lkebnl/CE_HLM/layout_all.png

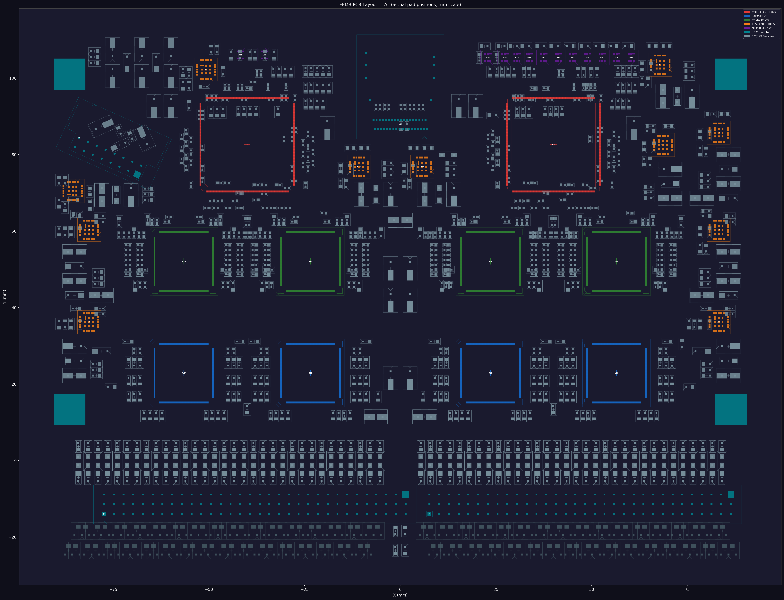
layout_all.png
