lkebnl/CE_HLM/layout_back_All.png

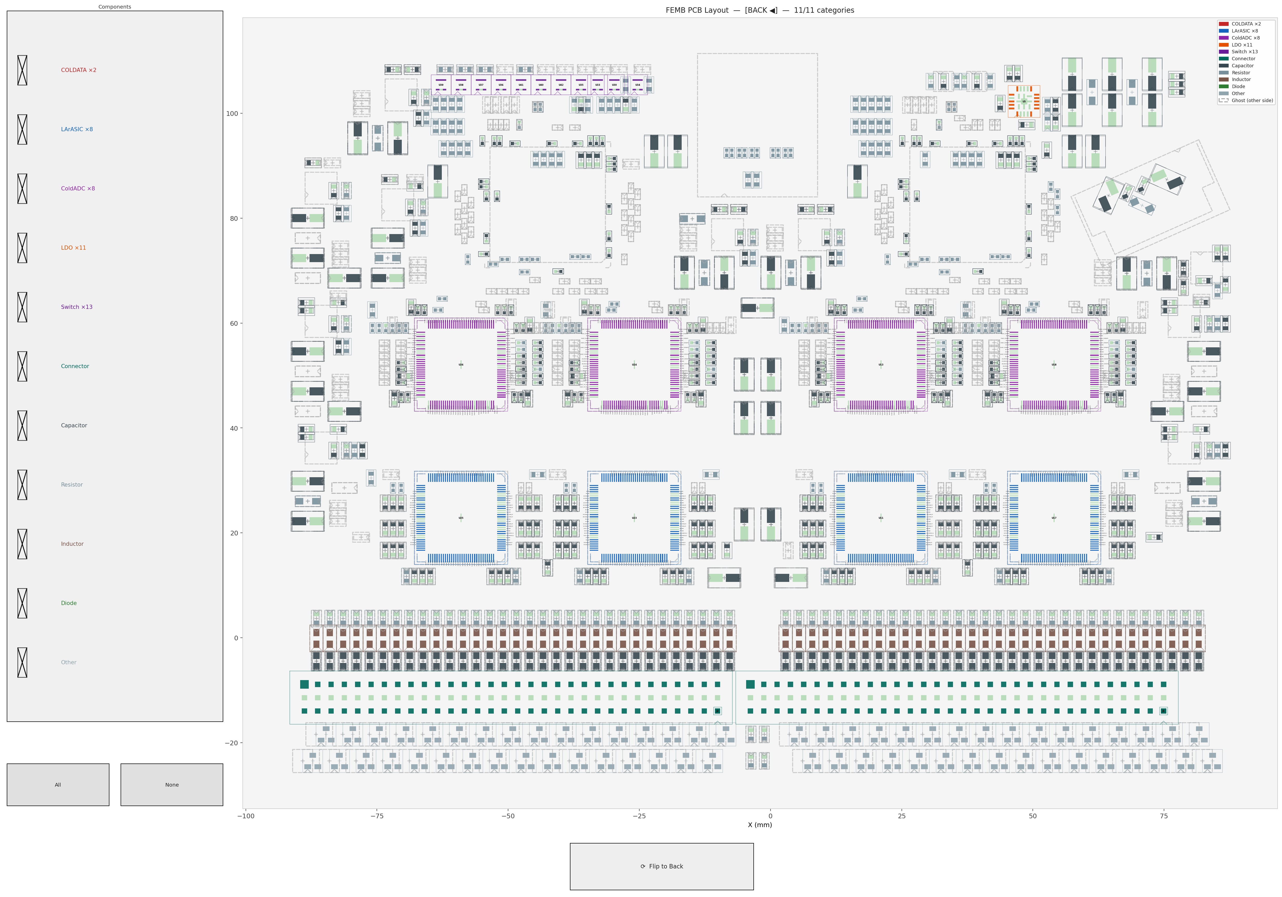
layout_back_All.png
