lkebnl/CE_HLM/layout_back_ICs.png

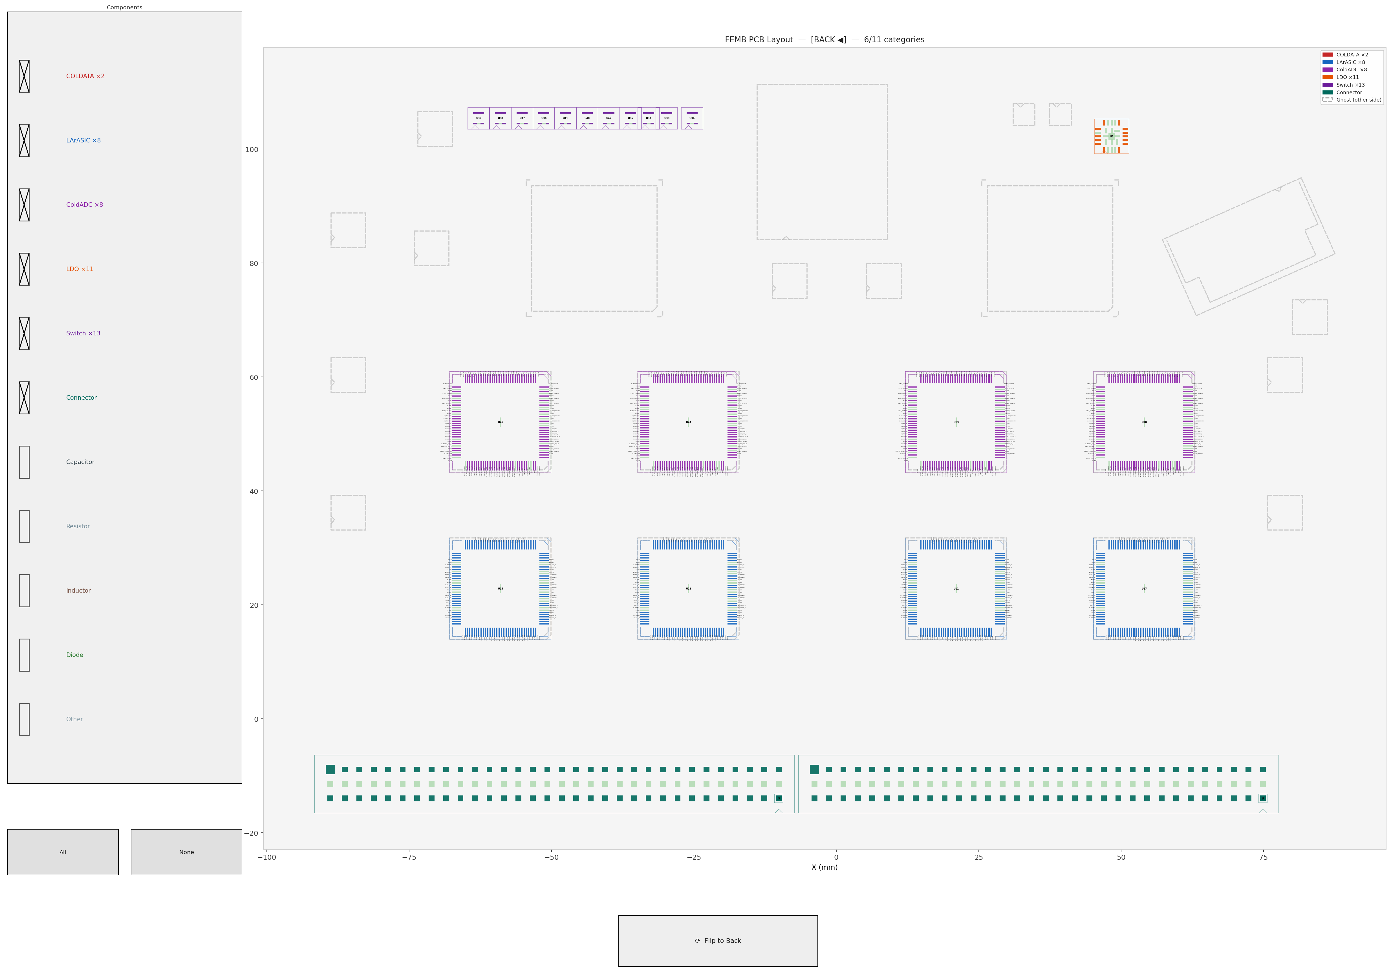
layout_back_ICs.png
