lkebnl/CE_HLM/layout_back_UJP.png

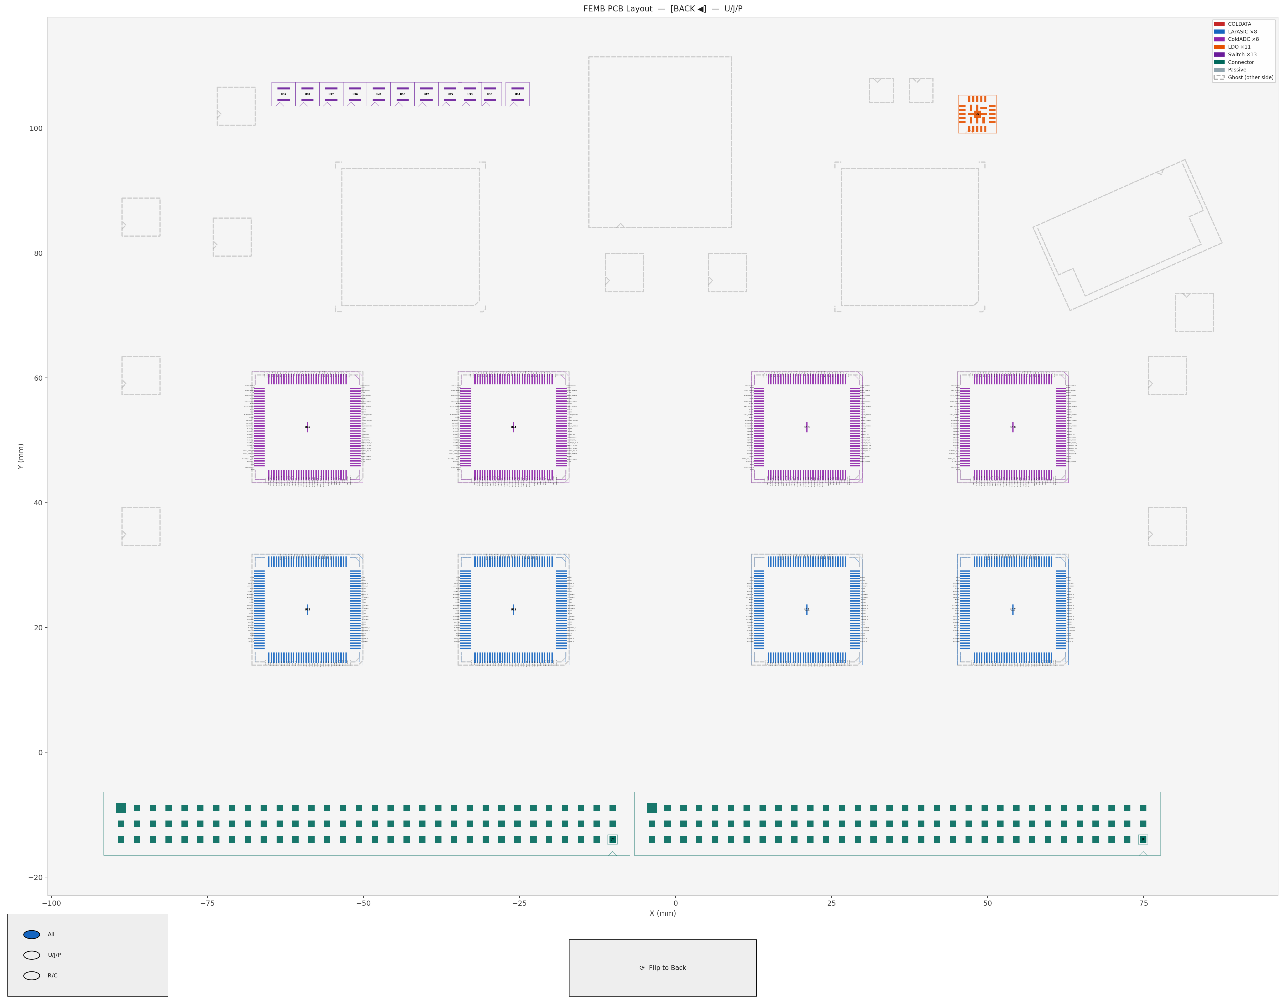
layout_back_UJP.png
