lkebnl/CE_HLM/layout_front_All.png

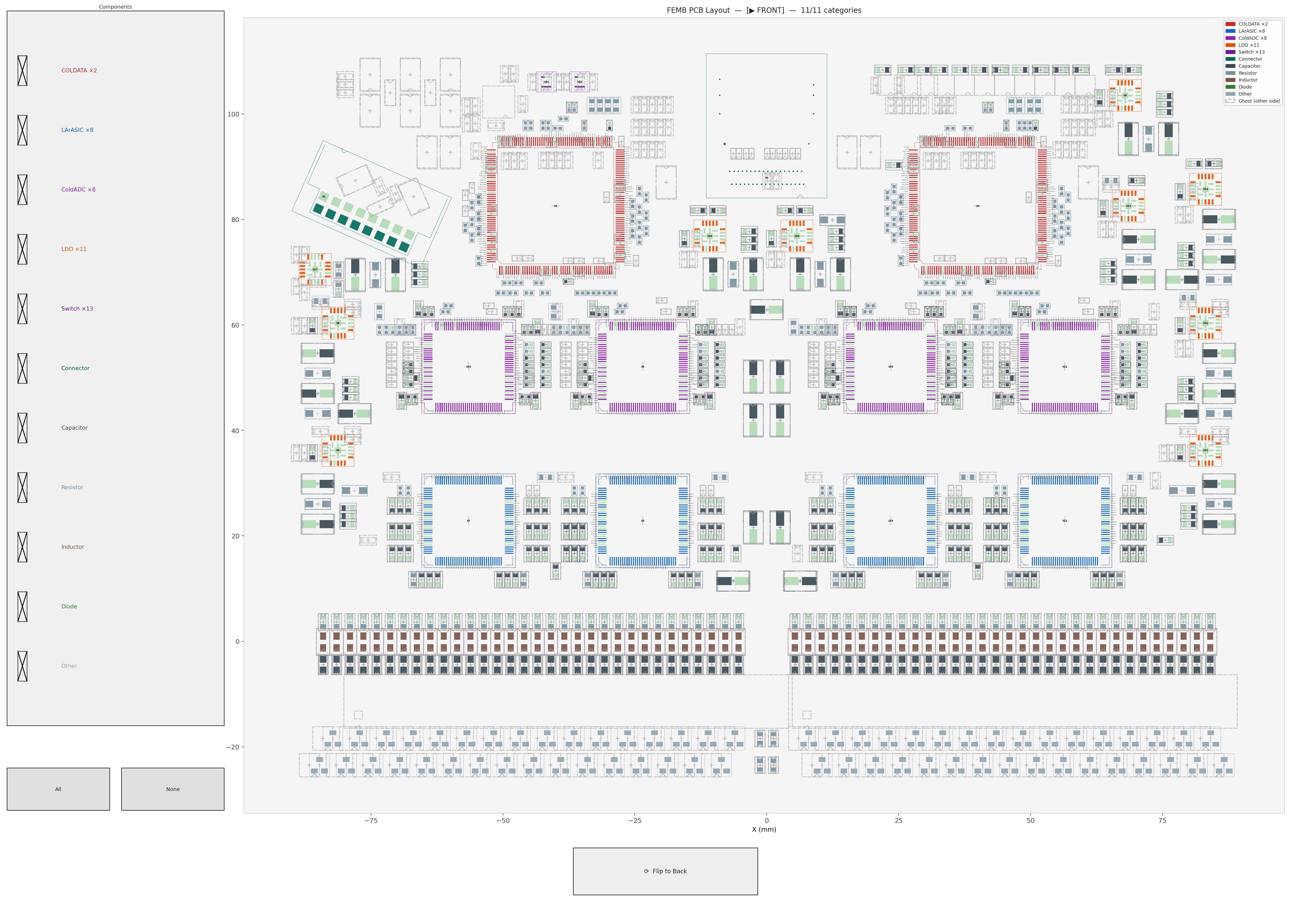
layout_front_All.png
