lkebnl/CE_HLM/layout_front_UJP.png

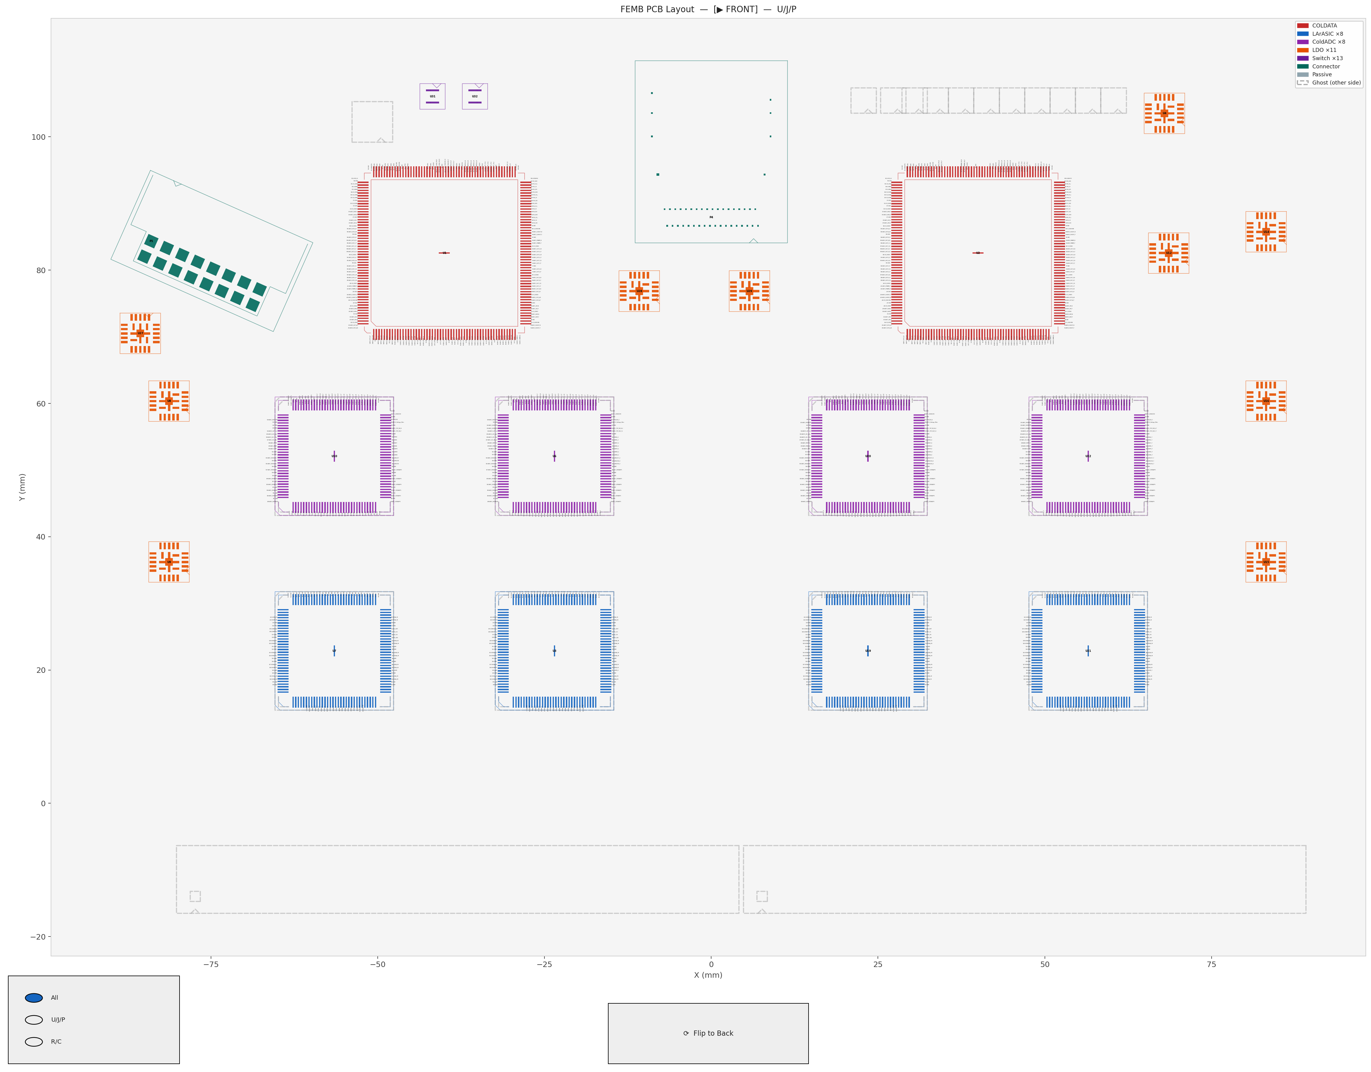
layout_front_UJP.png
