lkebnl/CE_HLM/layout_RC.png

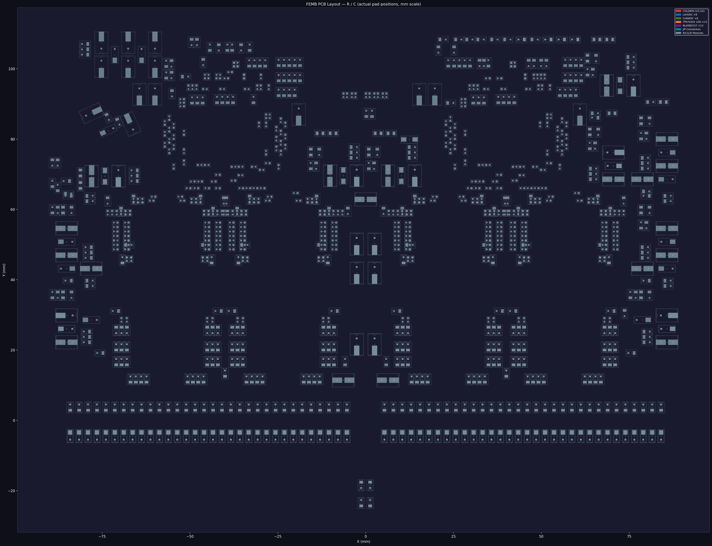
layout_RC.png
