lkebnl/CE_HLM/layout_select_U3.png

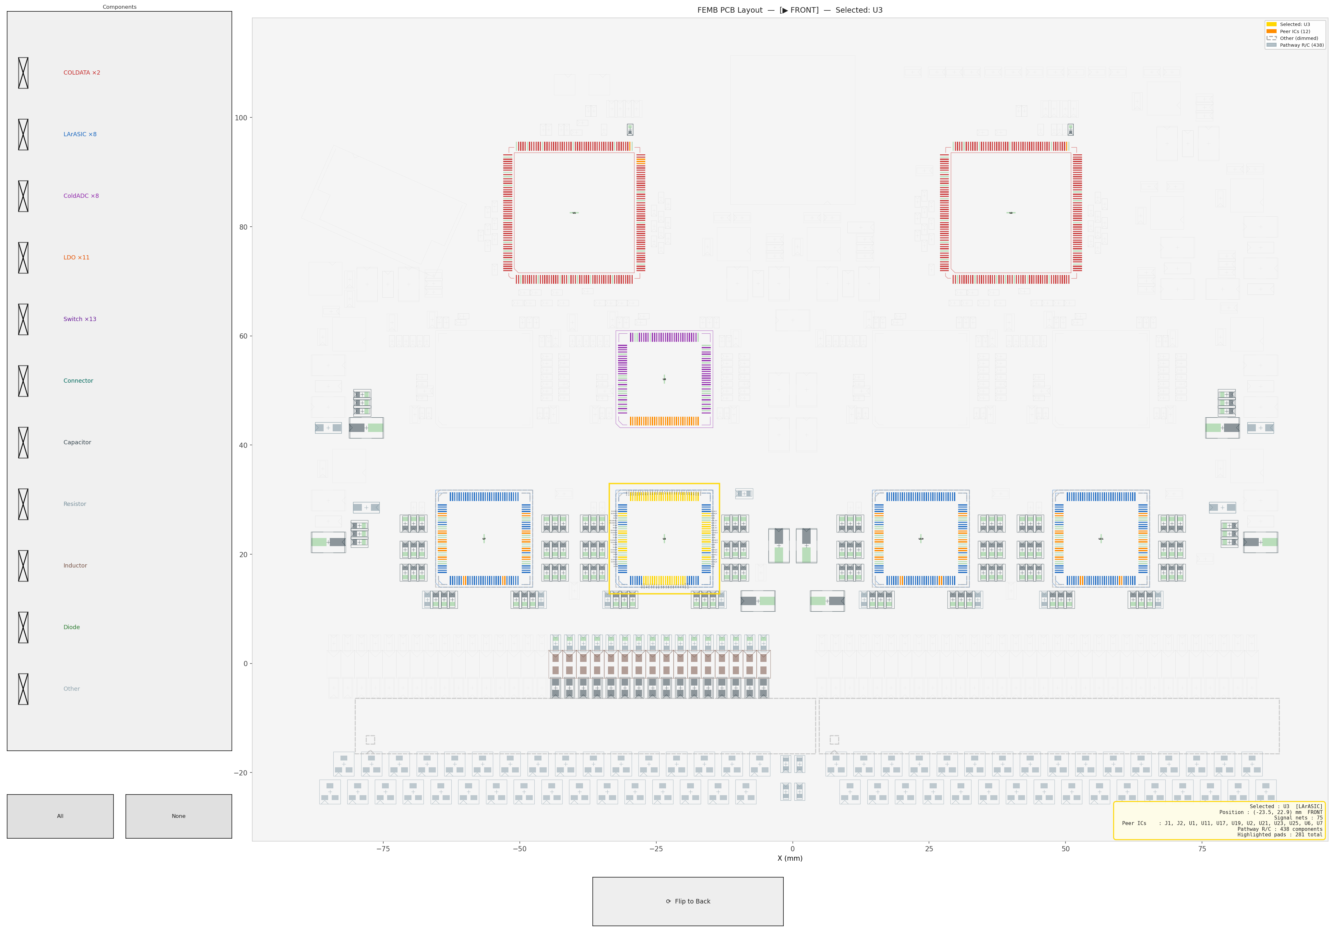
layout_select_U3.png
