lkebnl/CE_HLM/layout_select_U4.png

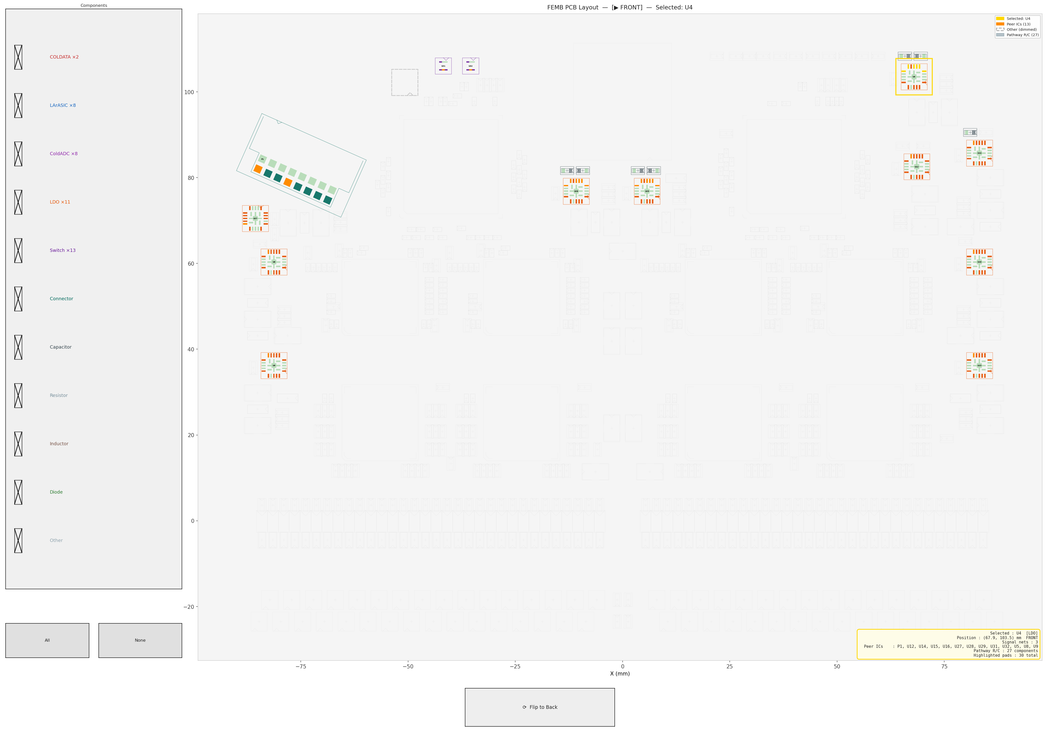
layout_select_U4.png
