lkebnl/CE_HLM/layout_select_U4_ldo.png

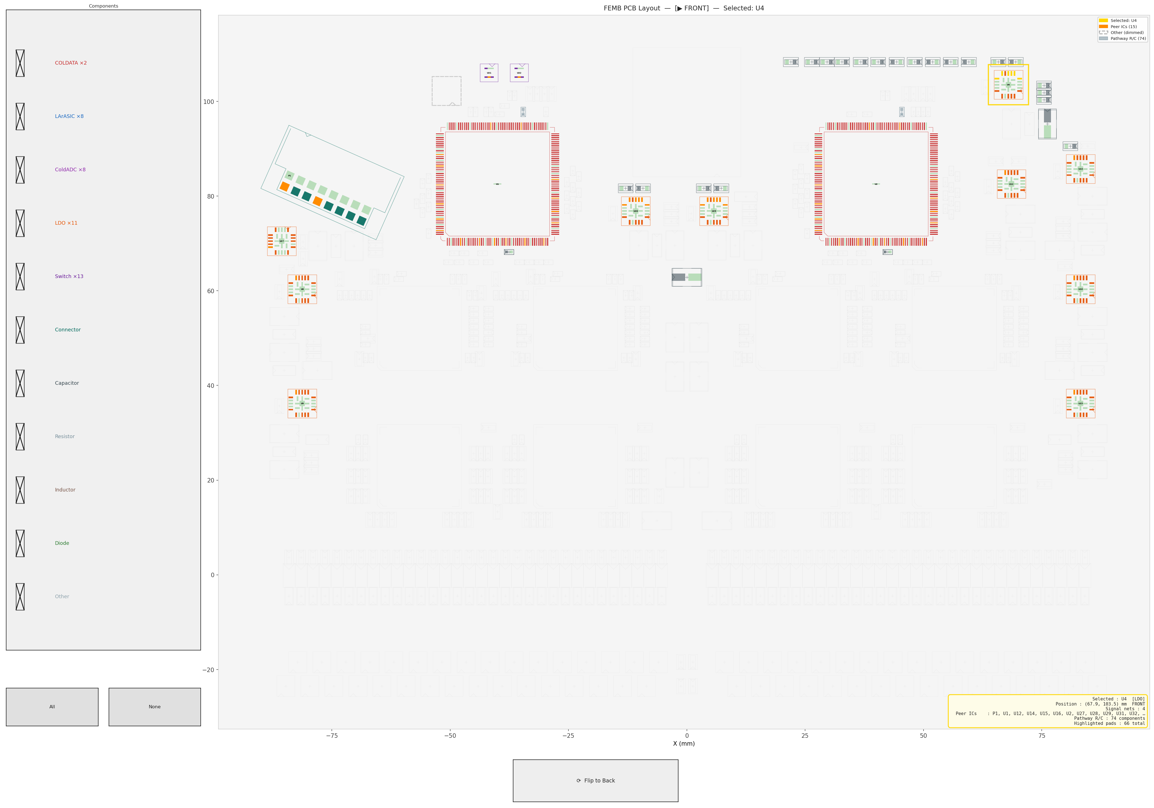
layout_select_U4_ldo.png
