lkebnl/CE_HLM/layout_select_U8_ldo.png

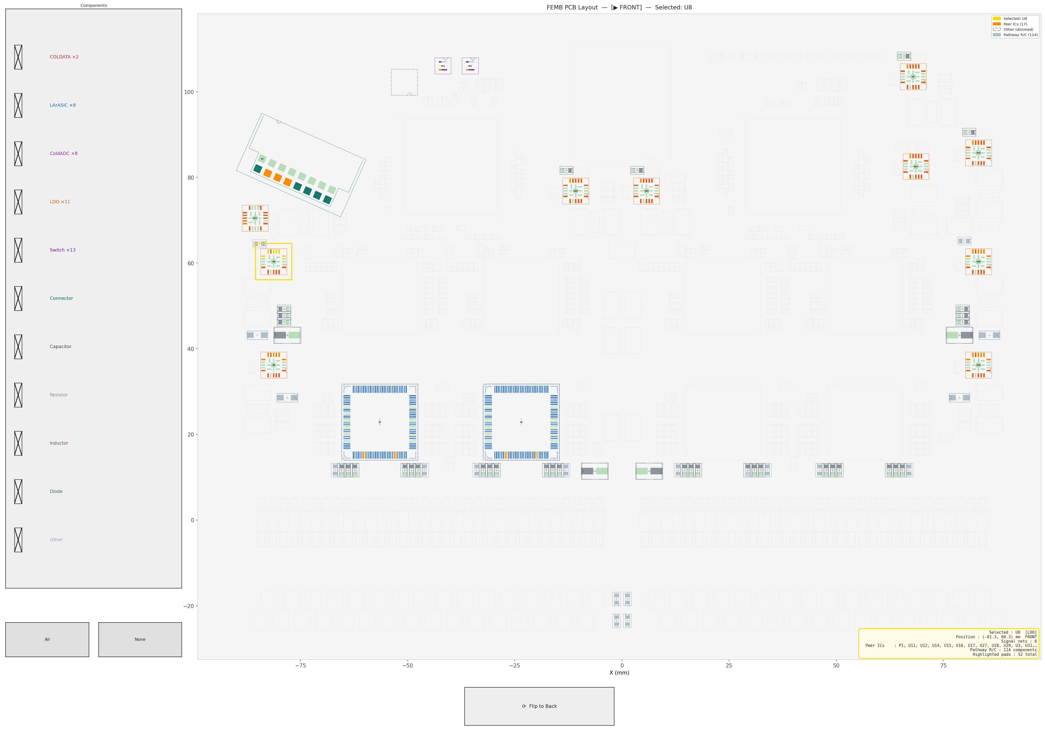
layout_select_U8_ldo.png
