lkebnl/CE_HLM/layout_select_U10.png

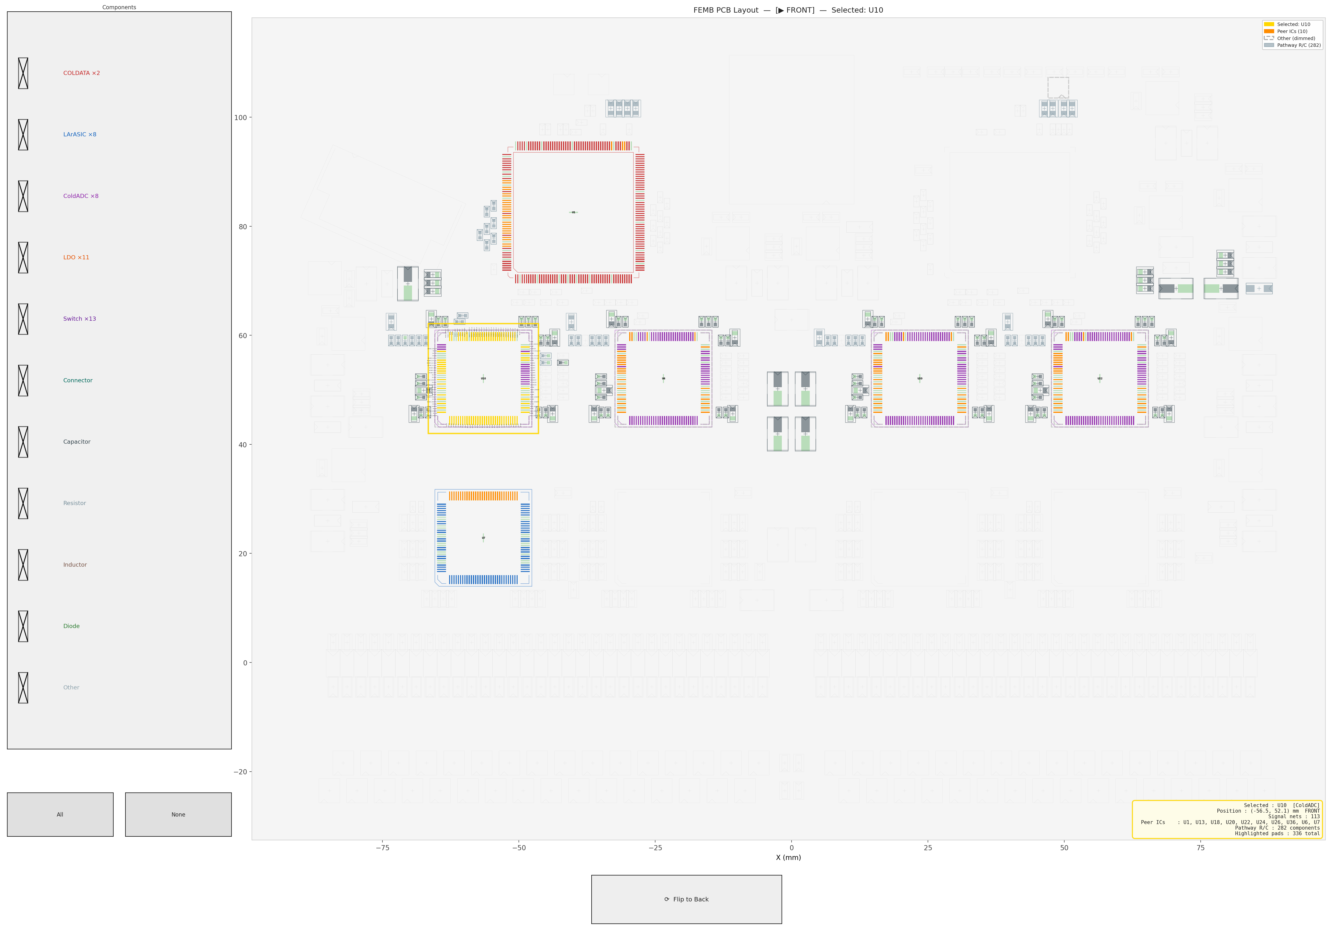
layout_select_U10.png
