lkebnl/CE_HLM/layout_UJP.png

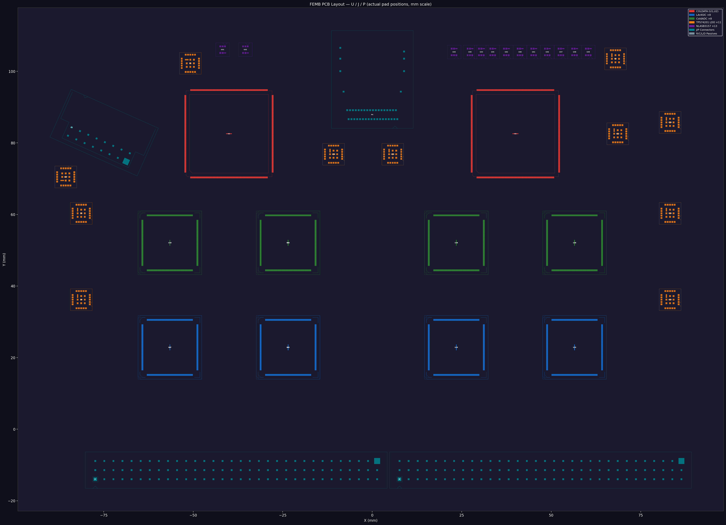
layout_UJP.png
