lkebnl/CE_HLM/zoom_U1.png

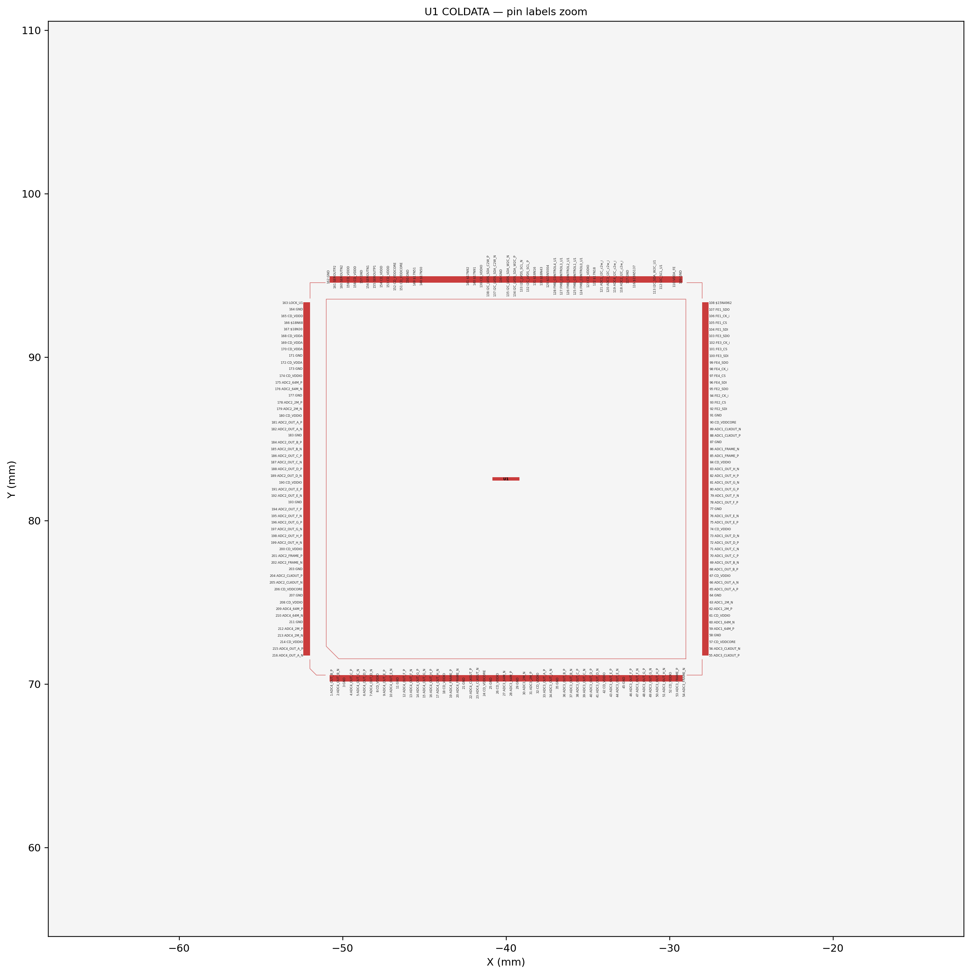
zoom_U1.png
