lkebnl/CE_HLM/zoom_U3.png

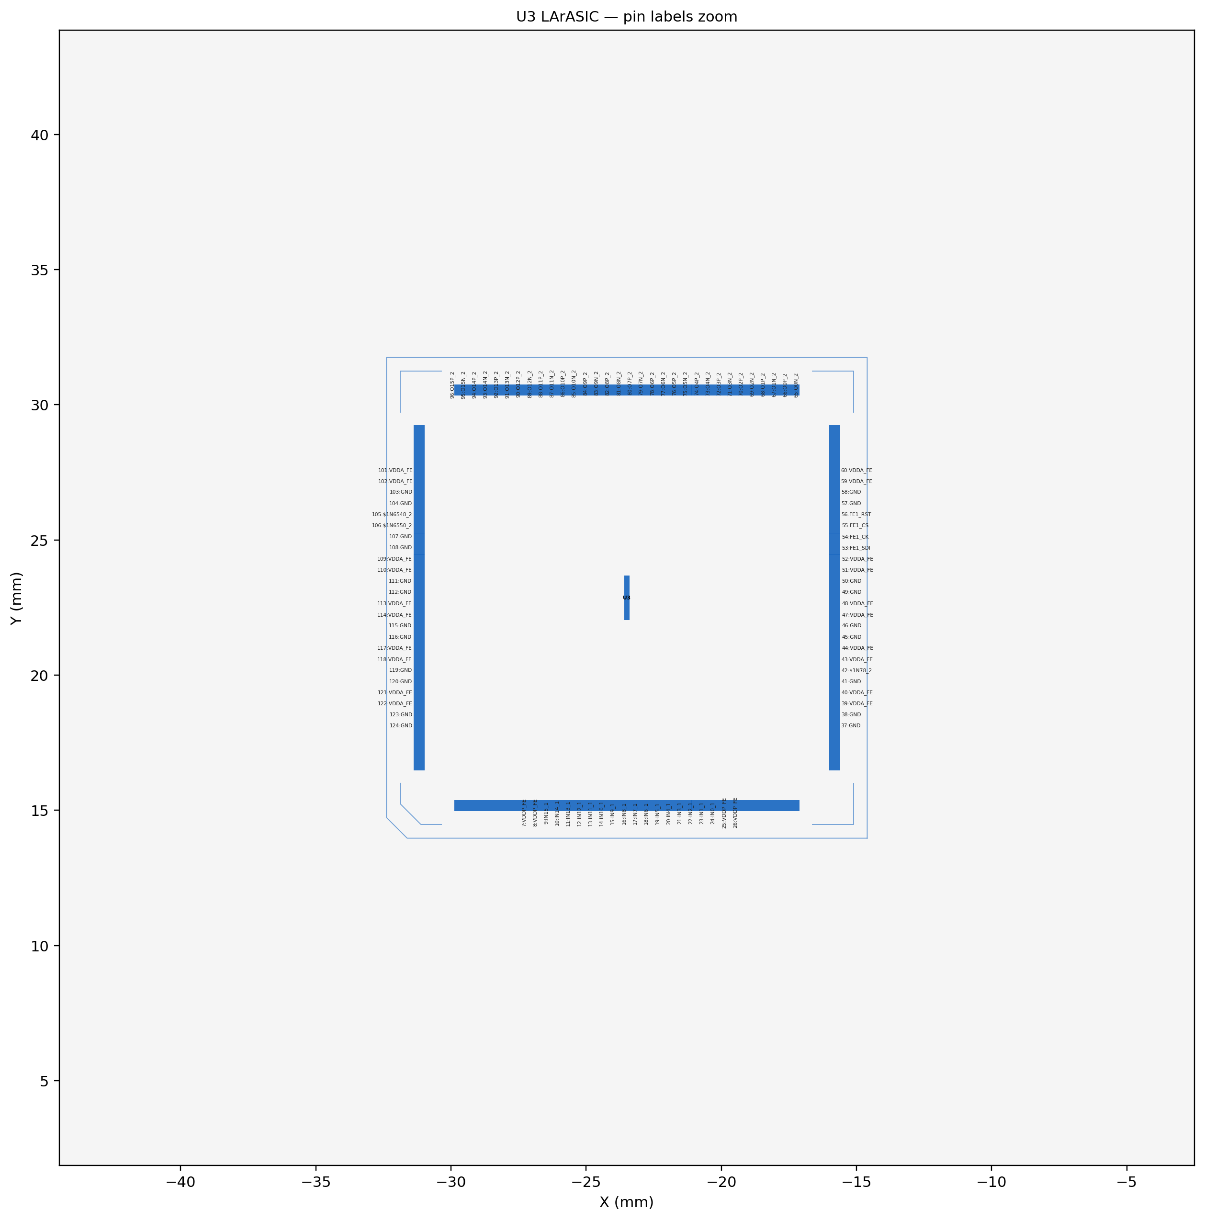
zoom_U3.png
