lkebnl/CE_HLM/FEMB_PADS_EXPORT/01_schematic/schematic_reports/schematic_part_list.xlsx

Part Lister output for DUNE Monolithic FEMB Minisas IO-1865-f
Generated on Saturday, June 06, 2026
# | QTY | DEVICE | DESCRIPTION | VALUE | REFDES | Symbol | Partition
1 | 128 | CC0805 |  | .022uF | C1,C2,C3,C4,C5,C6,C7,C8,C9,C10,C11,C12,C13,C14,C15,C16,C17,C18,C19,C20,C21,C22,C23,C24,C25,C26,C27,C28,C29,C30,C31,C32,C33,C34,C35,C36,C37,C38,C39,C40,C41,C42,C43,C44,C45,C46,C47,C48,C49,C50,C51,C52,C53,C54,C55,C56,C57,C58,C59,C60,C61,C62,C63,C64,C65,C66,C67,C68,C69,C70,C71,C72,C73,C74,C75,C76,C77,C78,C79,C80,C81,C82,C83,C84,C85,C86,C87,C88,C89,C90,C91,C92,C93,C94,C95,C96,C97,C98,C99,C100,C101,C102,C103,C104,C105,C106,C107,C108,C109,C110,C111,C112,C113,C114,C115,C116,C117,C118,C119,C120,C121,C122,C123,C124,C125,C126,C127,C128 | cc0805.2 | DUNE
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
19 | 3 | FIDUCIAL |  |  | FID1,FID2,FID3 | FIDUCIAL.1 | DUNE
20 | 2 | SSW-132-21-G-T |  |  | J1,J2 | SSW_132_02.1 | DUNE
21 | 128 | 55081803400 |  | 10NH | L1,L2,L3,L4,L5,L6,L7,L8,L9,L10,L11,L12,L13,L14,L15,L16,L17,L18,L19,L20,L21,L22,L23,L24,L25,L26,L27,L28,L29,L30,L31,L32,L33,L34,L35,L36,L37,L38,L39,L40,L41,L42,L43,L44,L45,L46,L47,L48,L49,L50,L51,L52,L53,L54,L55,L56,L57,L58,L59,L60,L61,L62,L63,L64,L65,L66,L67,L68,L69,L70,L71,L72,L73,L74,L75,L76,L77,L78,L79,L80,L81,L82,L83,L84,L85,L86,L87,L88,L89,L90,L91,L92,L93,L94,L95,L96,L97,L98,L99,L100,L101,L102,L103,L104,L105,L106,L107,L108,L109,L110,L111,L112,L113,L114,L115,L116,L117,L118,L119,L120,L121,L122,L123,L124,L125,L126,L127,L128 | ind.1 | DUNE
22 | 1 | MTG125/250 |  |  | MT2 | MTG135-250.1 | DUNE
23 | 4 | MTBLOCK |  |  | MT3,MT4,MT5,MT6 | MTG135-250.1 | DUNE
24 | 1 | IPL1-108-01-L-D-RE1-K |  |  | P1 | IPL1-108-01-L-D-RA-K.1 | DUNE
25 | 1 | 0757830132 |  |  | P4 | mini_sas.1 | DUNE
26 | 128 | CR0603 |  | 1G | R1,R2,R3,R4,R5,R6,R7,R8,R9,R10,R11,R12,R13,R14,R15,R16,R17,R18,R19,R20,R21,R22,R23,R24,R25,R26,R27,R28,R29,R30,R31,R32,R33,R34,R35,R36,R37,R38,R39,R40,R41,R42,R43,R44,R45,R46,R47,R48,R49,R50,R51,R52,R53,R54,R55,R56,R57,R58,R59,R60,R61,R62,R63,R64,R65,R66,R67,R68,R69,R70,R71,R72,R73,R74,R75,R76,R77,R78,R79,R80,R81,R82,R83,R84,R85,R86,R87,R88,R89,R90,R91,R92,R93,R94,R95,R96,R97,R98,R99,R100,R101,R102,R103,R104,R105,R106,R107,R108,R109,R110,R111,R112,R113,R114,R115,R116,R117,R118,R119,R120,R121,R122,R123,R124,R125,R126,R127,R128 | res0603.1 | DUNE
27 | 48 | CR0603 |  | 0 | R129,R130,R133,R134,R139,R140,R145,R146,R147,R148,R1065,R1066,R1067,R1068,R1070,R1071,R1072,R1073,R1074,R1075,R1076,R1077,R1078,R1079,R1080,R1081,R1082,R1083,R1087,R1088,R1089,R1090,R1099,R1100,R1101,R1102,R1109,R1112,R1116,R1117,R1118,R1119,R1124,R1125,R1216,R1217,R1256,R1257 | res0603.1,res0603.2 | DUNE
28 | 21 | CR0603 |  | DNI | R131,R132,R135,R136,R137,R138,R155,R164,R165,R166,R176,R177,R181,R1084,R1085,R1086,R1110,R1111,R1113,R1114,R1115 | res0603.1,res0603.2 | DUNE
29 | 14 | CR0603 |  | 2K | R141,R142,R158,R161,R171,R193,R205,R217,R229,R241,R253,R265,R277,R1121 | res0603.1,res0603.2 | DUNE
30 | 3 | CR0603 |  | 2.2K | R143,R144,R578 | res0603.1,res0603.2 | DUNE
31 | 17 | CR0603 |  | 100 | R149,R150,R151,R154,R192,R280,R281,R1064,R1069,R1091,R1092,R1093,R1094,R1095,R1096,R1097,R1098 | res0603.1 | DUNE
32 | 3 | CR0603 |  | 3.57K | R152,R167,R1103 | res0603.2 | DUNE
33 | 5 | CR0603 |  | 1.87K | R153,R156,R168,R169,R1107 | res0603.2 | DUNE
34 | 4 | CR0603 |  | 4.99K | R157,R170,R1106,R1108 | res0603.2 | DUNE
35 | 4 | CR0603 |  | 2.5K | R159,R162,R172,R174 | res0603.2 | DUNE
36 | 4 | CR0603 |  | 1.43K | R160,R163,R173,R175 | res0603.2 | DUNE
37 | 10 | CR1206 |  | 0.1 | R178,R182,R544,R548,R550,R556,R1218,R1242,R1244,R1246 | res1206.1 | DUNE
38 | 15 | CR1206 |  | 0 | R179,R543,R545,R547,R549,R551,R554,R555,R557,R1233,R1243,R1245,R1247,R1248,R1249 | res1206.1 | DUNE
39 | 100 | CR0402 |  | 100 | R180,R255,R256,R366,R367,R473,R474,R594,R595,R701,R702,R808,R809,R915,R916,R1022,R1023,R1126,R1127,R1128,R1129,R1130,R1131,R1132,R1133,R1134,R1135,R1136,R1137,R1138,R1139,R1140,R1141,R1142,R1143,R1144,R1145,R1146,R1147,R1148,R1149,R1150,R1151,R1152,R1153,R1154,R1155,R1156,R1157,R1158,R1159,R1160,R1161,R1162,R1163,R1164,R1165,R1166,R1167,R1168,R1169,R1170,R1171,R1172,R1173,R1174,R1175,R1176,R1177,R1178,R1179,R1180,R1181,R1182,R1183,R1184,R1185,R1186,R1187,R1188,R1189,R1190,R1191,R1192,R1193,R1194,R1195,R1196,R1197,R1198,R1199,R1200,R1201,R1202,R1203,R1204,R1205,R1210,R1211,R1212 | res0402.1 | DUNE
40 | 24 | CR0402 |  | 50 | R254,R257,R258,R365,R368,R369,R472,R475,R476,R593,R596,R597,R700,R703,R704,R807,R810,R811,R914,R917,R918,R1021,R1024,R1025 | res0402.1 | DUNE
41 | 24 | CR0402 |  | 2.2K | R259,R260,R261,R370,R371,R372,R477,R478,R479,R598,R599,R600,R705,R706,R707,R812,R813,R814,R919,R920,R921,R1026,R1027,R1028 | res0402.1 | DUNE
42 | 30 | CR0402 |  | DNI | R262,R263,R264,R373,R374,R375,R480,R481,R482,R601,R602,R603,R708,R709,R710,R815,R816,R817,R922,R923,R924,R1029,R1030,R1031,R1220,R1222,R1236,R1237,R1239,R1241 | res0402.1 | DUNE
43 | 2 | CR1206 |  | DNI | R546,R1250 | res1206.1 | DUNE
44 | 1 | CR0603 |  | 1.96K | R1104 | res0603.2 | DUNE
45 | 1 | CR0603 |  | 2.49K | R1105 | res0603.2 | DUNE
46 | 2 | CR0603 |  | 1K | R1120,R1123 | res0603.1 | DUNE
47 | 1 | CR0603 |  | 4K | R1122 | res0603.1 | DUNE
48 | 35 | CR0402 |  | 0 | R1206,R1207,R1208,R1209,R1213,R1214,R1215,R1223,R1224,R1225,R1226,R1227,R1228,R1229,R1230,R1231,R1232,R1234,R1240,R1265,R1266,R1267,R1268,R1269,R1270,R1271,R1272,R1273,R1274,R1275,R1276,R1277,R1278,R1279,R1280 | res0402.1 | DUNE
49 | 4 | CR0402 |  | 10K | R1219,R1221,R1235,R1238 | res0402.1 | DUNE
50 | 6 | TESTPAD |  |  | TP1,TP2,TP4,TP5,TP6,TP7 | testpoint_pad.1 | LBNE
51 | 12 | IC_COLDDATA_P3 |  |  | U1,U1,U1,U1,U1,U1,U2,U2,U2,U2,U2,U2 | Coldata_P3_ADC.1,Coldata_P3_ASIC.1,Coldata_P3_I2C.1,Coldata_P3_LarASIC.1,Coldata_P3_PWR.1,Coldata_P3_WIB.1 | DUNE
52 | 8 | LAr_ASIC_P4 |  |  | U3,U7,U11,U17,U19,U21,U23,U25 | LAr_ASIC_P4.1 | DUNE
53 | 11 | TPS74201 |  |  | U4,U5,U8,U9,U12,U14,U15,U16,U27,U28,U29 | TPS74218.2 | DUNE
54 | 32 | COLD_ADC_P2 |  |  | U6,U6,U6,U6,U10,U10,U10,U10,U13,U13,U13,U13,U18,U18,U18,U18,U20,U20,U20,U20,U22,U22,U22,U22,U24,U24,U24,U24,U26,U26,U26,U26 | coldadc_p2_config.1,coldadc_p2_gnd.1,coldadc_p2_inout.1,coldadc_p2_power.1 | LBNE
55 | 13 | NLASB3157 |  |  | U30,U31,U32,U33,U34,U35,U36,U37,U38,U39,U40,U41,U42 | NLASB3157.3 | DUNE
