lkebnl/CE_HLM/FEMB_PADS_EXPORT/01_schematic/schematic_pdf/schematic_full.pdf

B | C | D | E | F

1

2

3

4

1

A | B | C | D | E | F

A

SIZE
DRAWN : | DATE :

TITLE

B

## BROOKHAVEN NATIONAL LABORATORY

Jack Fried

BOARD :

## INSTRUMENTATION DIVISION

DUNE_AM V2
17/03/2023:15:04

# DUNE Monolithic Minisas FEMB ver F

# SHEET 1: SHEET 2: Power IN & AC Coupling Reulator SHEET 3: SHEET 4: SHEET 5: SHEET 6:

# SHEET 8: SHEET 9: SHEET 10: SHEET 11: SHEET 12: SHEET 13: SHEET 14: SHEET 15: SHEET 16:

# SHEET 30:

# FE ASIC 1

# Power Left ADC Regulator Power Left FE ASIC Regulator Power Right ADC

# Signal Inputs Input Protection Diodes 1

# Input Caps and Inductors FE-ADC ASICs 1 and 2

# ADC ASIC 1

# FE-ADC ASICs 3 and 4

# TABLE OF CONTENTS

# SHEET 7:

# Input Protection Diodes 2

# SHEET 31:

# Power Right FE ASIC

# FE ASIC 2 ADC ASIC 2

# FE ASIC 3

# ADC ASIC 3 FE ASIC 4 ADC ASIC 4

# Title

# FE ASIC 5

# FE-ADC ASICs 5 and 6

# ADC ASIC 5

# FE-ADC ASICs 7 and 8

# FE ASIC 6 ADC ASIC 6

# FE ASIC 7 ADC ASIC 7 FE ASIC 8 ADC ASIC 8

# SHEET 17:

# SHEET 18: SHEET 19: SHEET 20: SHEET 21: SHEET 22: SHEET 23: SHEET 24: SHEET 25: SHEET 26: SHEET 27: SHEET 28: SHEET 29:

# SHEET 32:

# SHEET 34: SHEET 35: SHEET 36: SHEET 37: SHEET 38:

# SHEET 33:

# CDM TERM L and ASIC IO

# CDM WIB interface

# CDM TERM R and ASIC IO

# CDM Left msic io CDM Right msic io CDM ASIC power IO CDM PWR 1_2V and 1_1V CDM EXT DAC or REG CONTROL SHEET 39: ColdADC Voltage Monitor Select

4

# Board Power (voltage measured at FEMB)

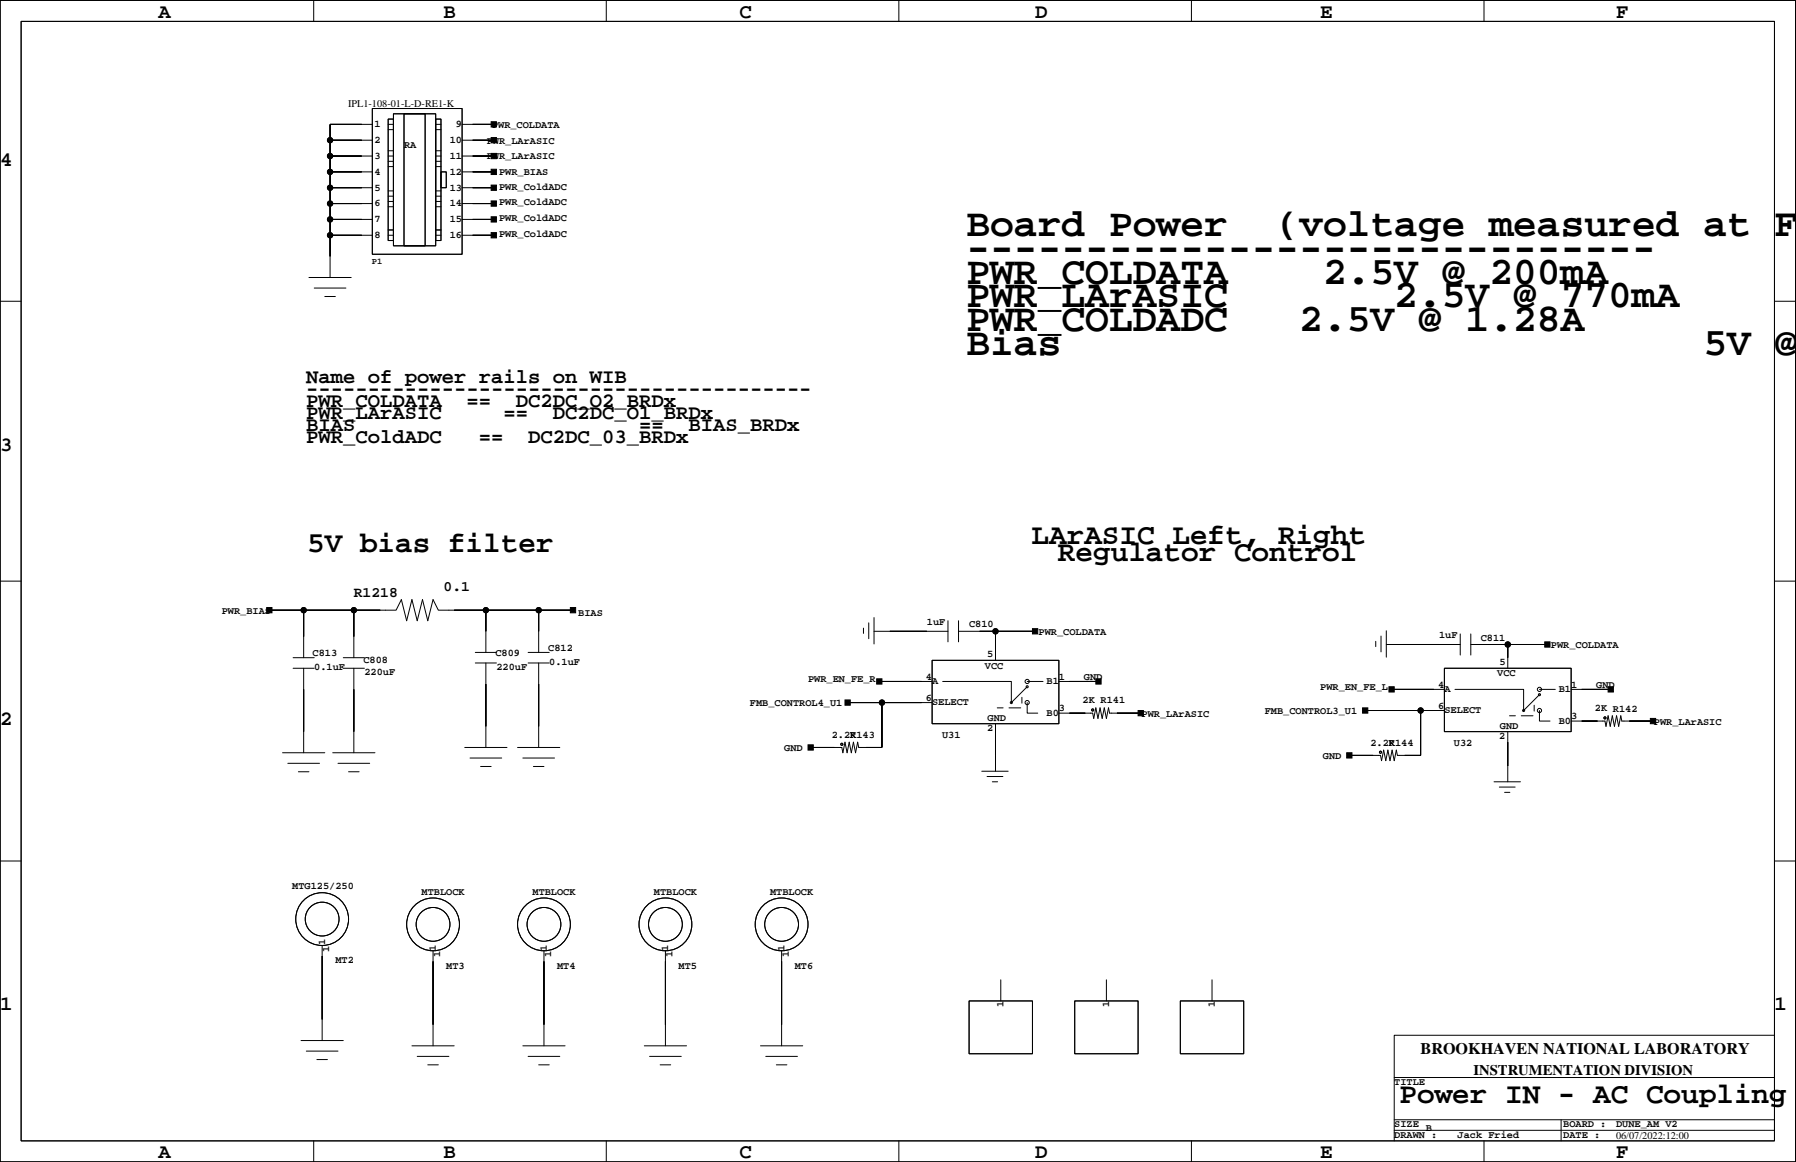
[picture p16: page 2]

Name of power rails on WIB

LArASIC Left, Right Regulator Control

BROOKHAVEN NATIONAL LABORATORY
Power IN - AC Coupling Reulator

4

R1780.1 | R179 0

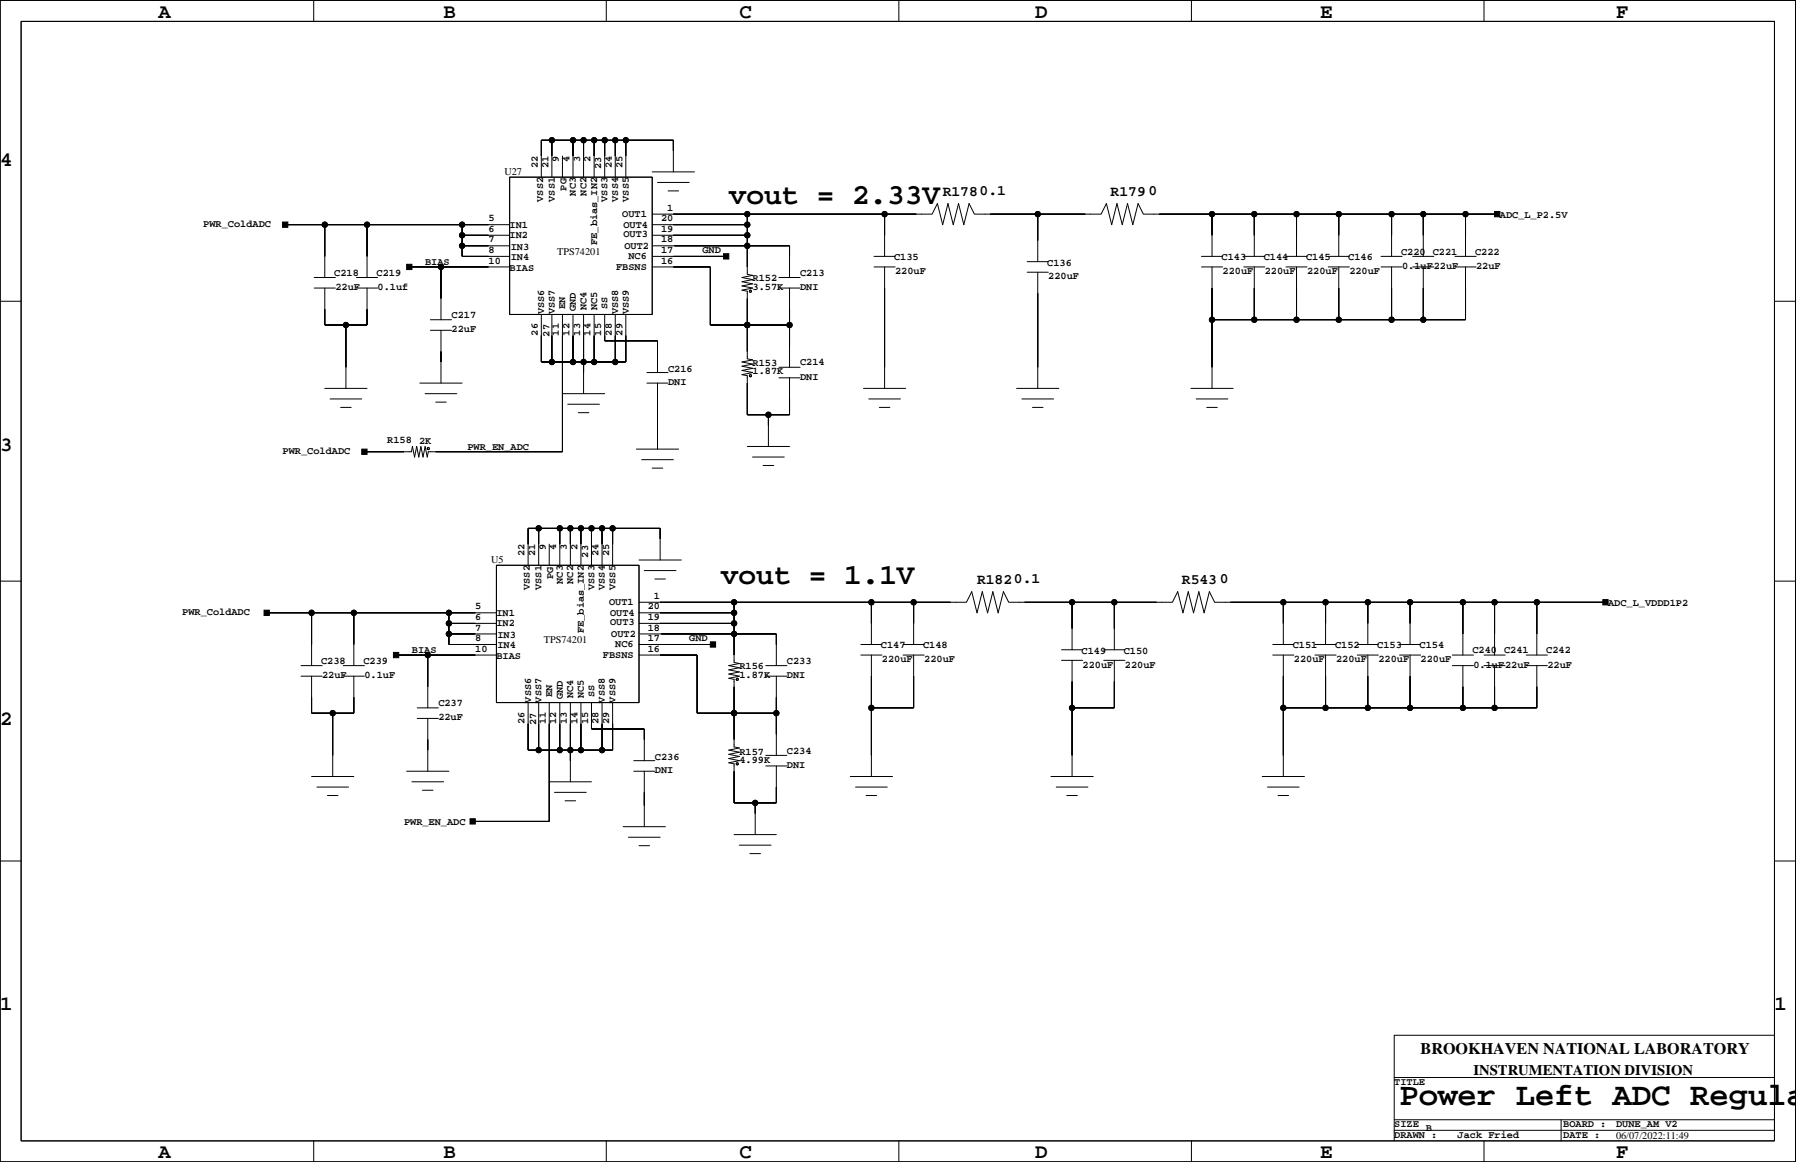
[picture p17: page 3]

BROOKHAVEN NATIONAL LABORATORY
Power Left ADC Regulator

4
R546DNI | R547 0

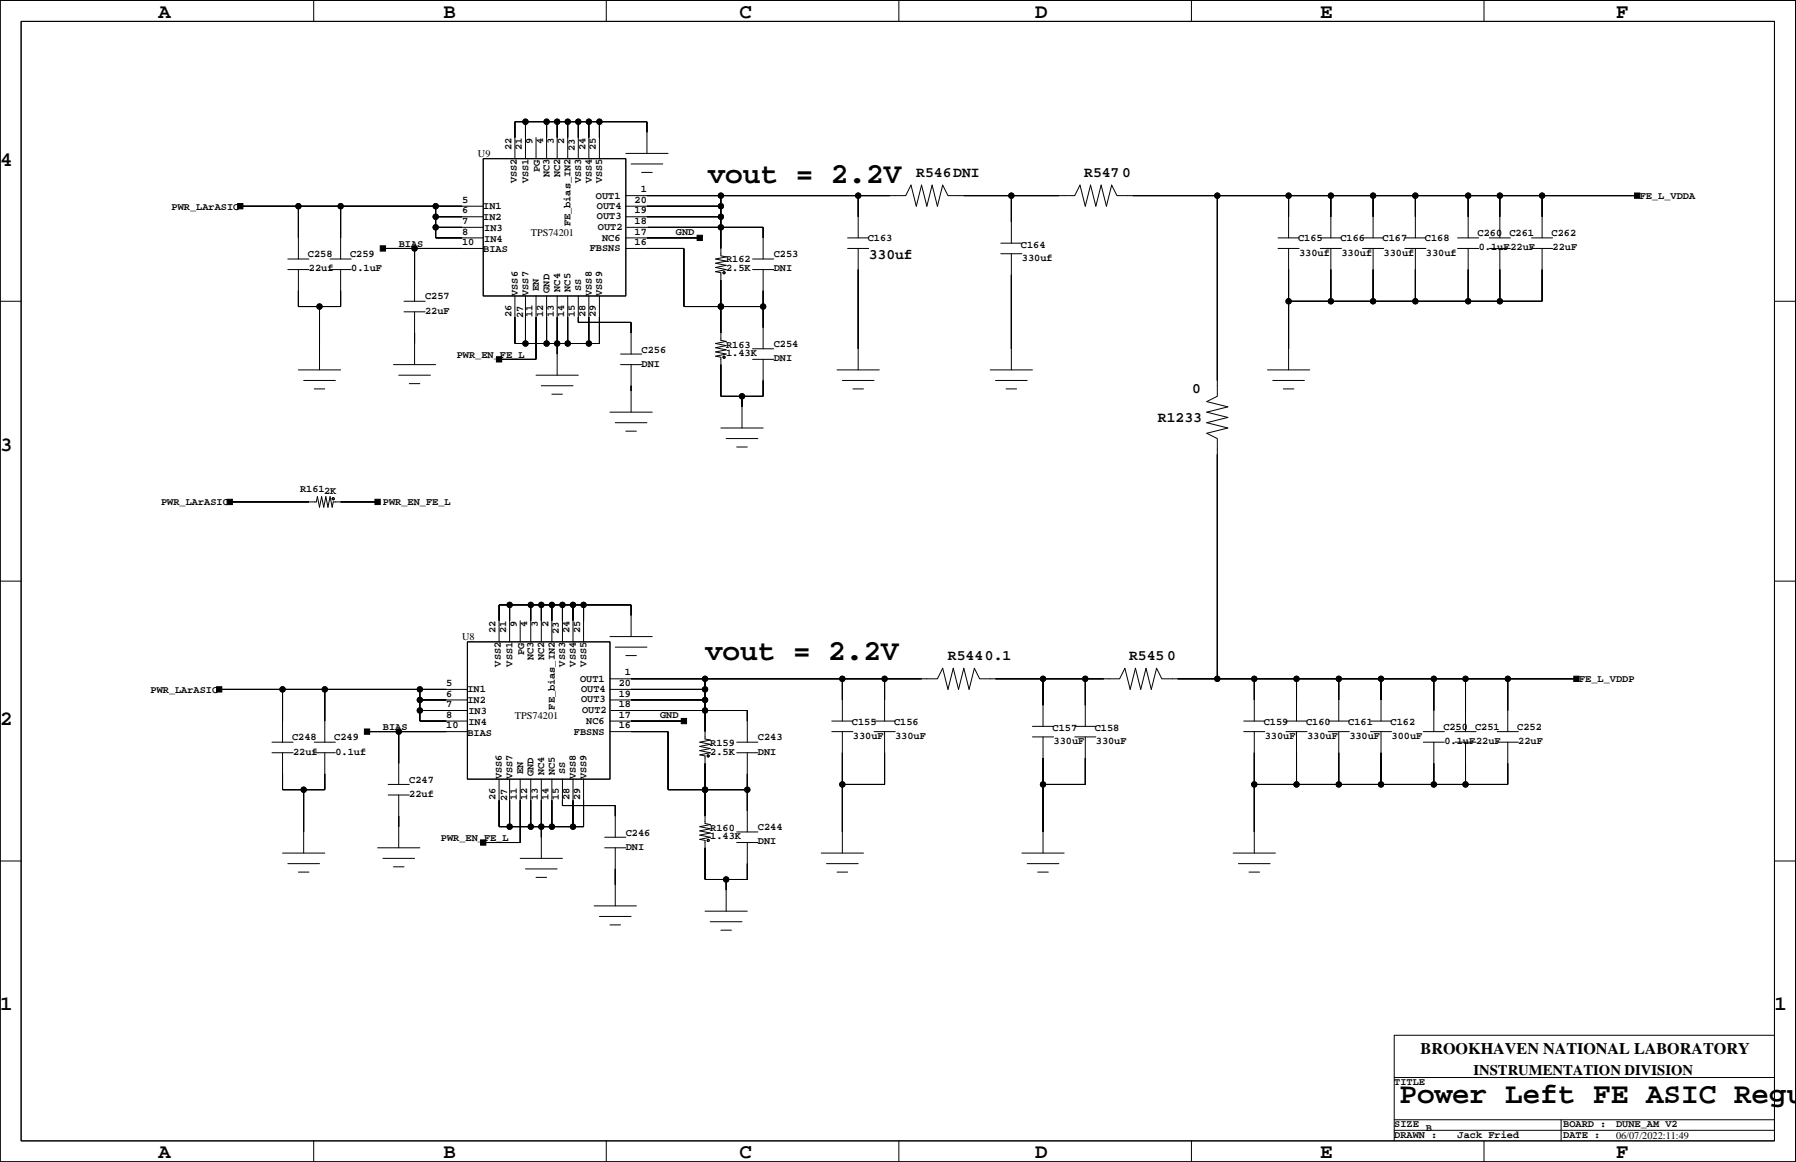
[picture p18: page 4]

BROOKHAVEN NATIONAL LABORATORY
Power Left FE ASIC Regulator

4
R5500.1 | R551 0

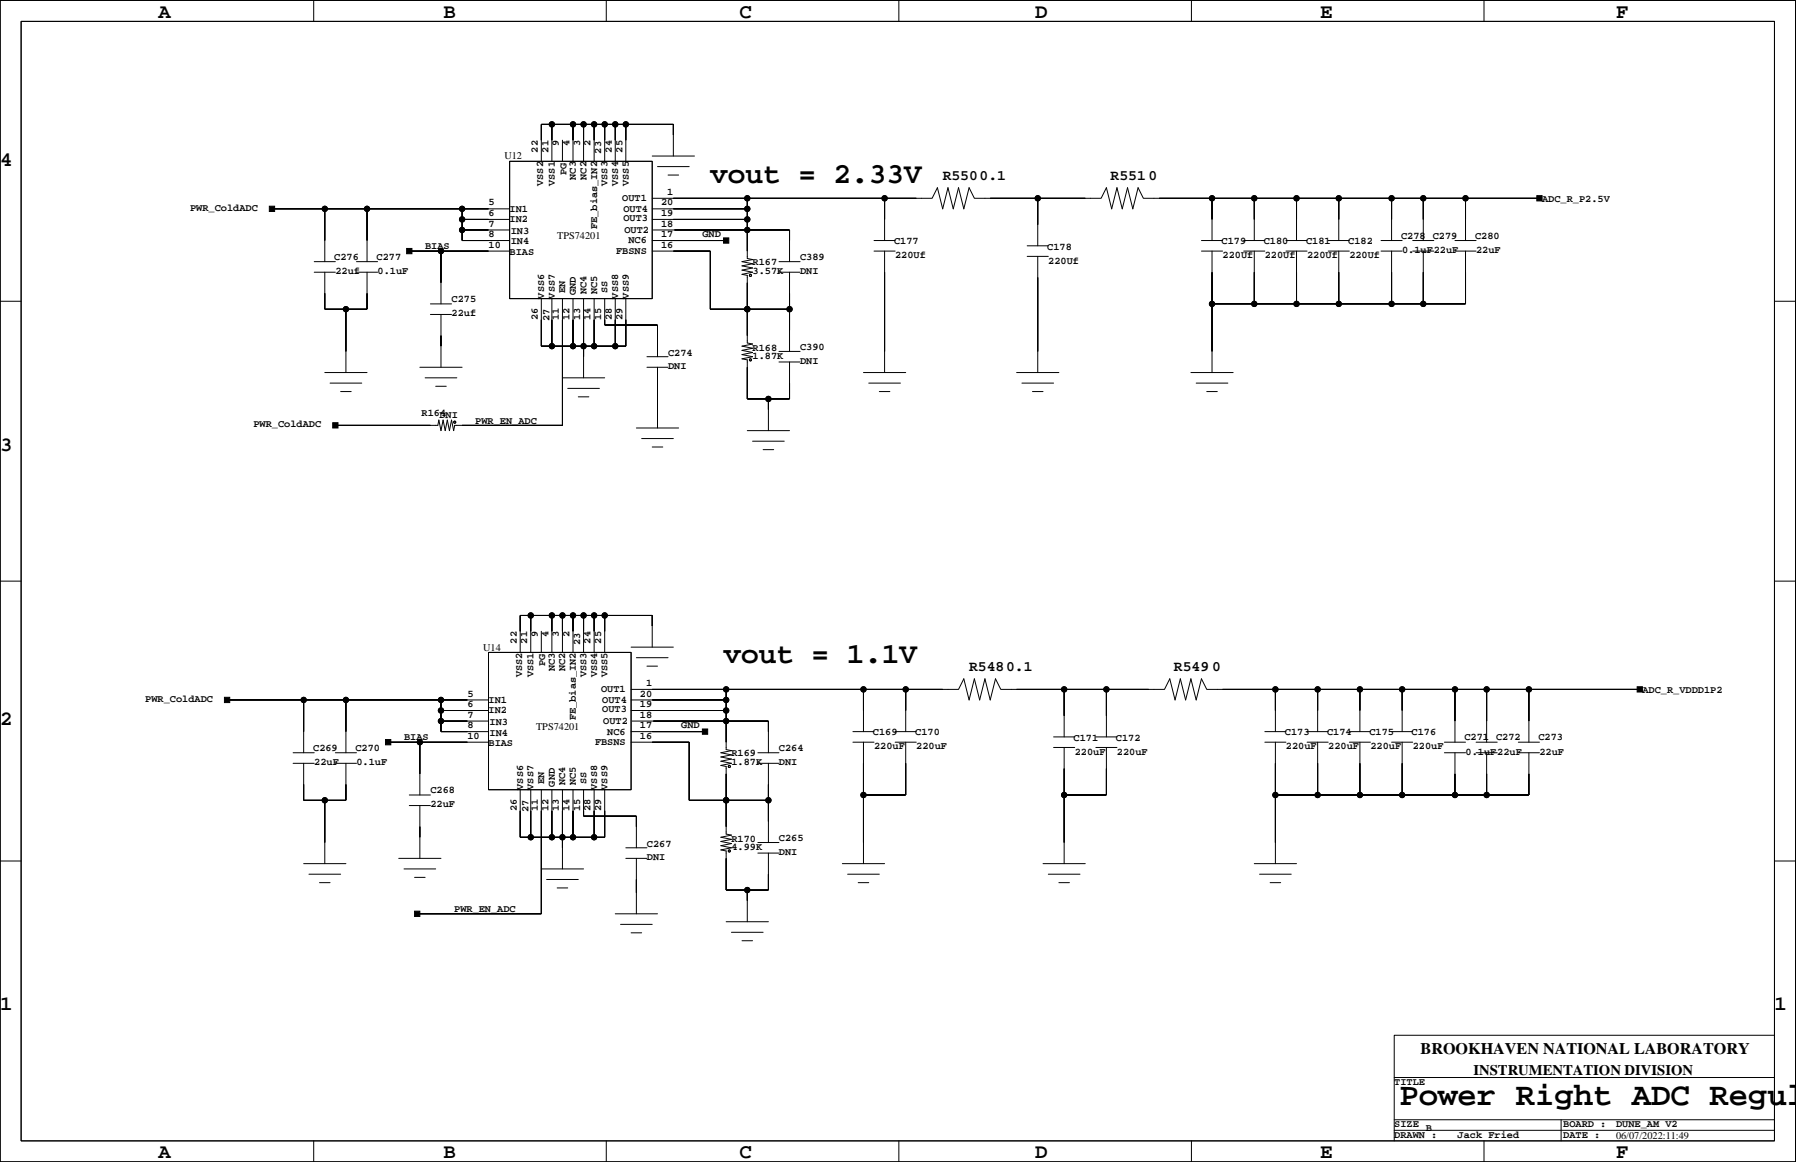
[picture p19: page 5]

BROOKHAVEN NATIONAL LABORATORY
Power Right ADC Regulator

4
R5540 | R555 0

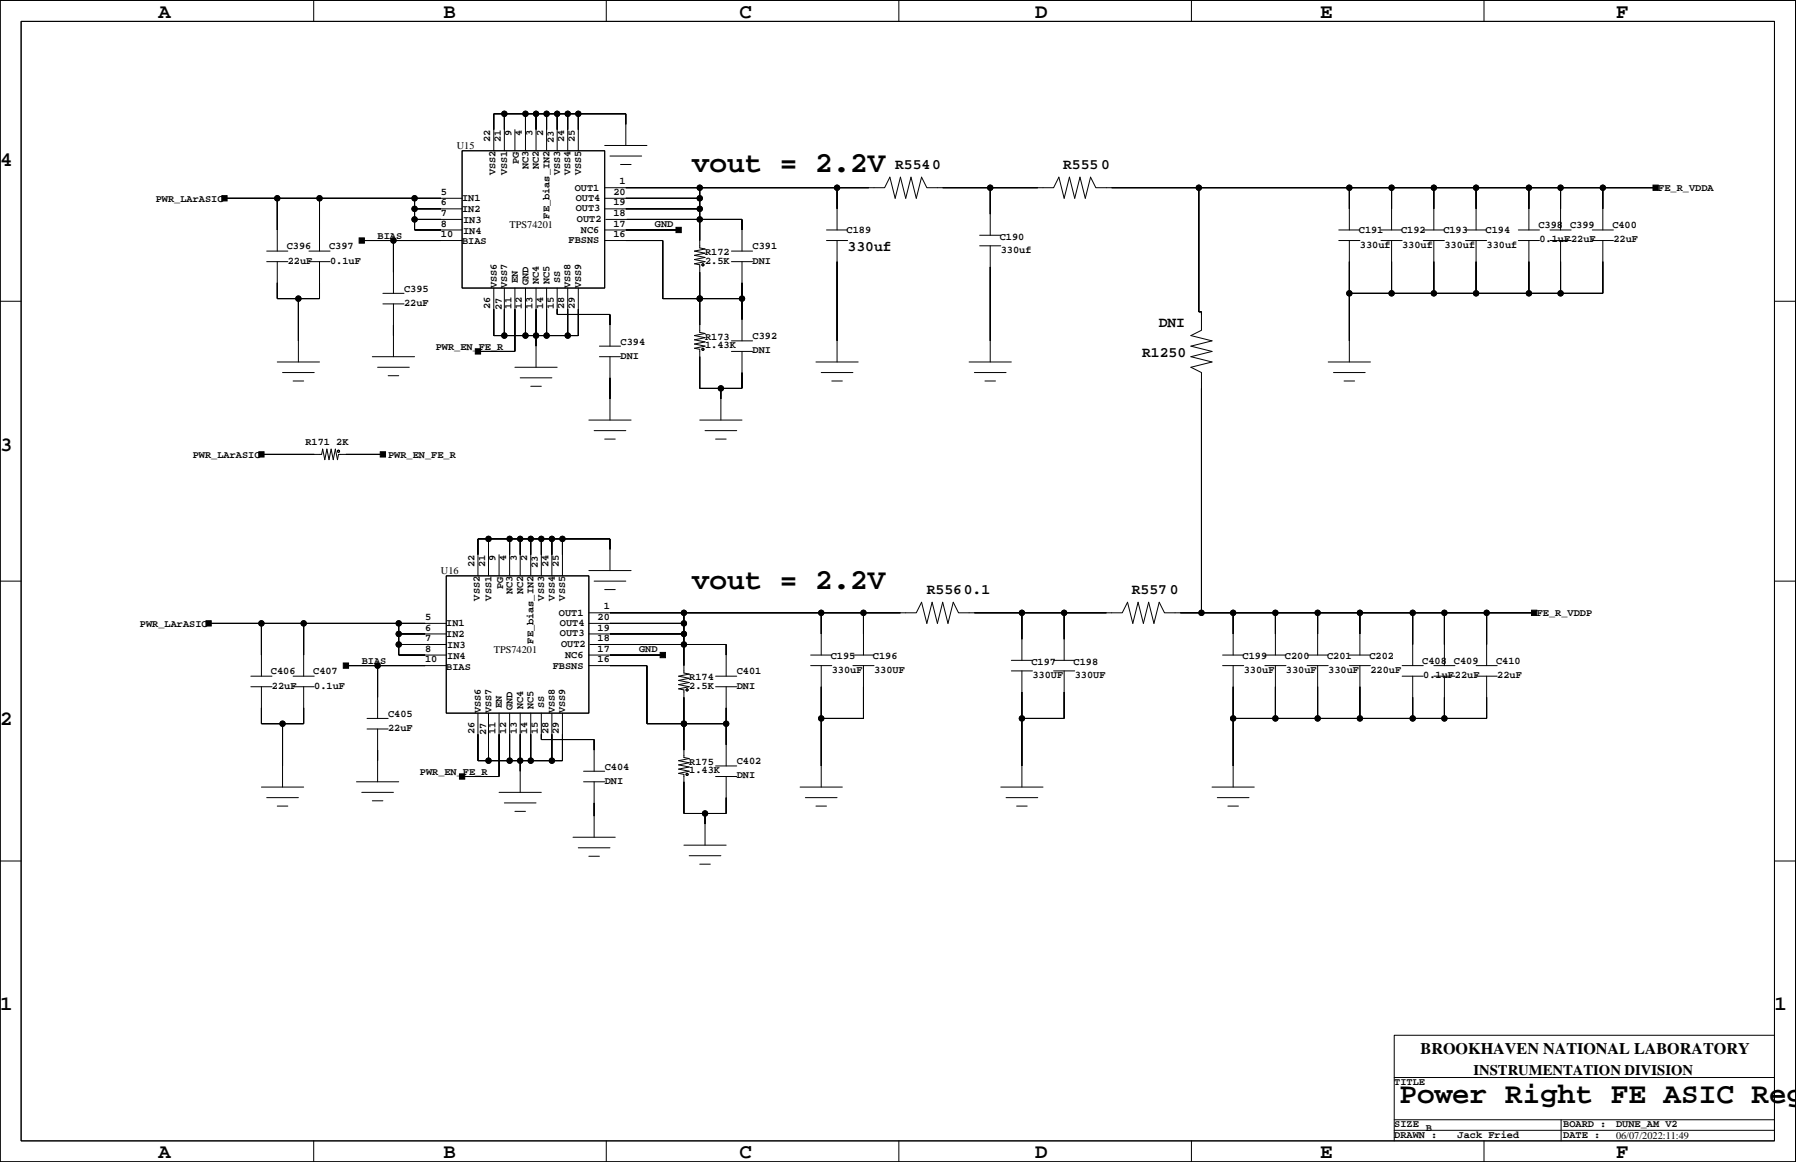
[picture p20: page 6]

BROOKHAVEN NATIONAL LABORATORY
Power Right FE ASIC Regulator

C

D

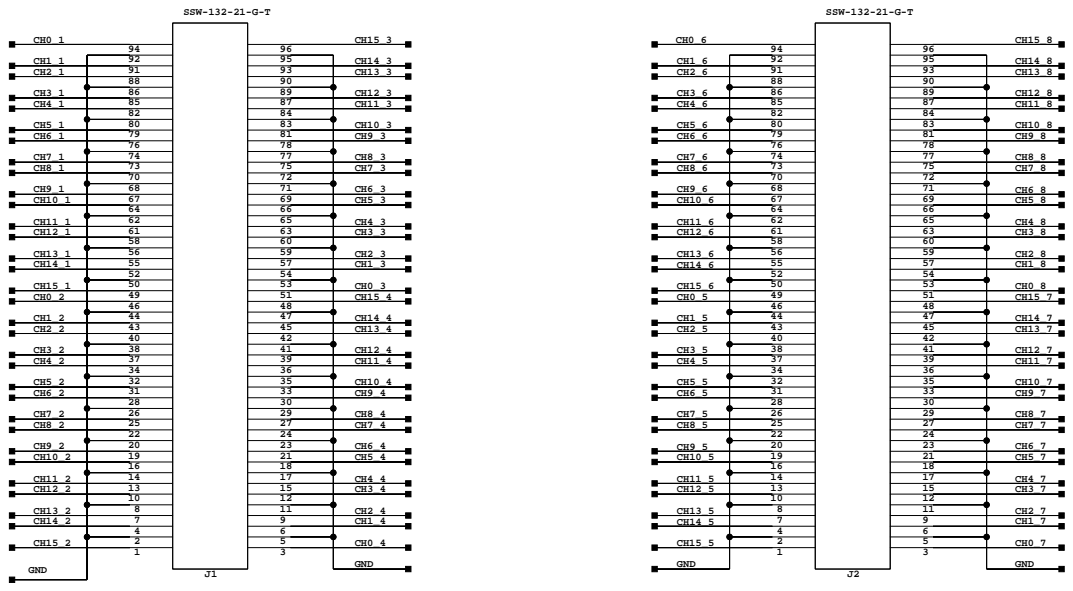
[picture p21: page 7]
DUNE_AM V2; GND; GND GND; SSW-132-21-G-T; SSW-132-21-G-T 12478

BROOKHAVEN NATIONAL LABORATORY
Signal Inputs

C

D

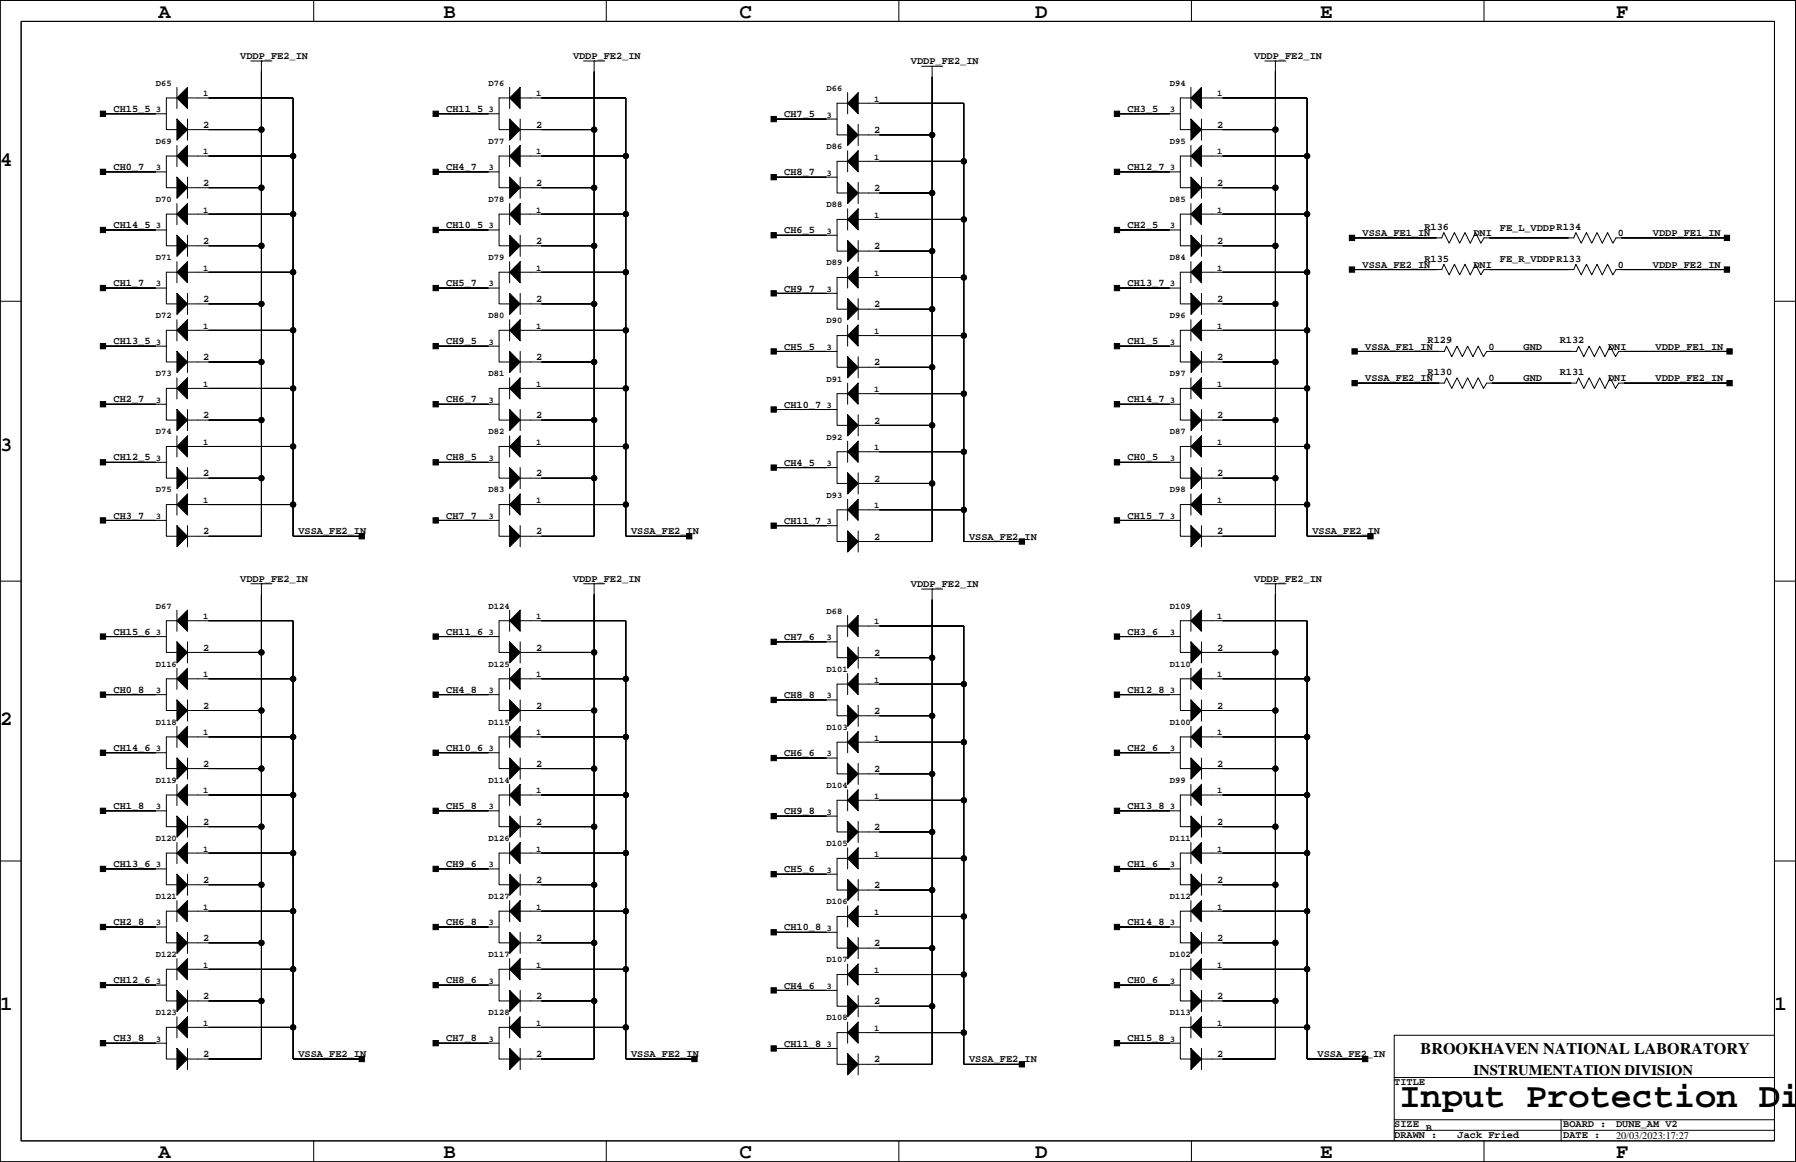
[picture p22: page 8]

C

D

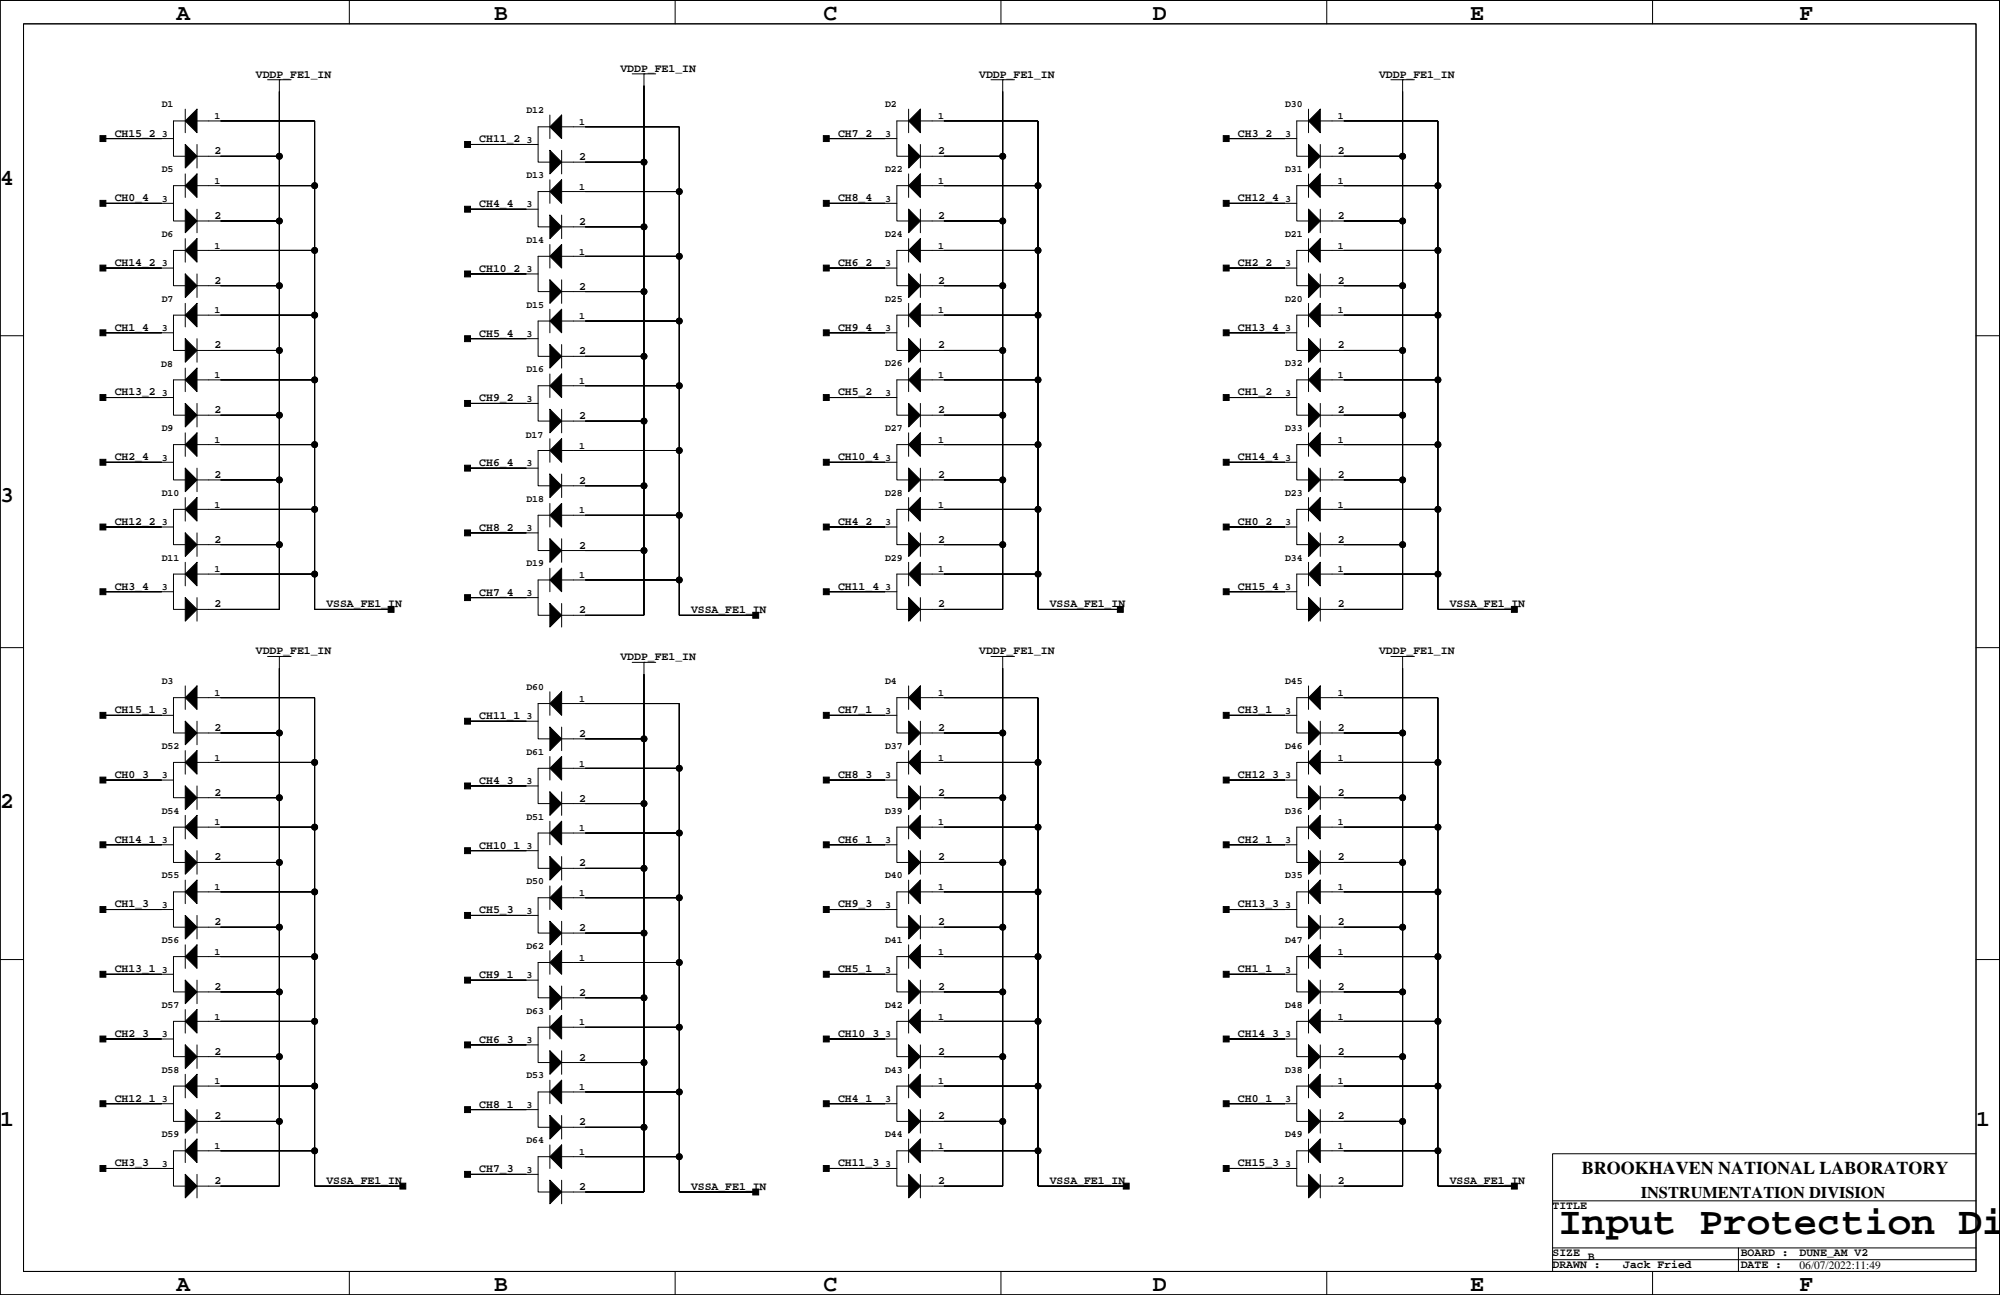
[picture p23: page 9]

4

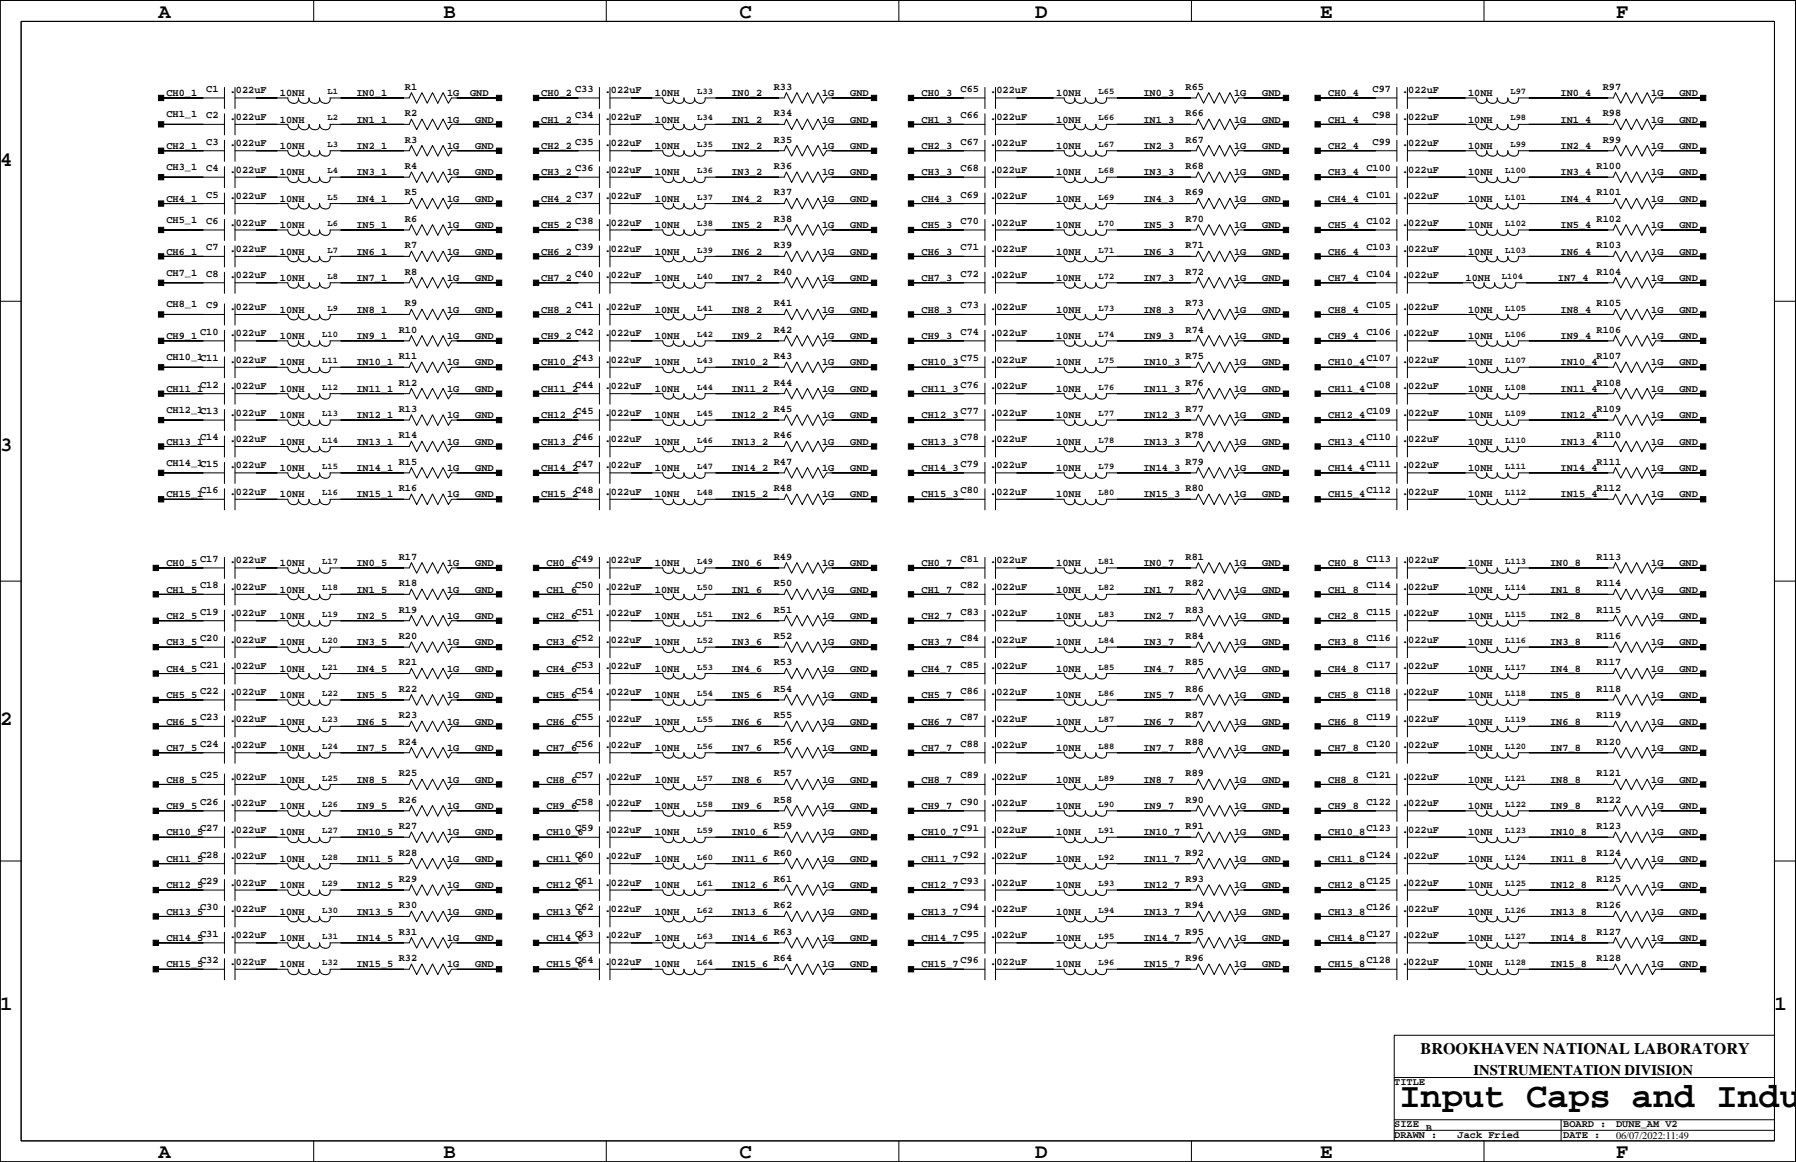
[picture p24: page 10]

BROOKHAVEN NATIONAL LABORATORY
Input Caps and Inductors

4

# ASIC CHAIN 1

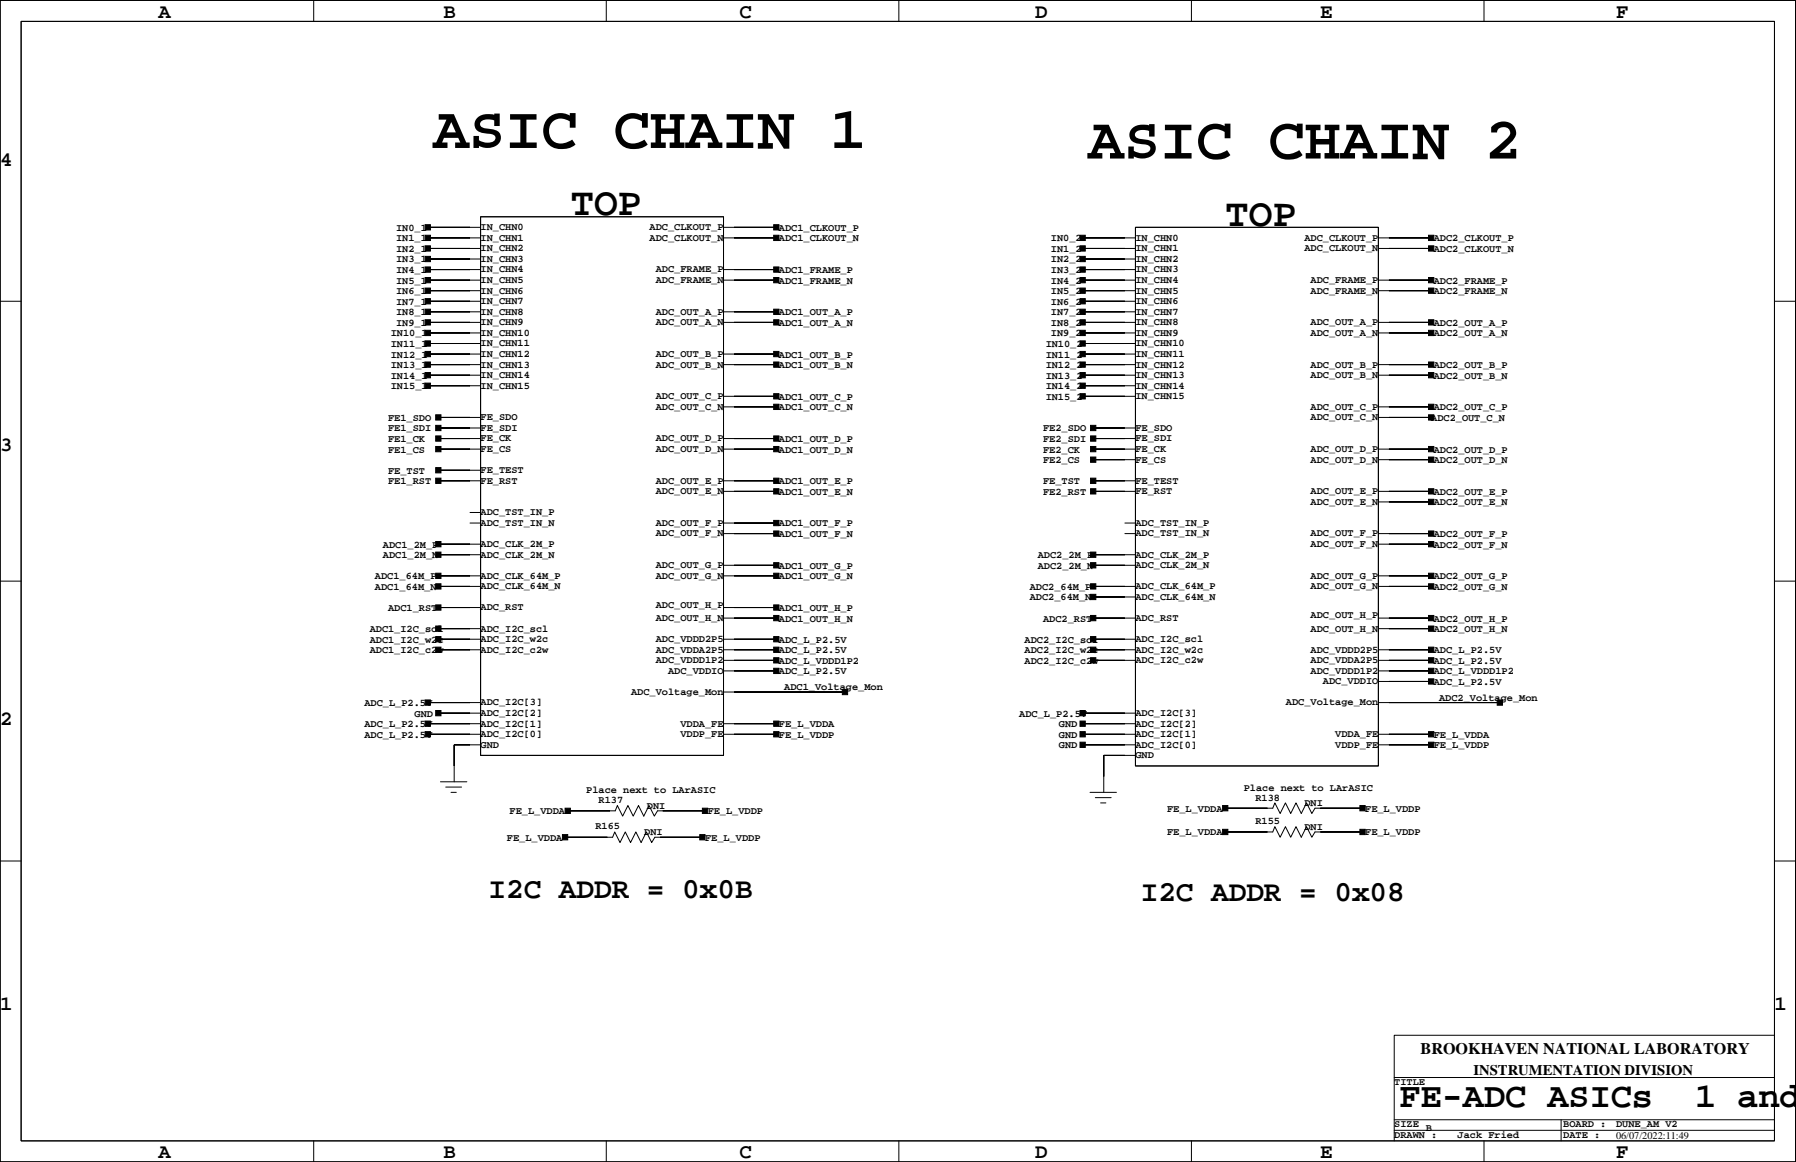
[picture p25: page 11]
DUNE_AM V2; FE1_SDO FE1_SDI FE1_CK FE1_CS; FE1_RST; FE_TST; ADC1_RST; ADC1_I2C_scl ADC1_I2C_w2c ADC1_I2C_c2w; ADC1_2M_P ADC1_2M_N; ADC1_64M_P ADC1_64M_N; ADC1_CLKOUT_P ADC1_CLKOUT_N; ADC1_FRAME_P ADC1_FRAME_N; ADC1_OUT_A_P ADC1_OUT_A_N; ADC1_OUT_B_P ADC1_OUT_B_N; ADC1_OUT_C_P ADC1_OUT_C_N; ADC1_OUT_D_P ADC1_OUT_D_N; ADC1_OUT_E_P ADC1_OUT_E_N; ADC1_OUT_F_P ADC1_OUT_F_N; ADC1_OUT_G_P ADC1_OUT_G_N; ADC1_OUT_H_P ADC1_OUT_H_N; ADC_L_VDDD1P2; FE_L_VDDA FE_L_VDDP; ADC2_CLKOUT_P ADC2_CLKOUT_N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

Place next to LArASIC

DNI R138

BROOKHAVEN NATIONAL LABORATORY
FE-ADC ASICs 1 and 2

4

# ASIC CHAIN 3

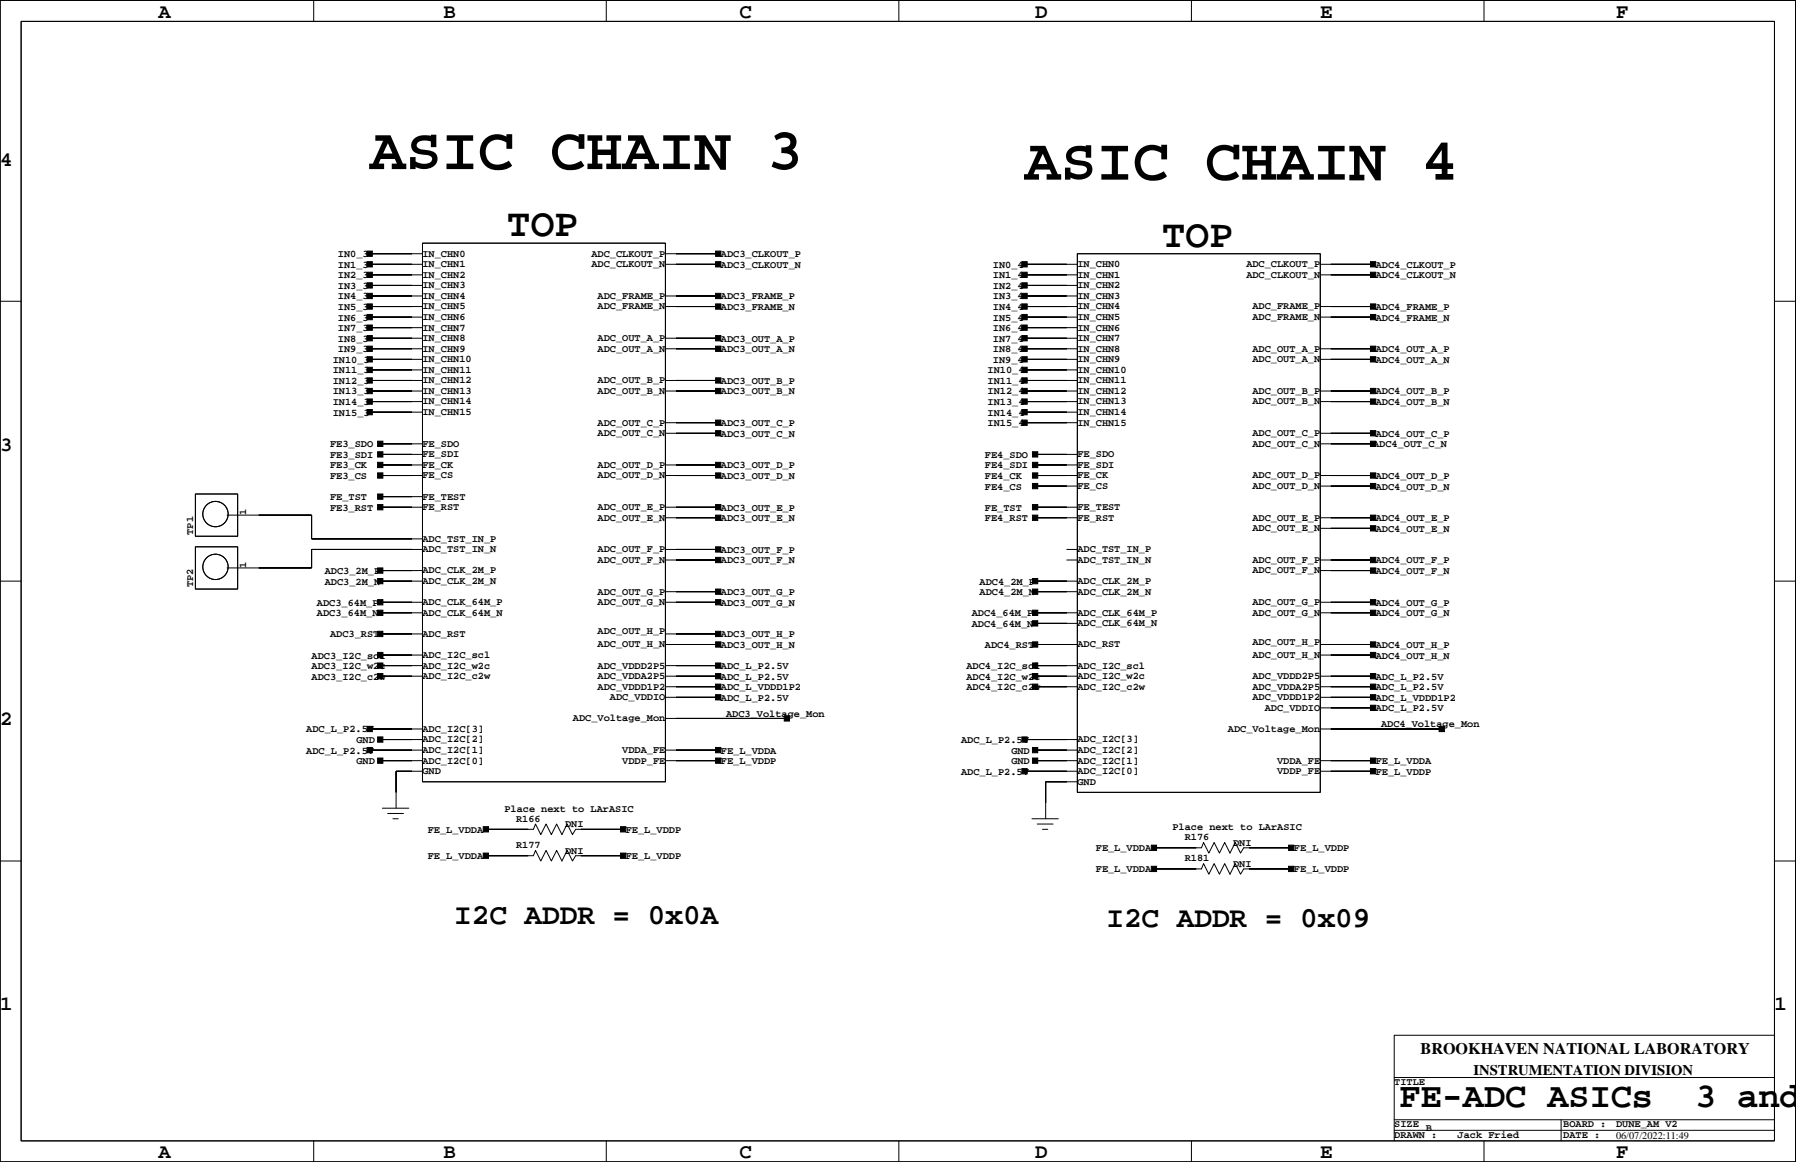
[picture p26: page 12]
DUNE_AM V2; FE3_SDO FE3_SDI FE3_CK FE3_CS; FE3_RST; FE_TST; ADC3_RST; ADC3_I2C_scl ADC3_I2C_w2c ADC3_I2C_c2w; ADC3_2M_P ADC3_2M_N; ADC3_64M_P ADC3_64M_N; ADC3_CLKOUT_P ADC3_CLKOUT_N; ADC3_FRAME_P ADC3_FRAME_N; ADC3_OUT_A_P ADC3_OUT_A_N; ADC3_OUT_B_P ADC3_OUT_B_N; ADC3_OUT_C_P ADC3_OUT_C_N; ADC3_OUT_D_P ADC3_OUT_D_N; ADC3_OUT_E_P ADC3_OUT_E_N; ADC3_OUT_F_P ADC3_OUT_F_N; ADC3_OUT_G_P ADC3_OUT_G_N; ADC3_OUT_H_P ADC3_OUT_H_N; FE_L_VDDA FE_L_VDDP; ADC4_CLKOUT_P ADC4_CLKOUT_N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

Place next to LArASIC
DNI R166

BROOKHAVEN NATIONAL LABORATORY
FE-ADC ASICs 3 and 4

4

# ASIC CHAIN 5

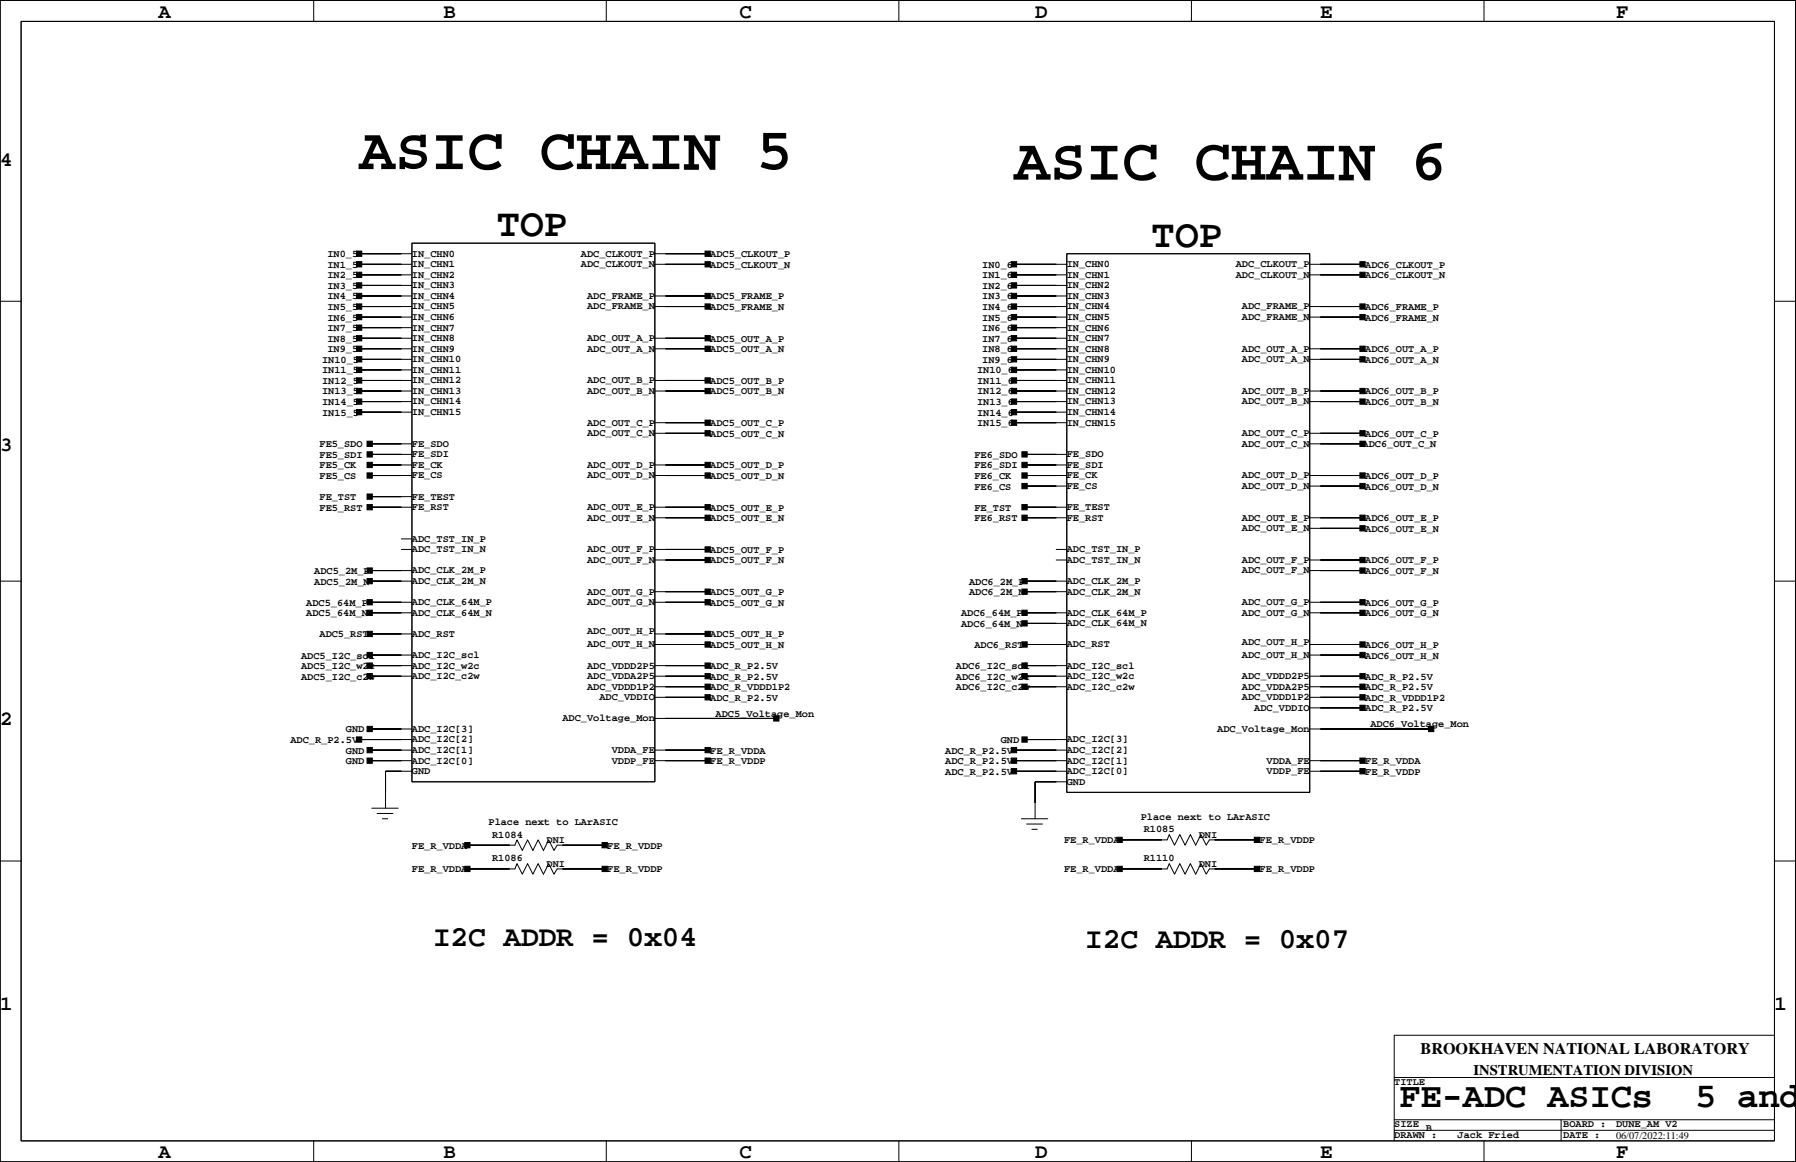
[picture p27: page 13]
DUNE_AM V2; FE5_SDO FE5_SDI FE5_CK FE5_CS; FE5_RST; FE_TST; ADC5_RST; ADC5_I2C_scl ADC5_I2C_w2c ADC5_I2C_c2w; ADC5_2M_P ADC5_2M_N; ADC5_64M_P ADC5_64M_N; ADC5_CLKOUT_P ADC5_CLKOUT_N; ADC5_FRAME_P ADC5_FRAME_N; ADC5_OUT_A_P ADC5_OUT_A_N; ADC5_OUT_B_P ADC5_OUT_B_N; ADC5_OUT_C_P ADC5_OUT_C_N; ADC5_OUT_D_P ADC5_OUT_D_N; ADC5_OUT_E_P ADC5_OUT_E_N; ADC5_OUT_F_P ADC5_OUT_F_N; ADC5_OUT_G_P ADC5_OUT_G_N; ADC5_OUT_H_P ADC5_OUT_H_N; ADC_R_VDDD1P2; FE_R_VDDA FE_R_VDDP; ADC6_CLKOUT_P ADC6_CLKOUT_N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

Place next to LArASIC

DNI R1084

BROOKHAVEN NATIONAL LABORATORY
FE-ADC ASICs 5 and 6

4

# ASIC CHAIN 7

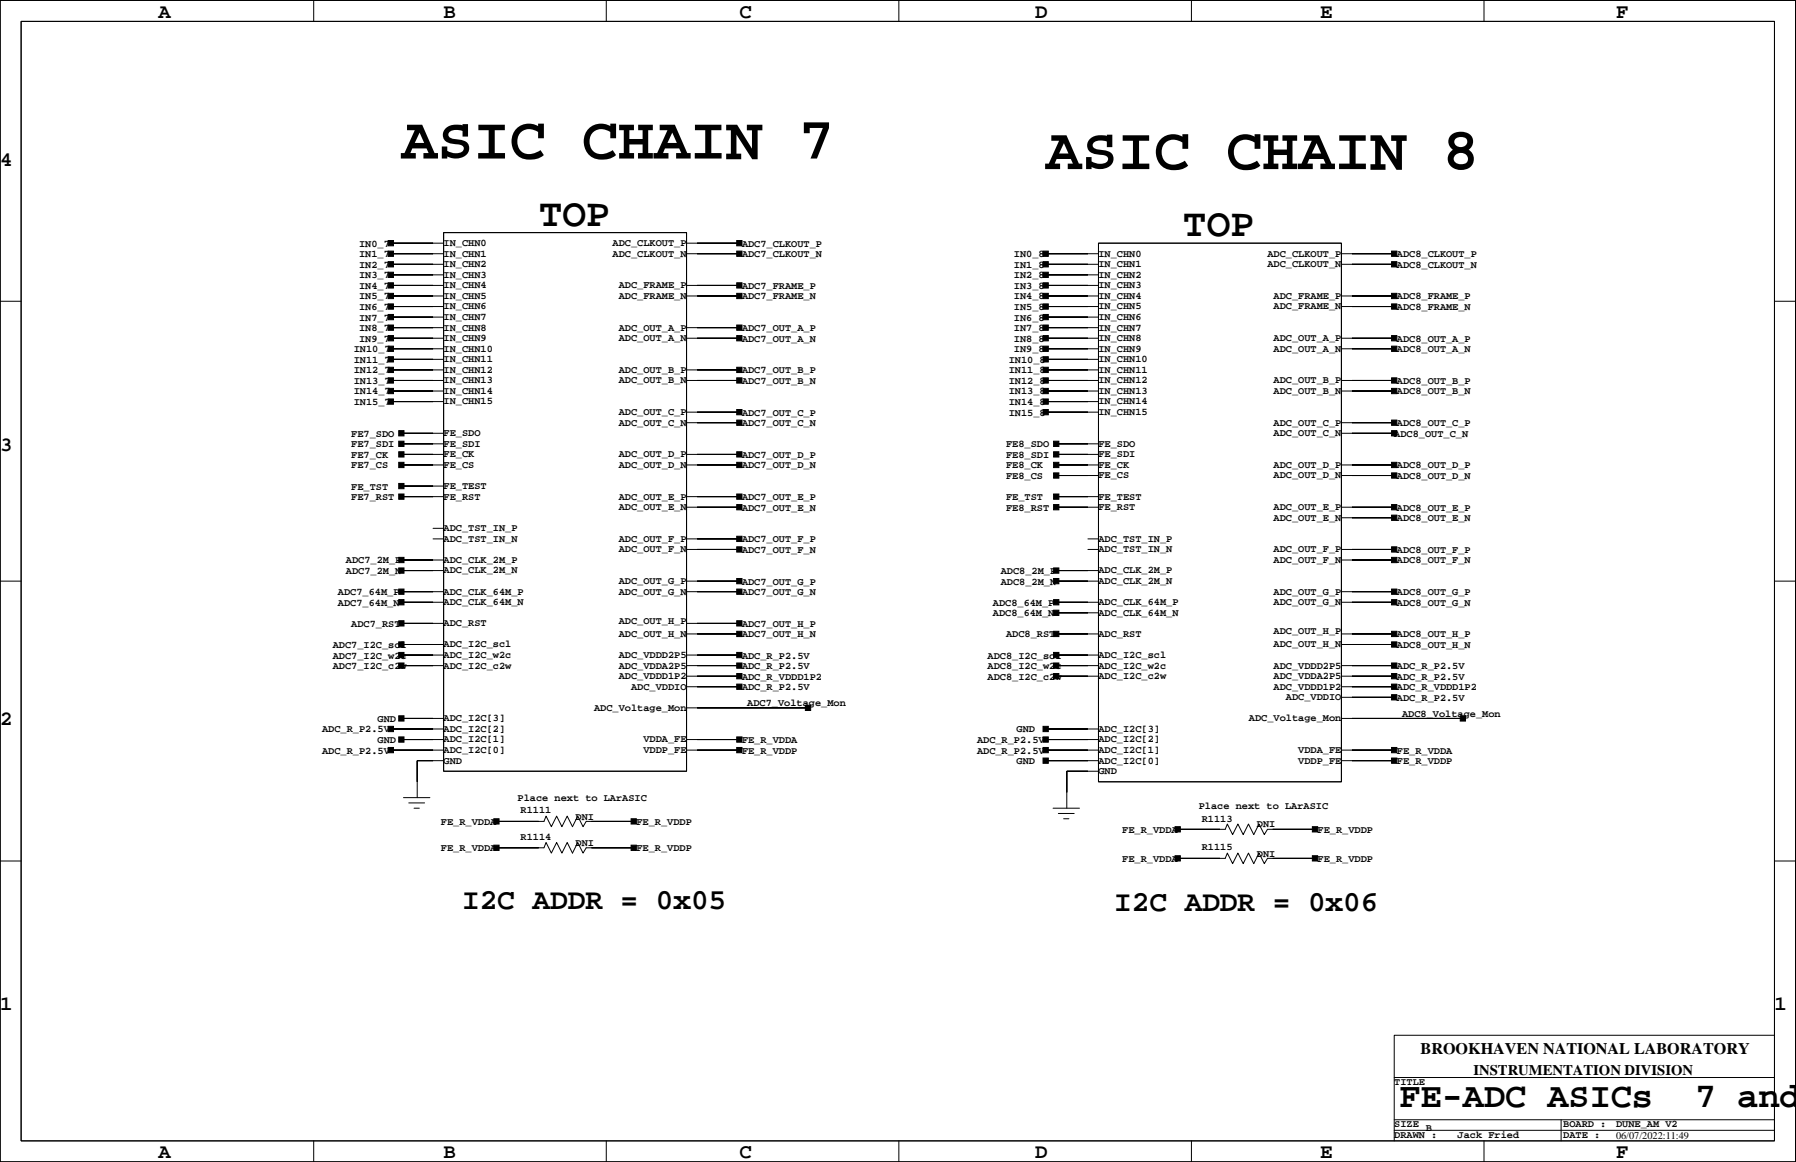
[picture p28: page 14]
DUNE_AM V2; FE7_SDO FE7_SDI FE7_CK FE7_CS; FE7_RST; FE_TST; ADC7_RST; ADC7_I2C_scl ADC7_I2C_w2c ADC7_I2C_c2w; ADC7_2M_P ADC7_2M_N; ADC7_64M_P ADC7_64M_N; ADC7_CLKOUT_P ADC7_CLKOUT_N; ADC7_FRAME_P ADC7_FRAME_N; ADC7_OUT_A_P ADC7_OUT_A_N; ADC7_OUT_B_P ADC7_OUT_B_N; ADC7_OUT_C_P ADC7_OUT_C_N; ADC7_OUT_D_P ADC7_OUT_D_N; ADC7_OUT_E_P ADC7_OUT_E_N; ADC7_OUT_F_P ADC7_OUT_F_N; ADC7_OUT_G_P ADC7_OUT_G_N; ADC7_OUT_H_P ADC7_OUT_H_N; FE_R_VDDA FE_R_VDDP; ADC8_CLKOUT_P ADC8_CLKOUT_N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

Place next to LArASIC

BROOKHAVEN NATIONAL LABORATORY
FE-ADC ASICs 7 and 8

C

D

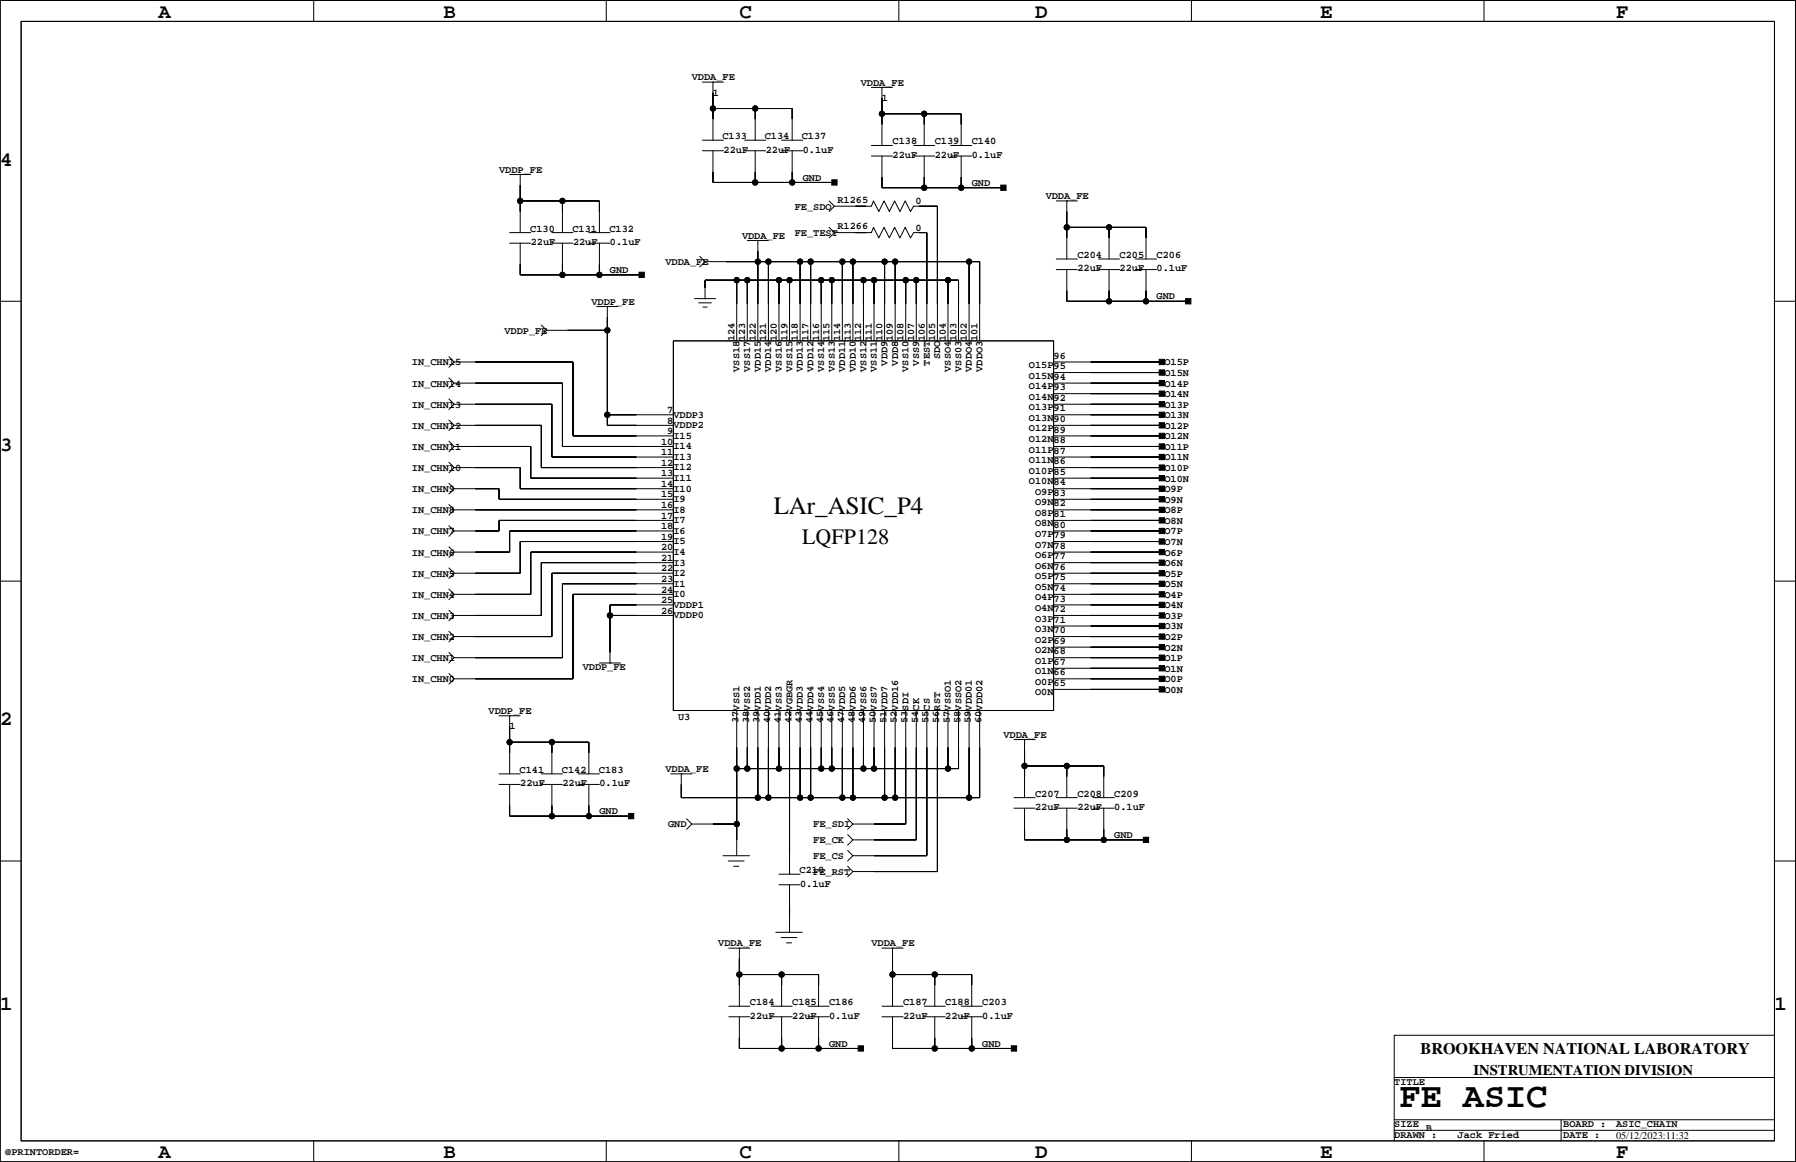
[picture p29: page 15]

4

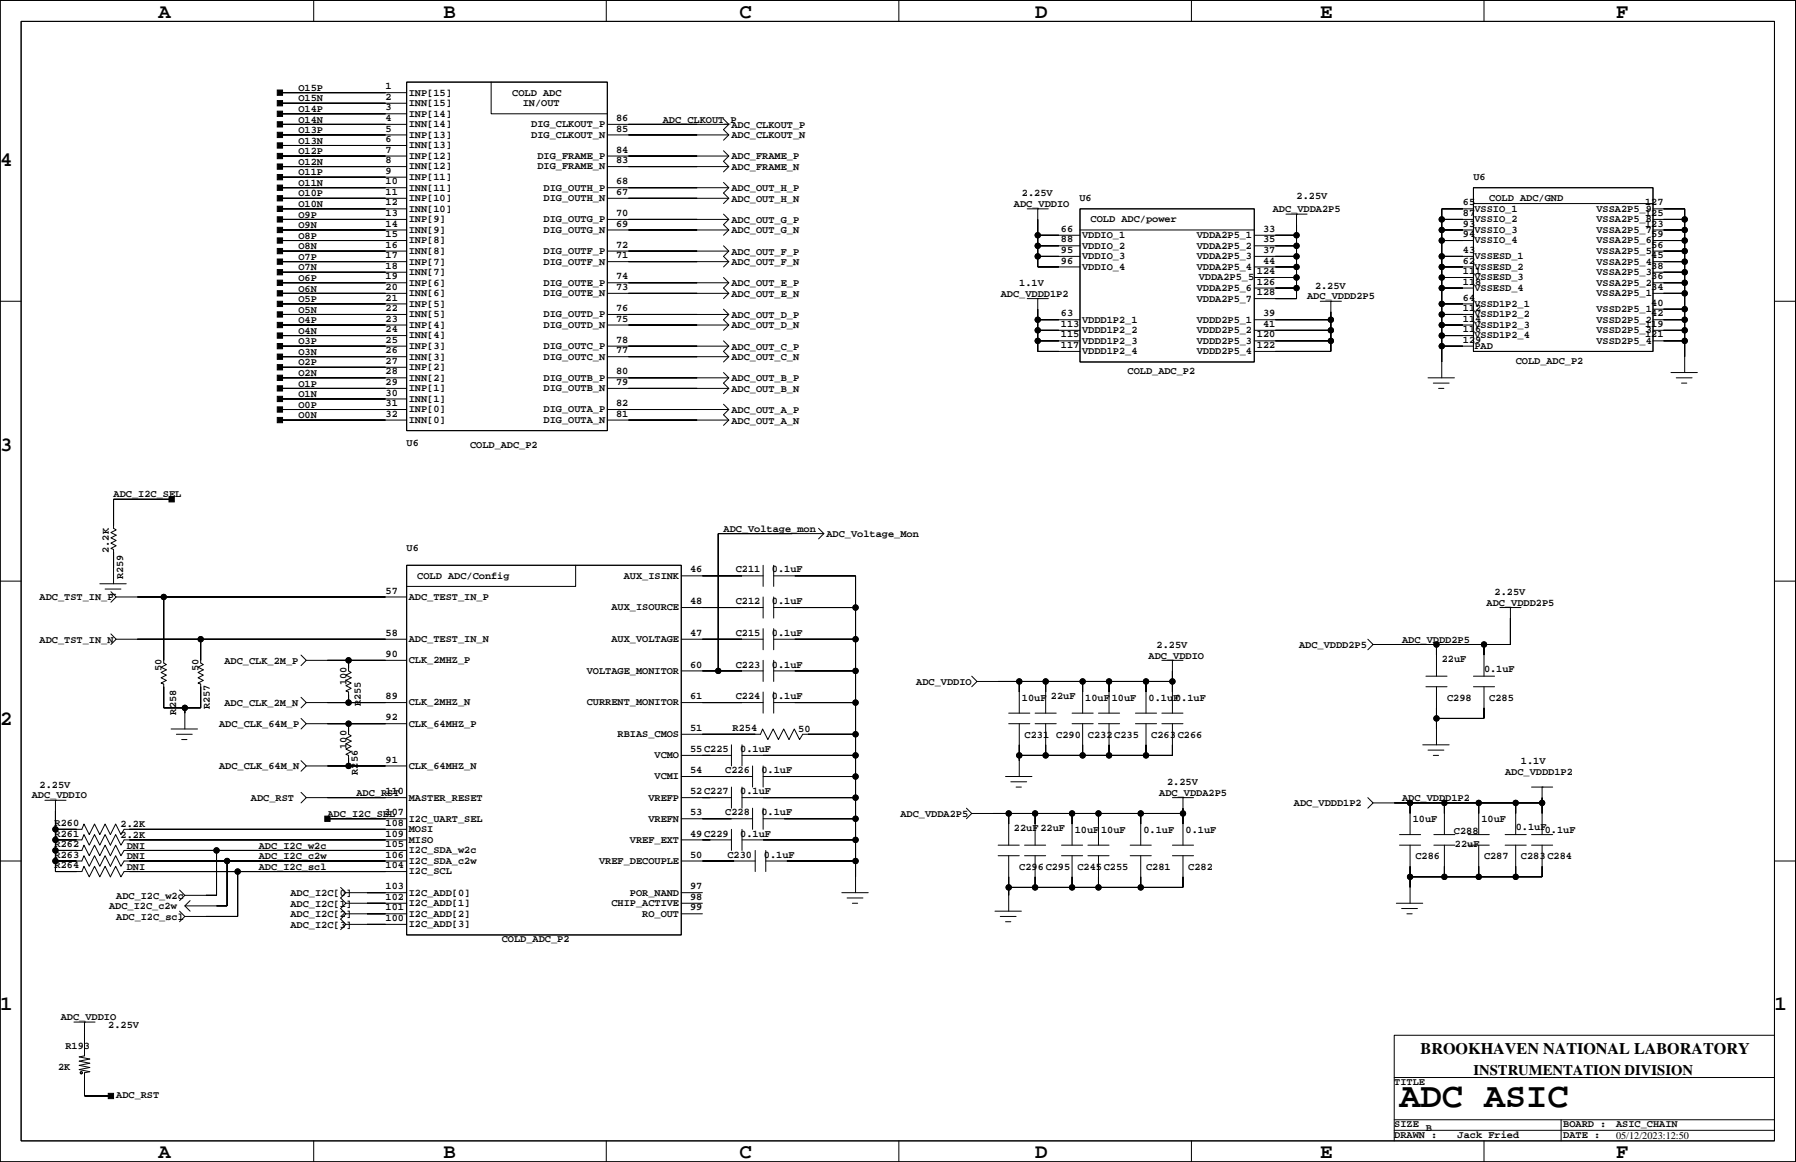
[picture p30: page 16]

C

D

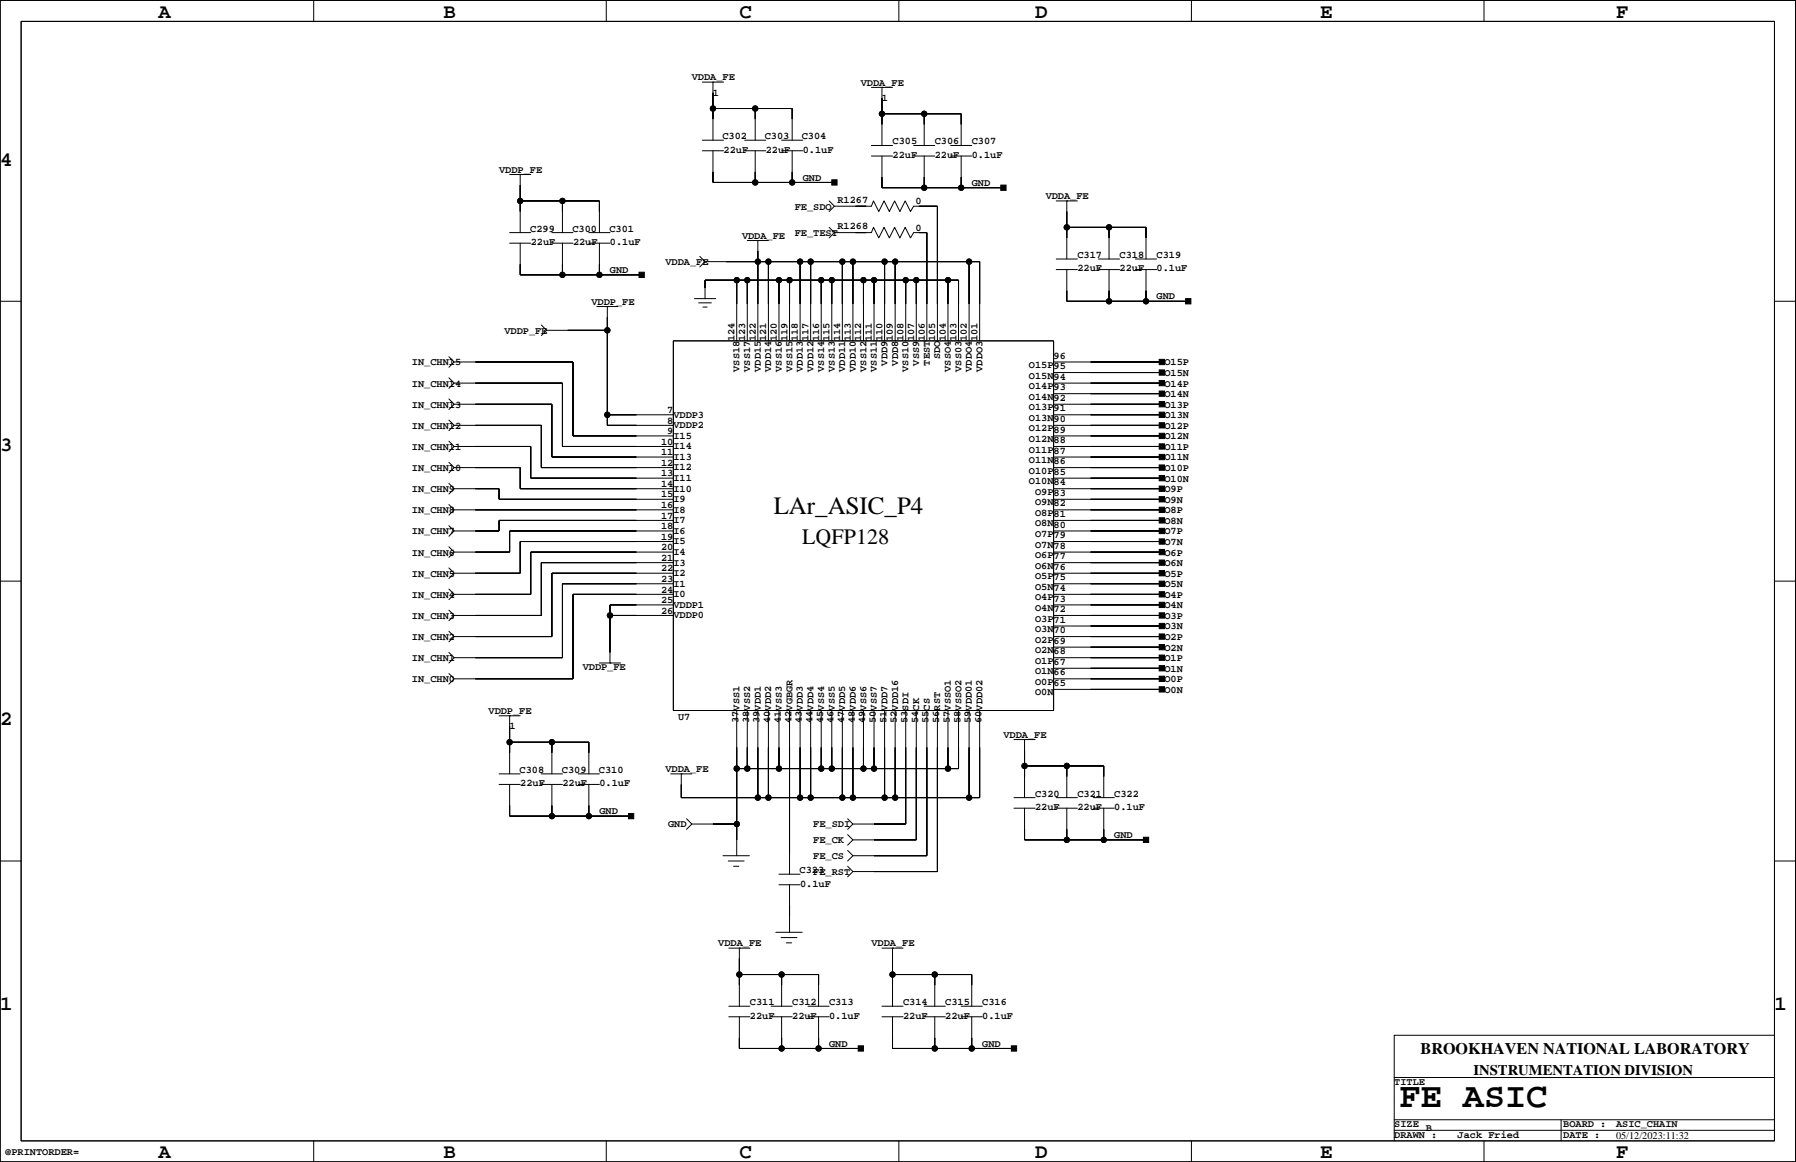
[picture p31: page 17]

4

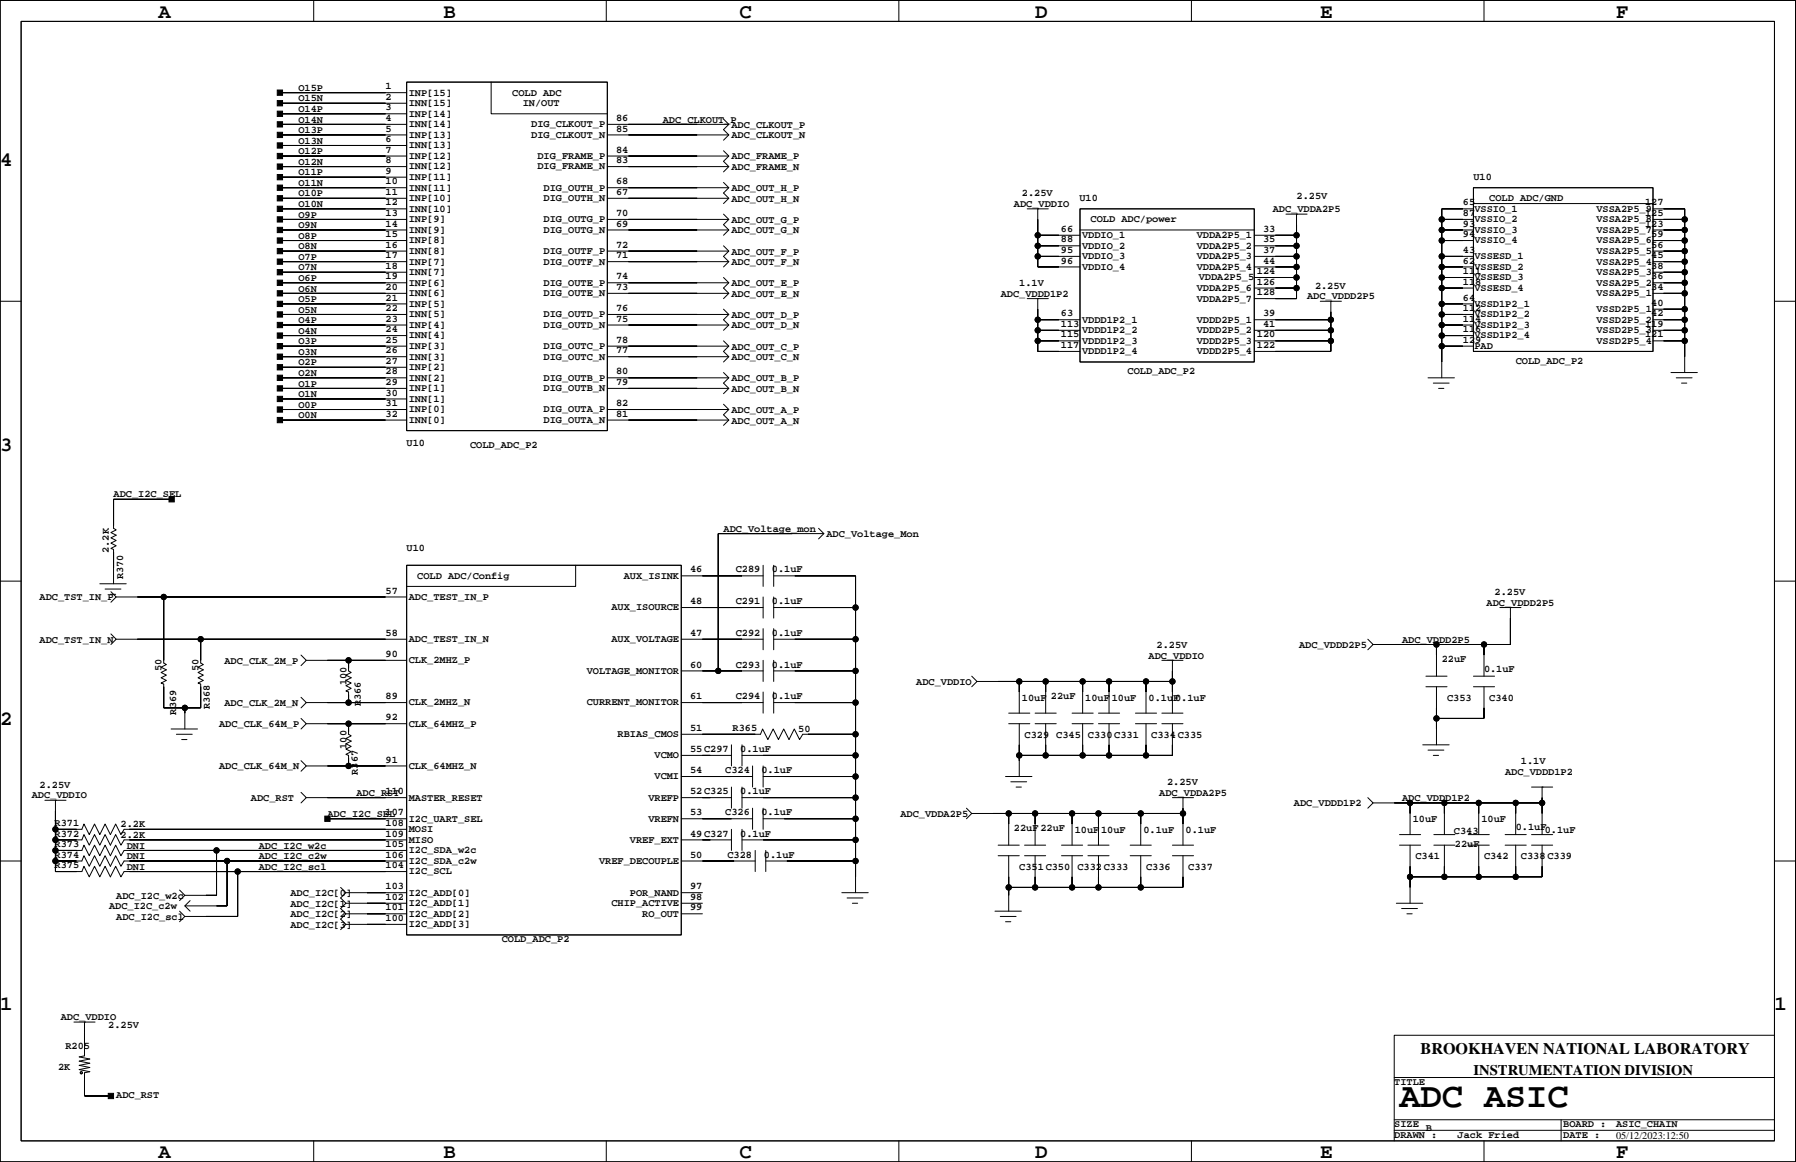
[picture p32: page 18]

C

D

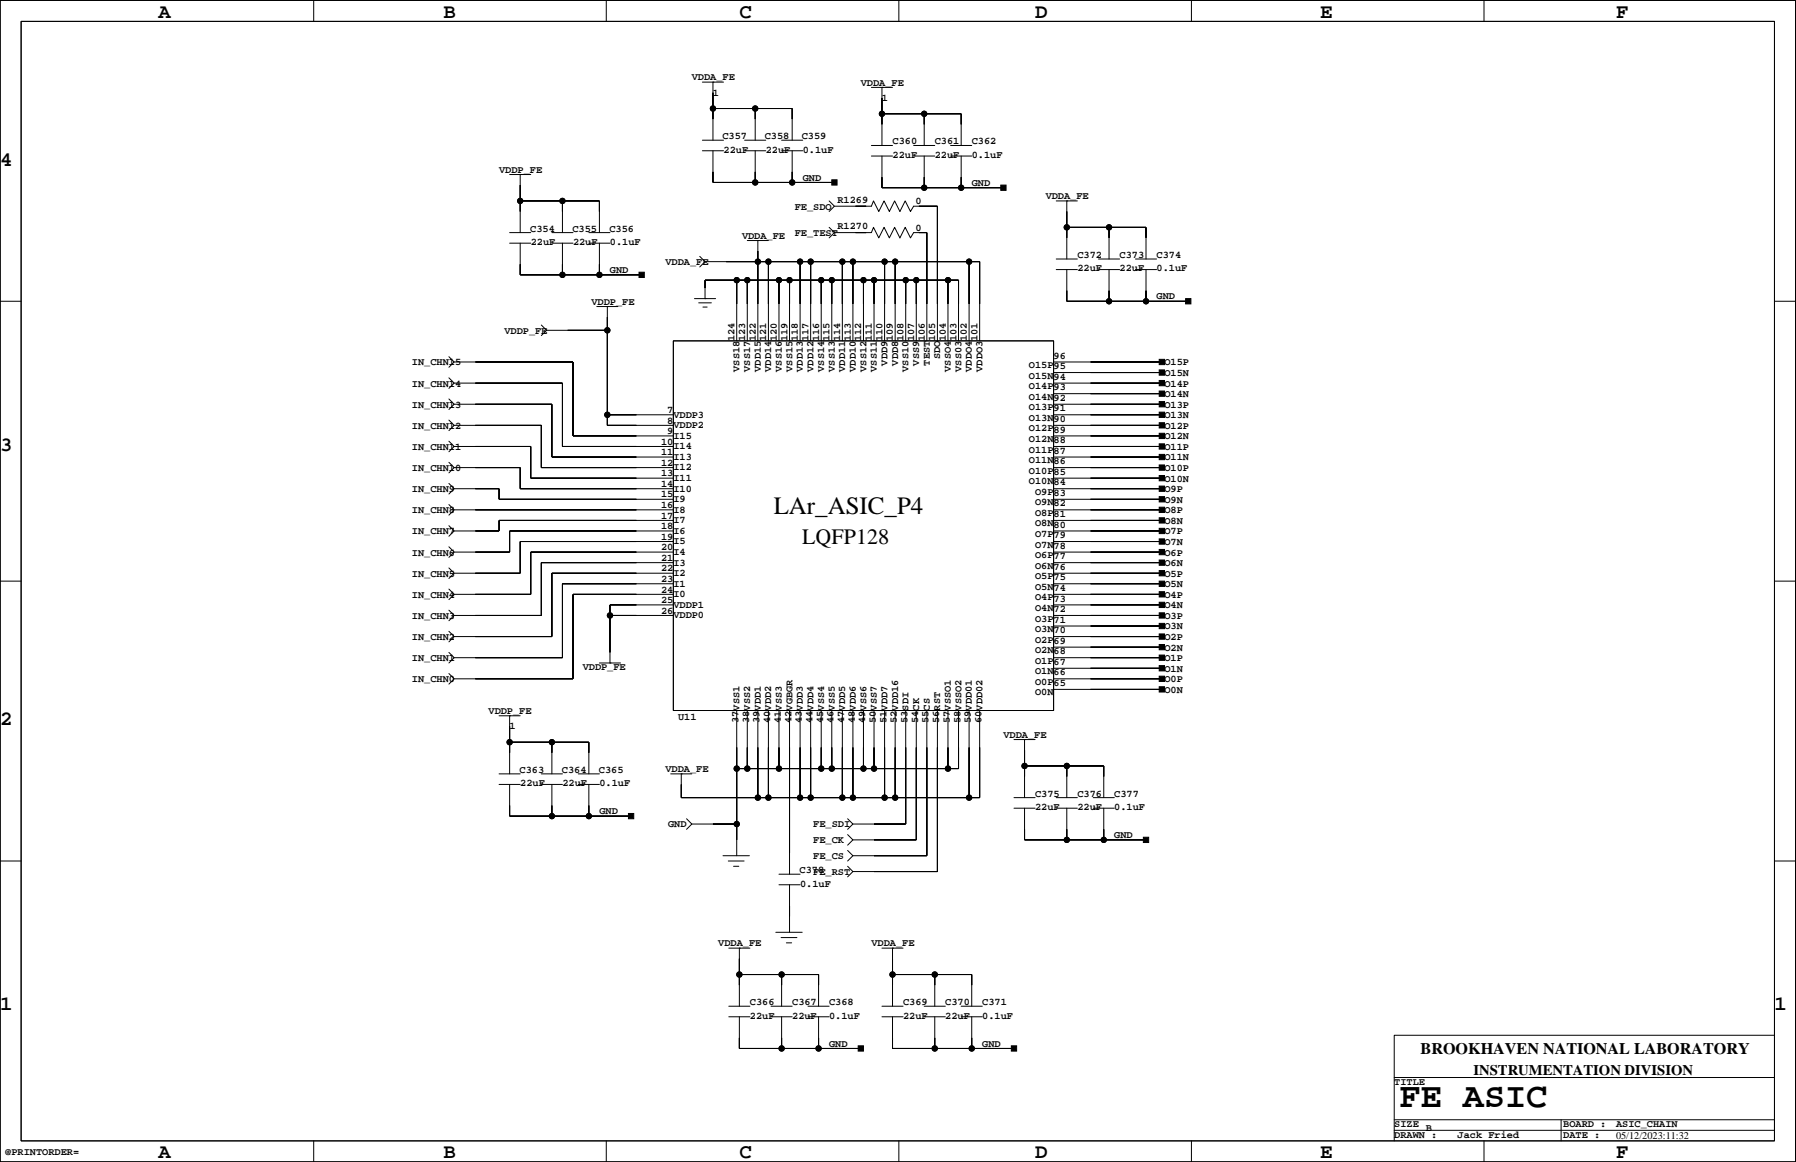
[picture p33: page 19]

4

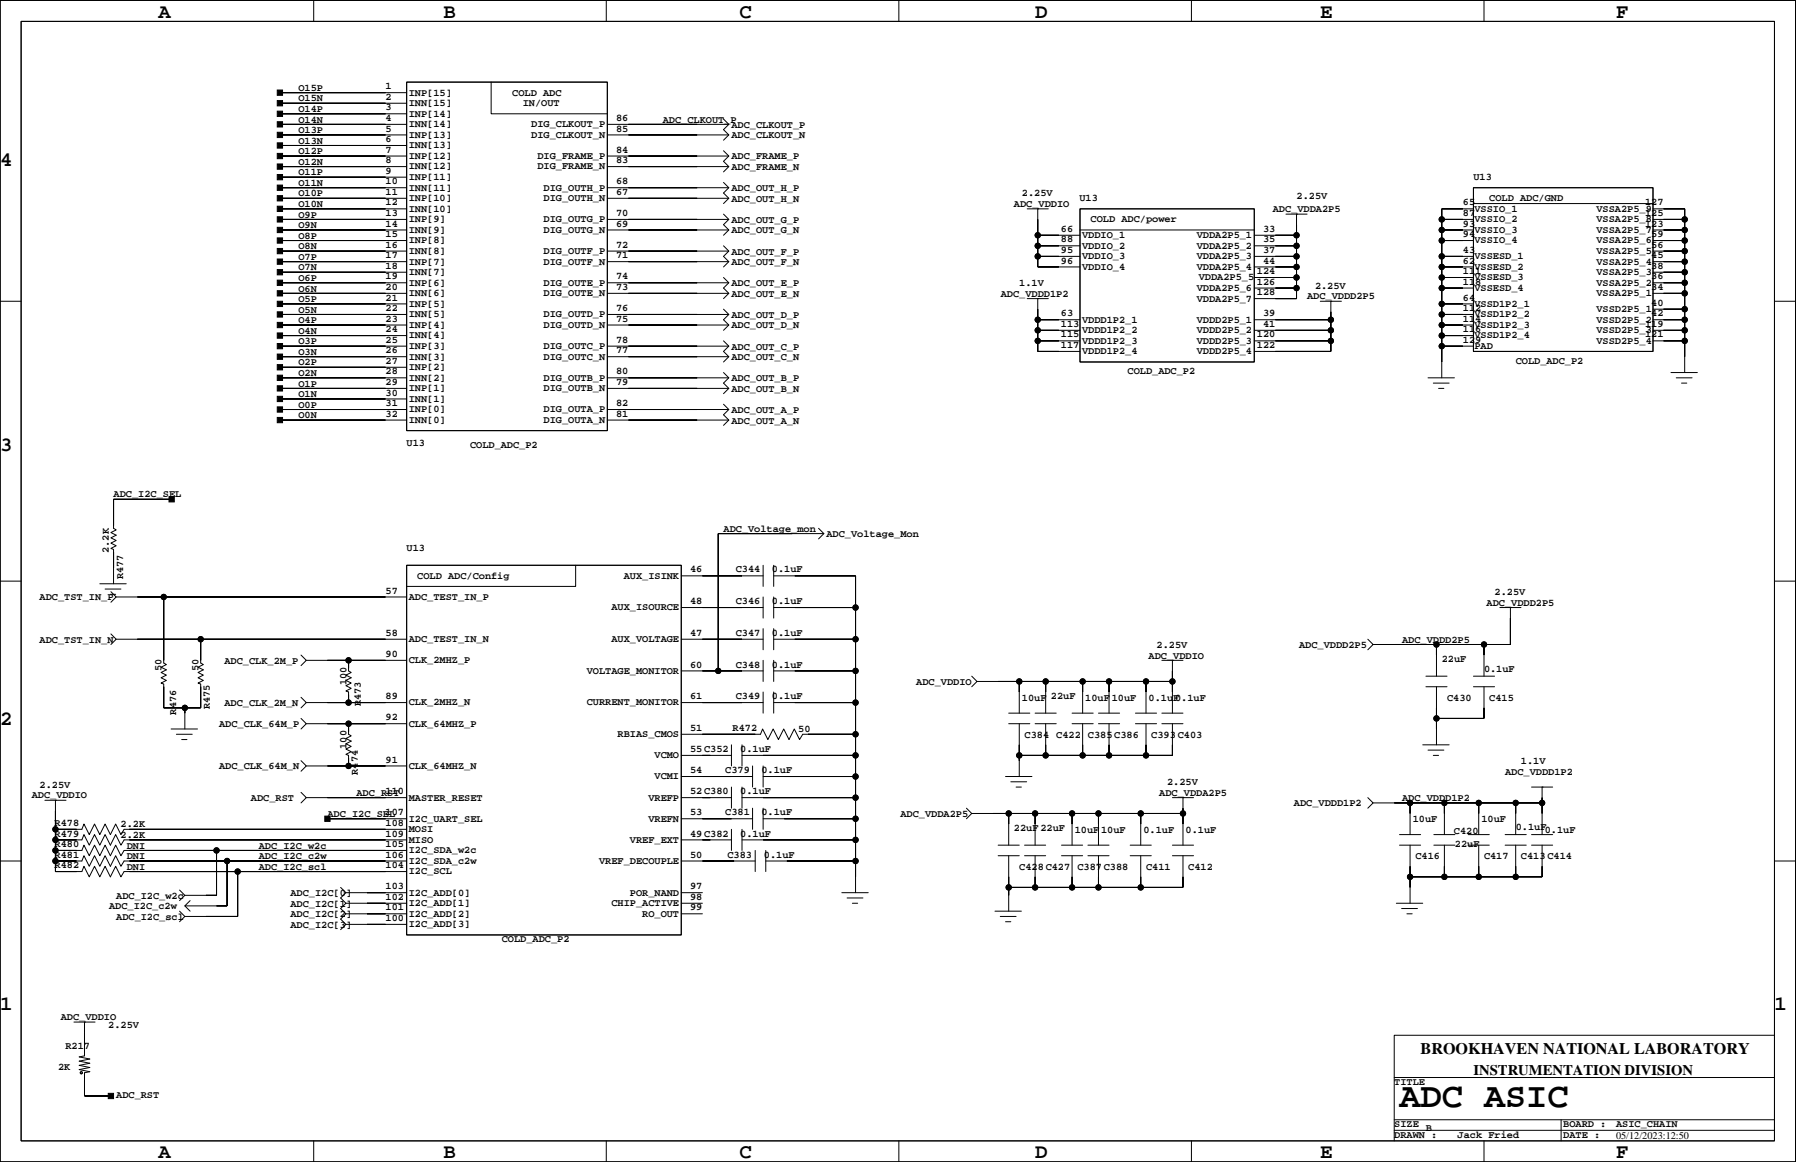
[picture p34: page 20]

C

D

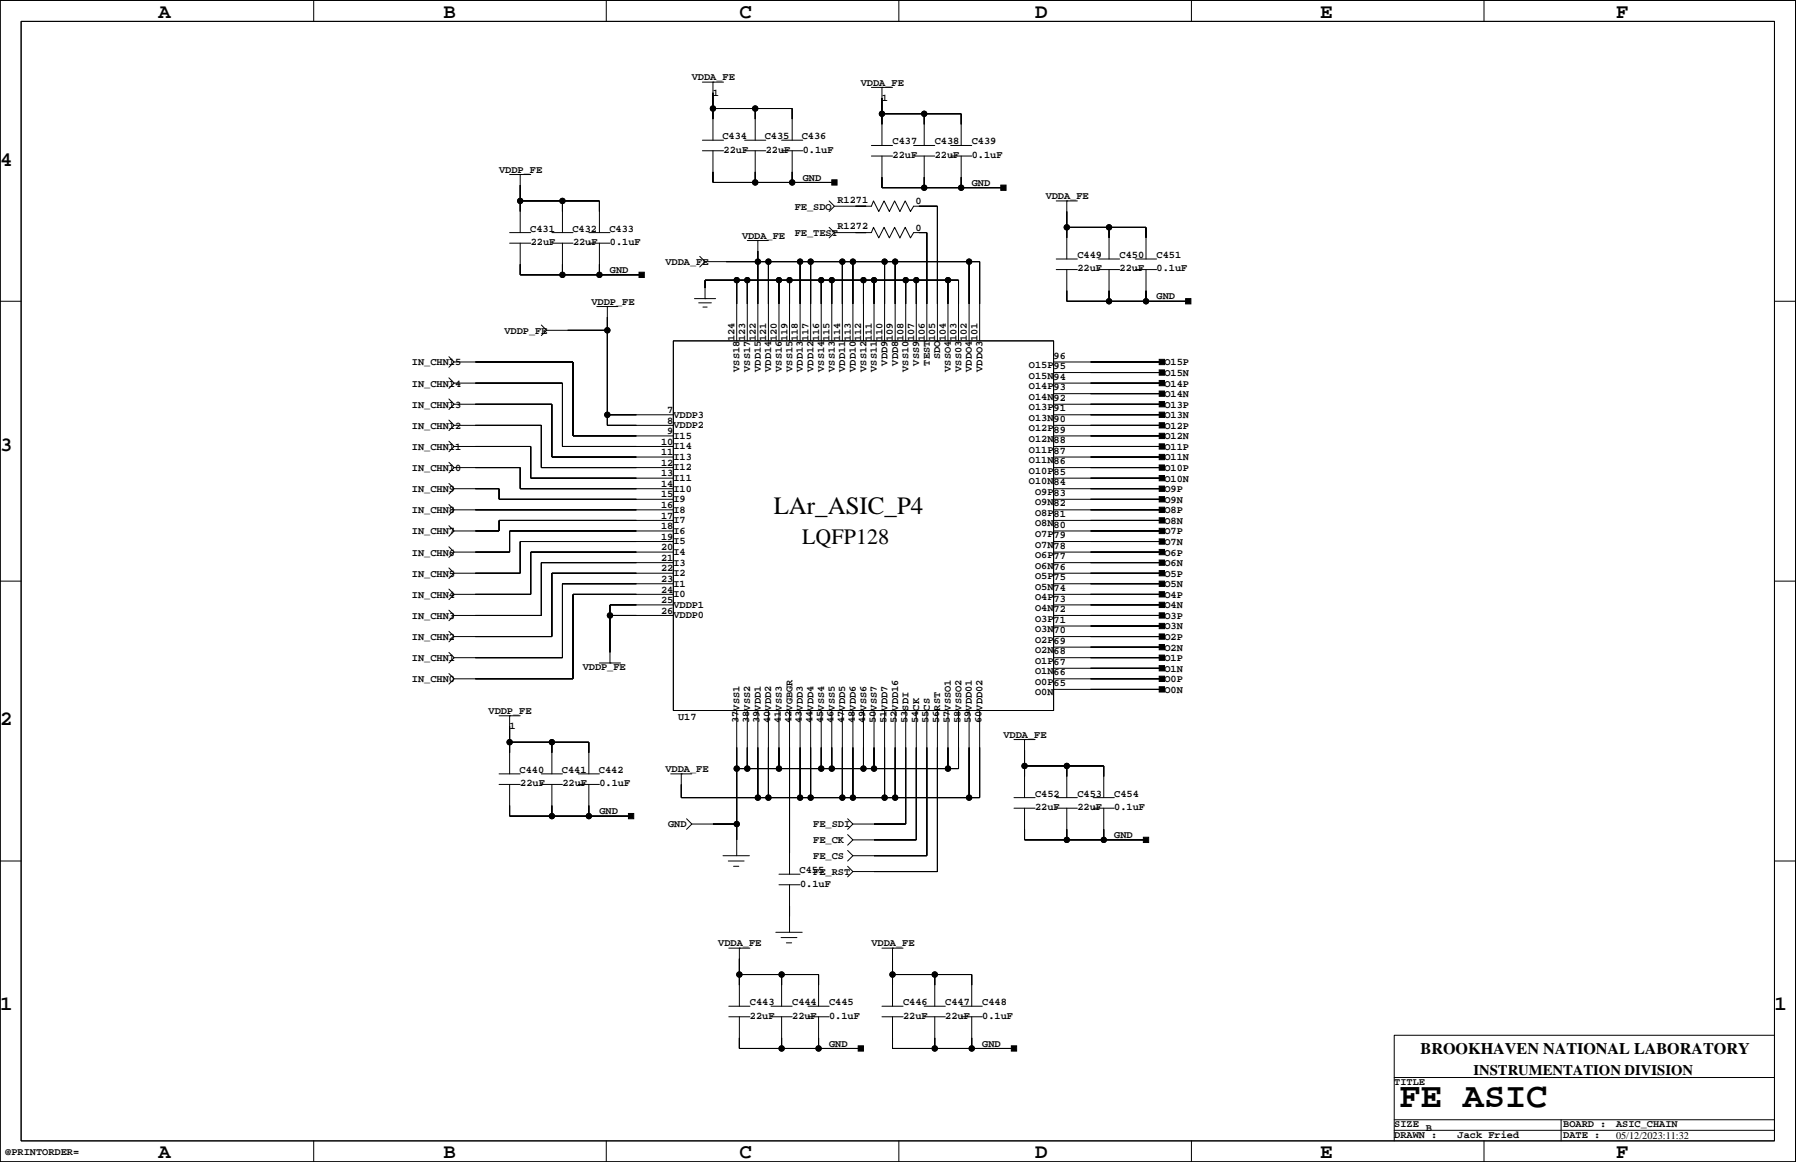
[picture p35: page 21]

4

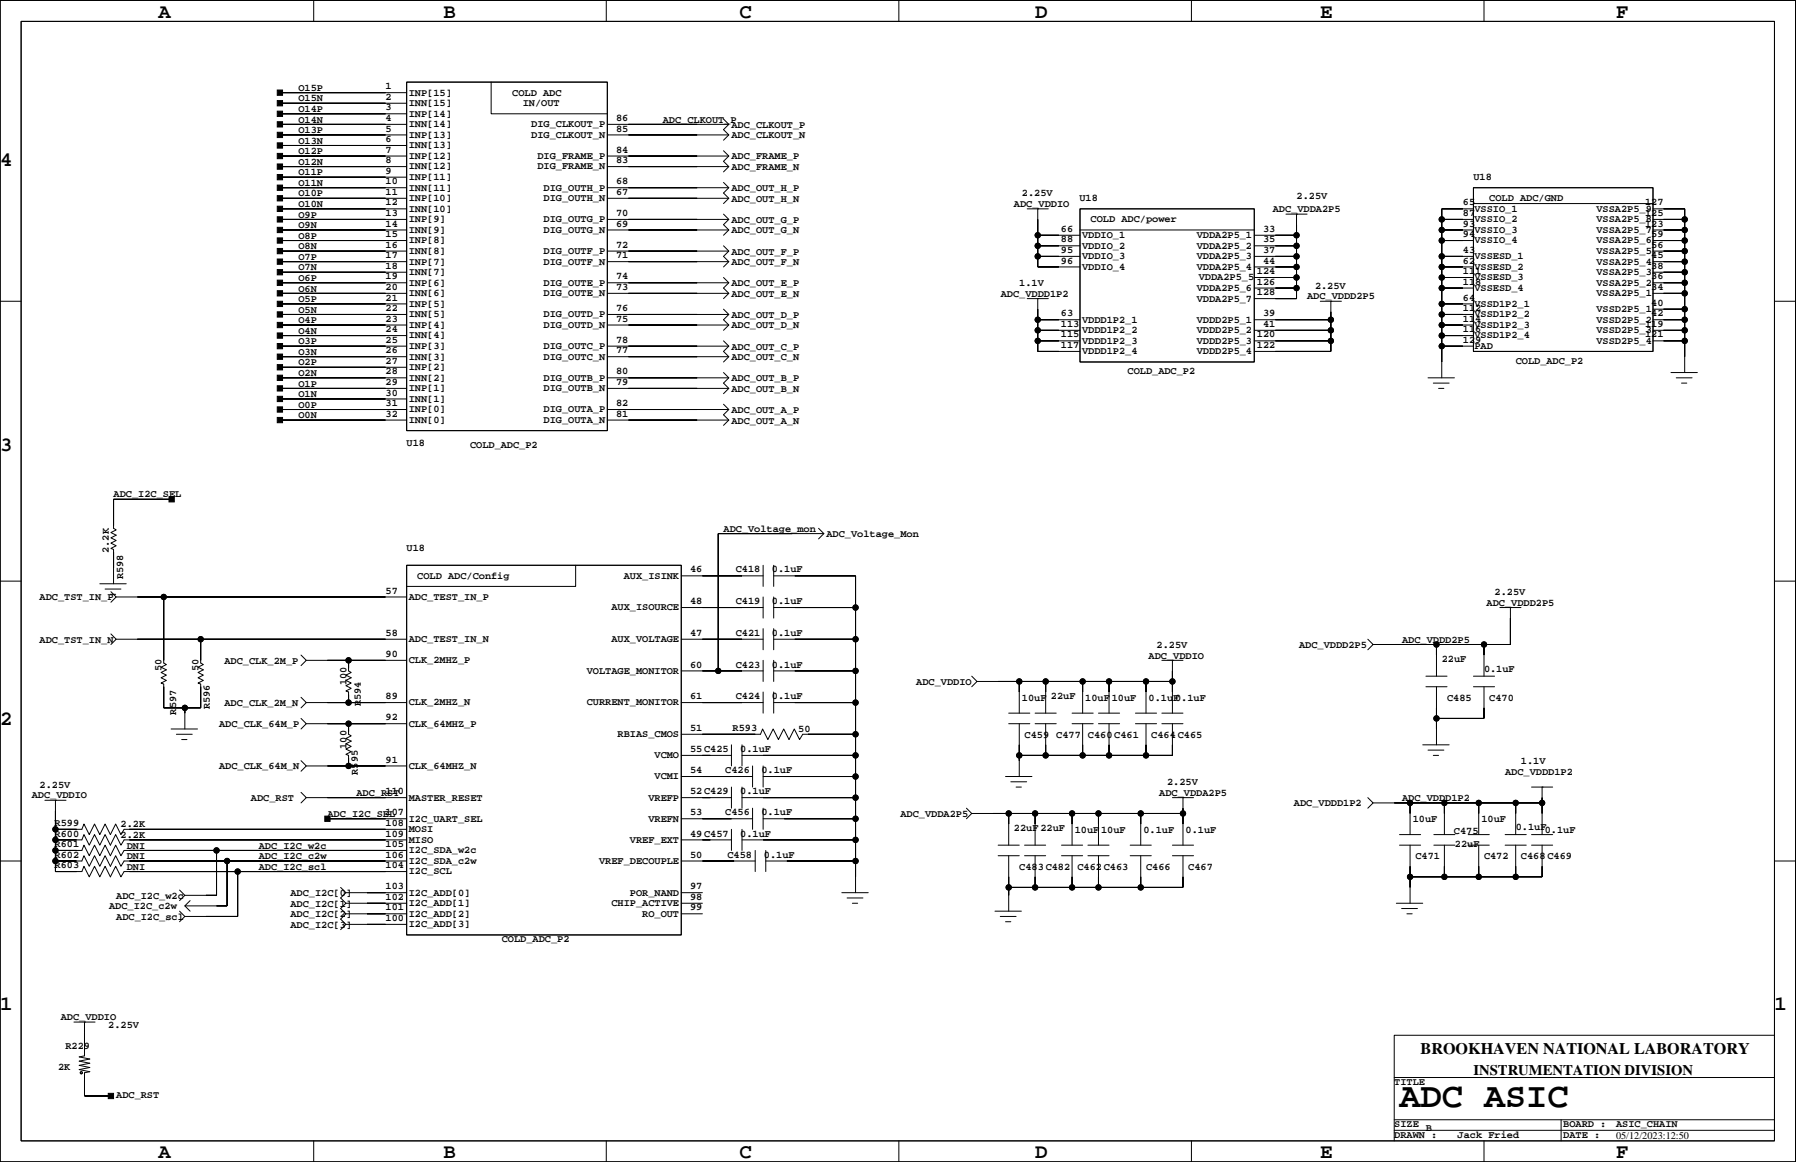
[picture p36: page 22]

C

D

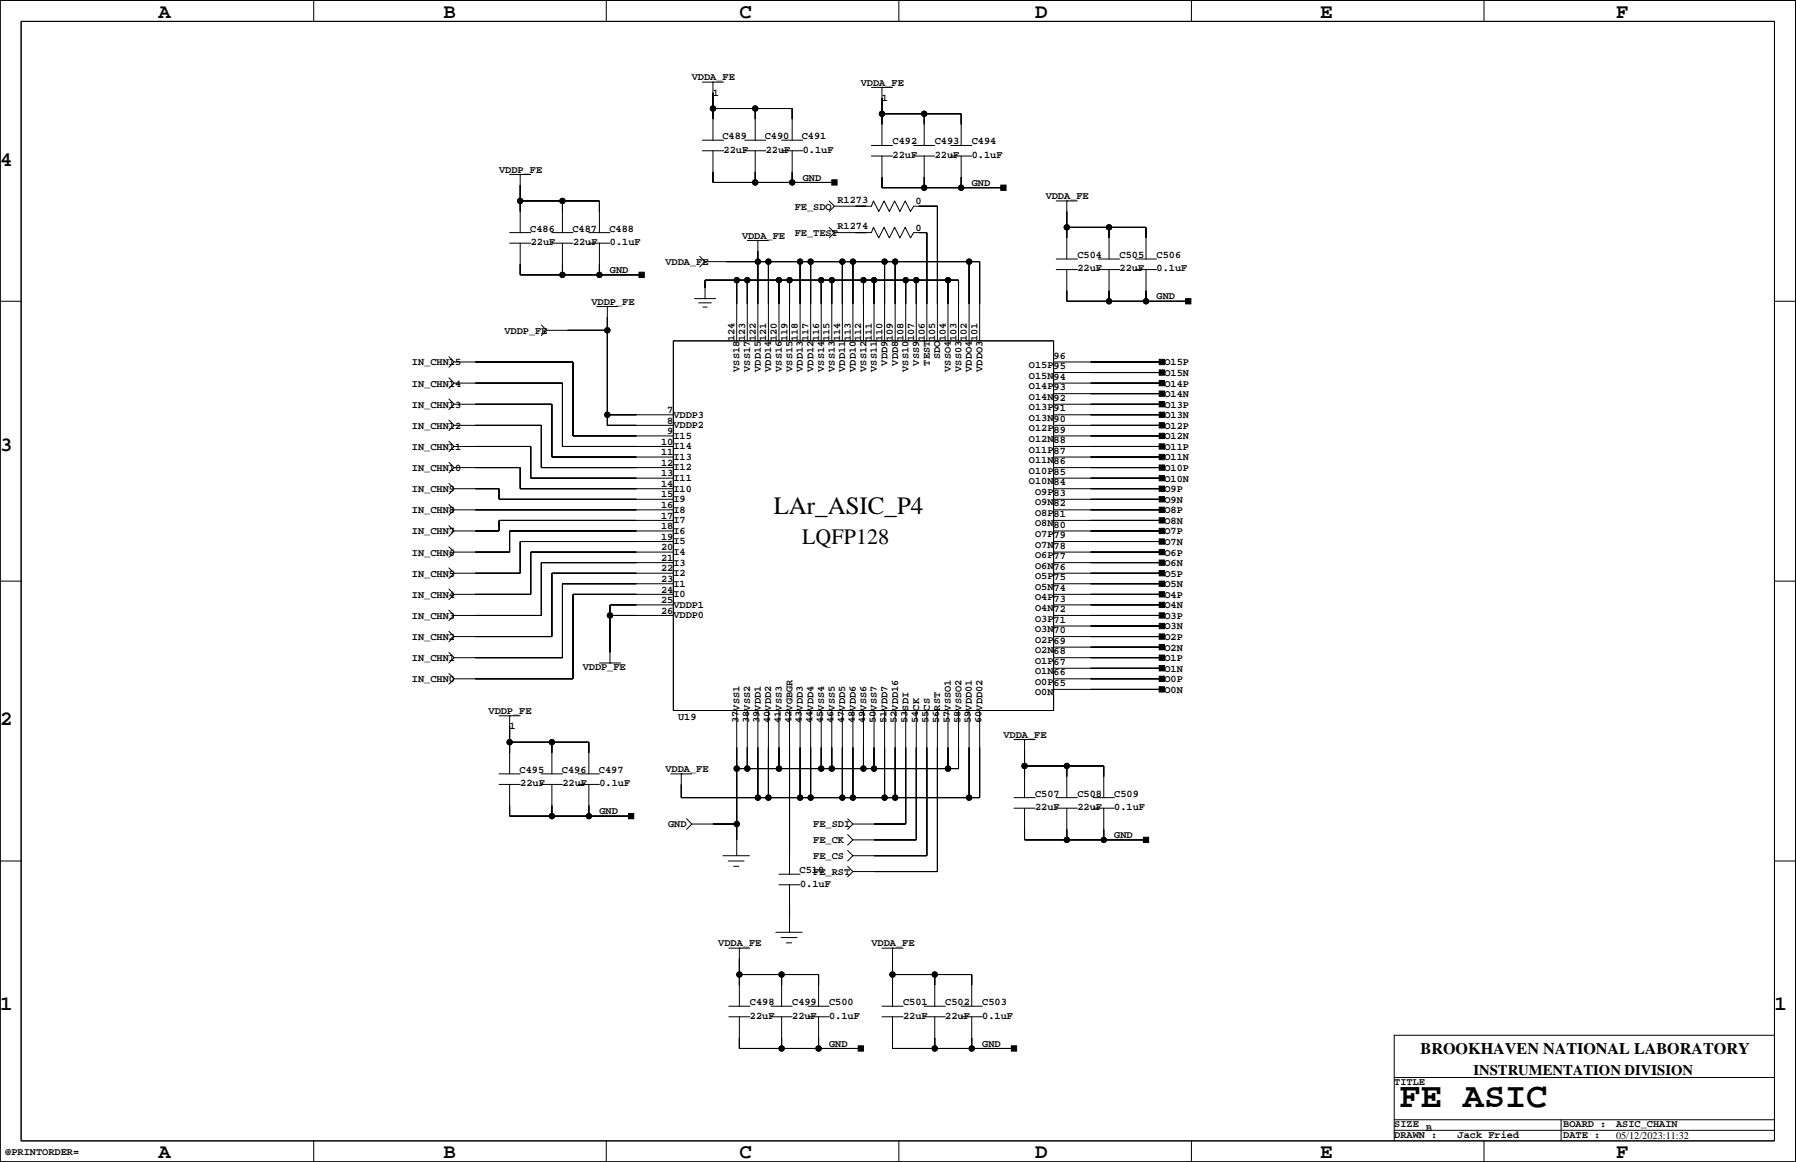
[picture p37: page 23]

4

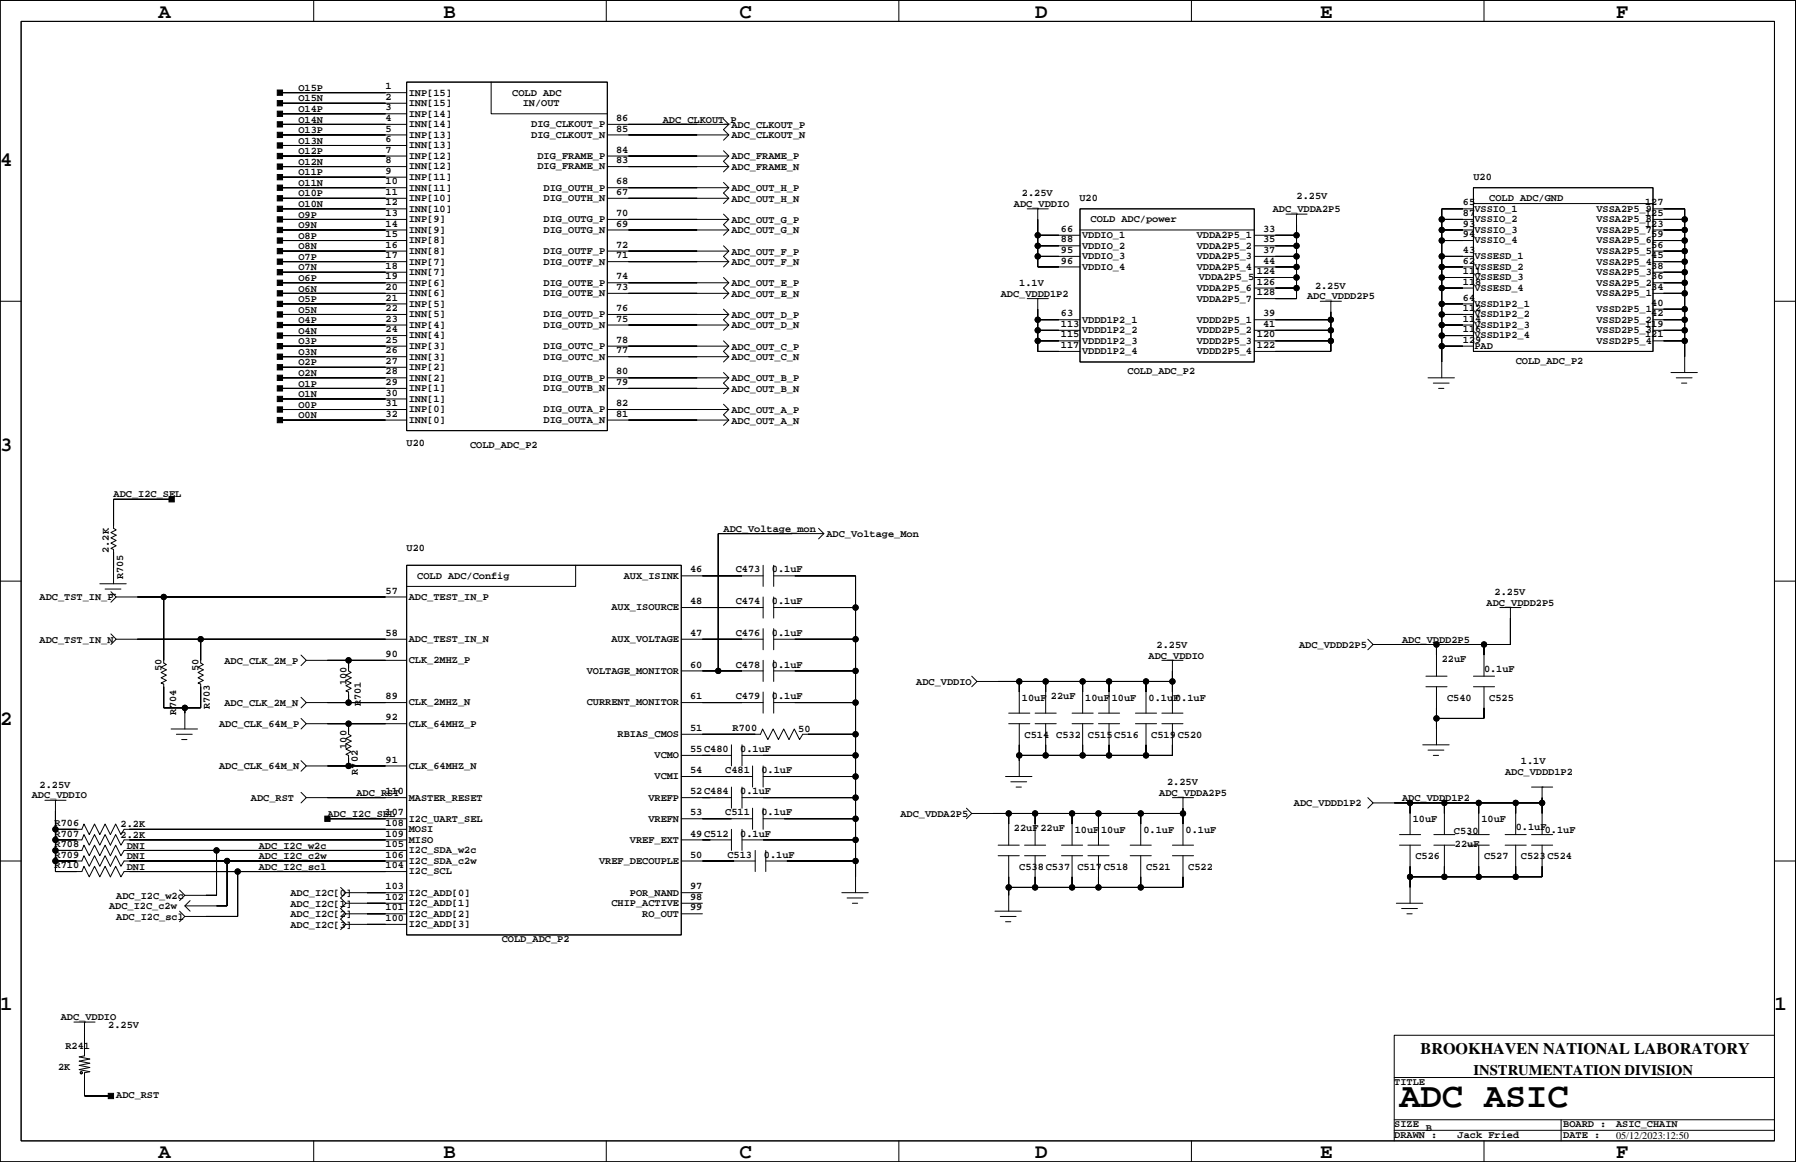
[picture p38: page 24]

C

D

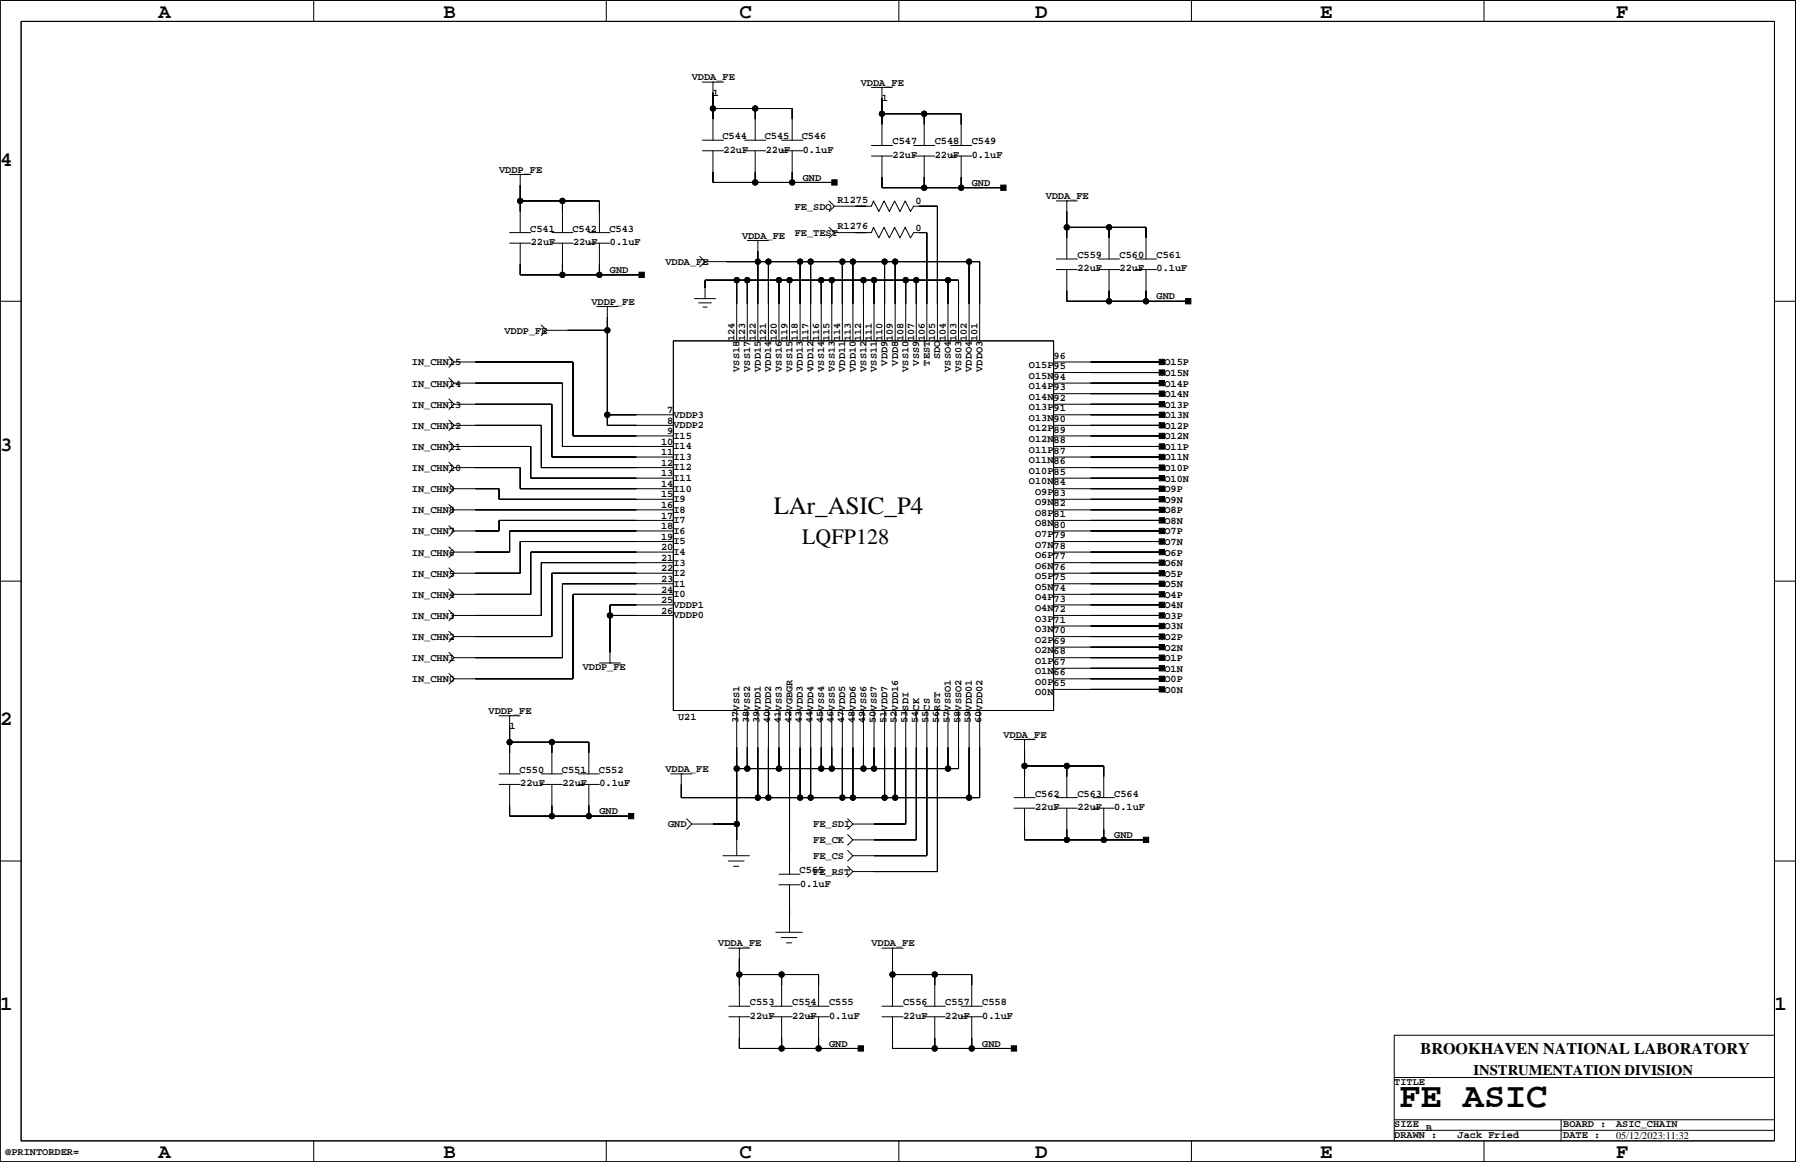
[picture p39: page 25]

4

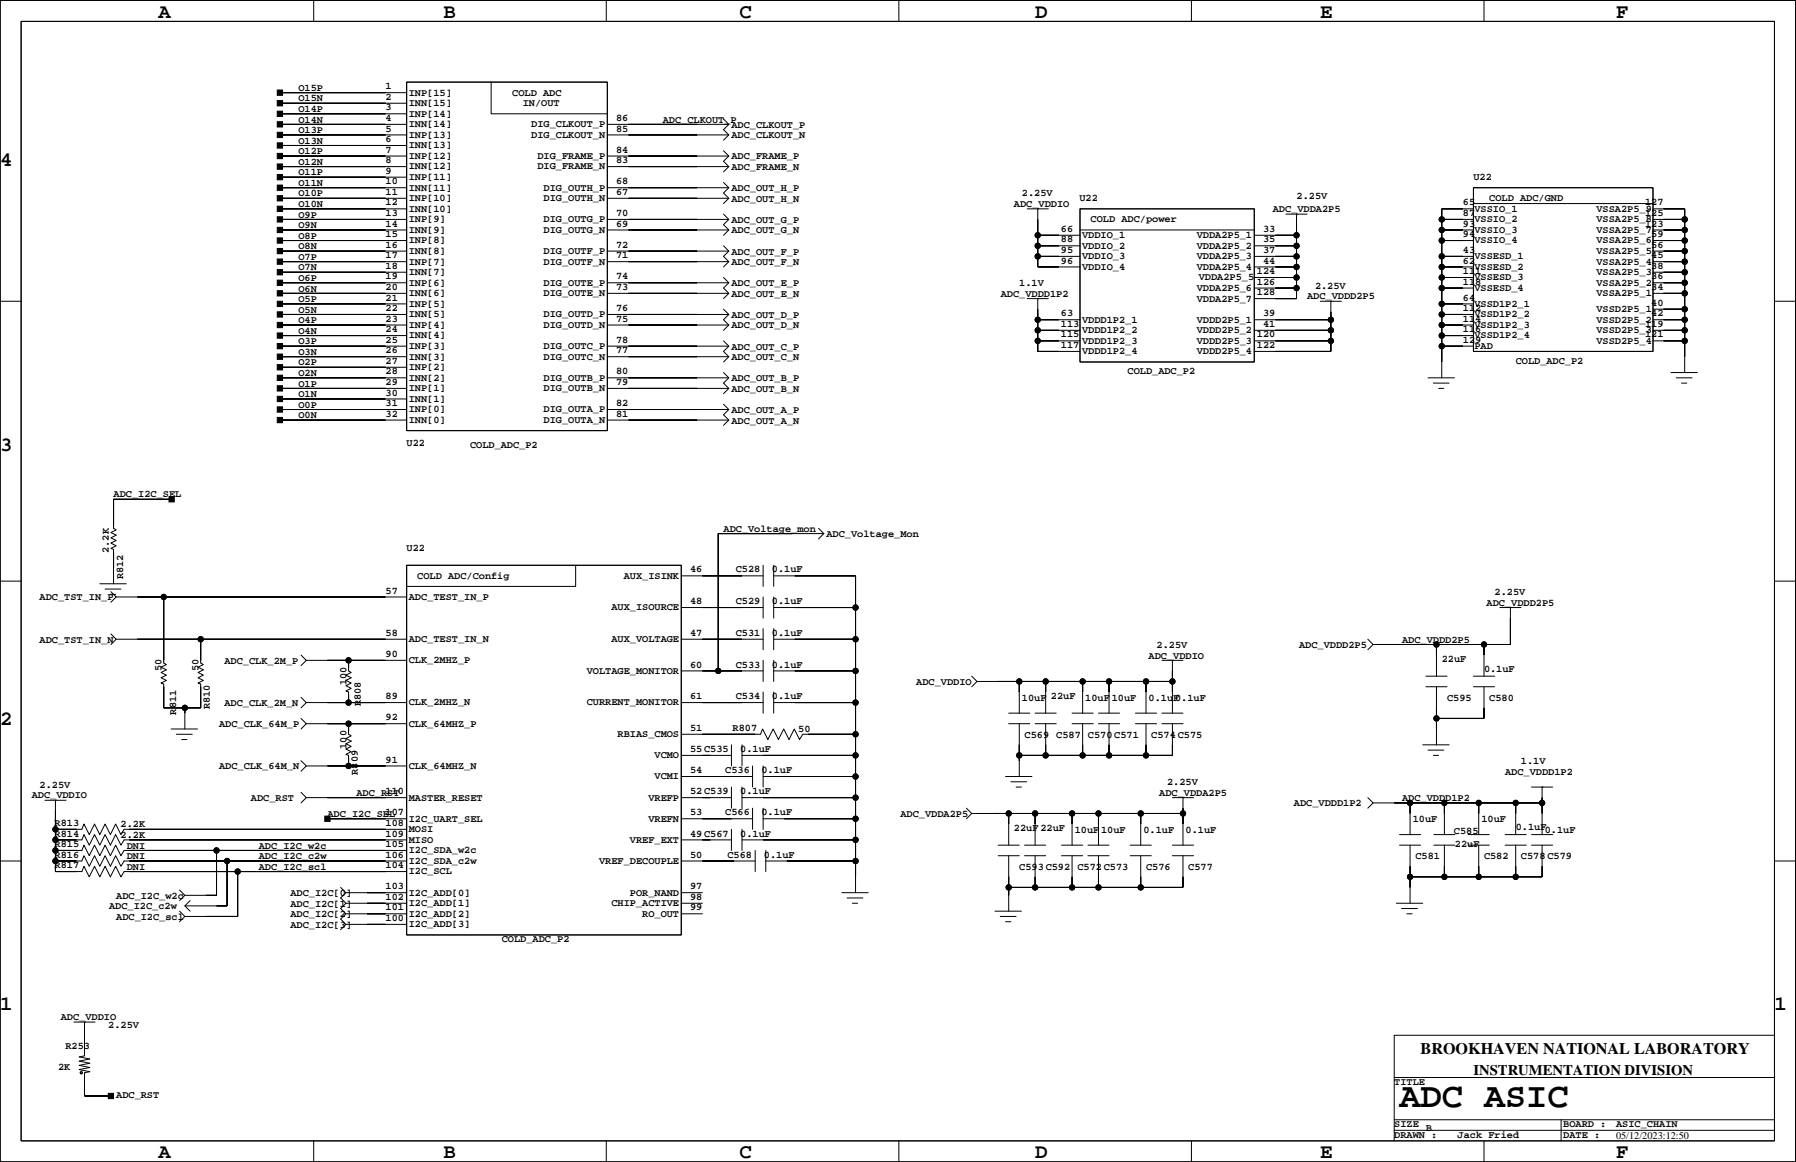
[picture p40: page 26]

C

D

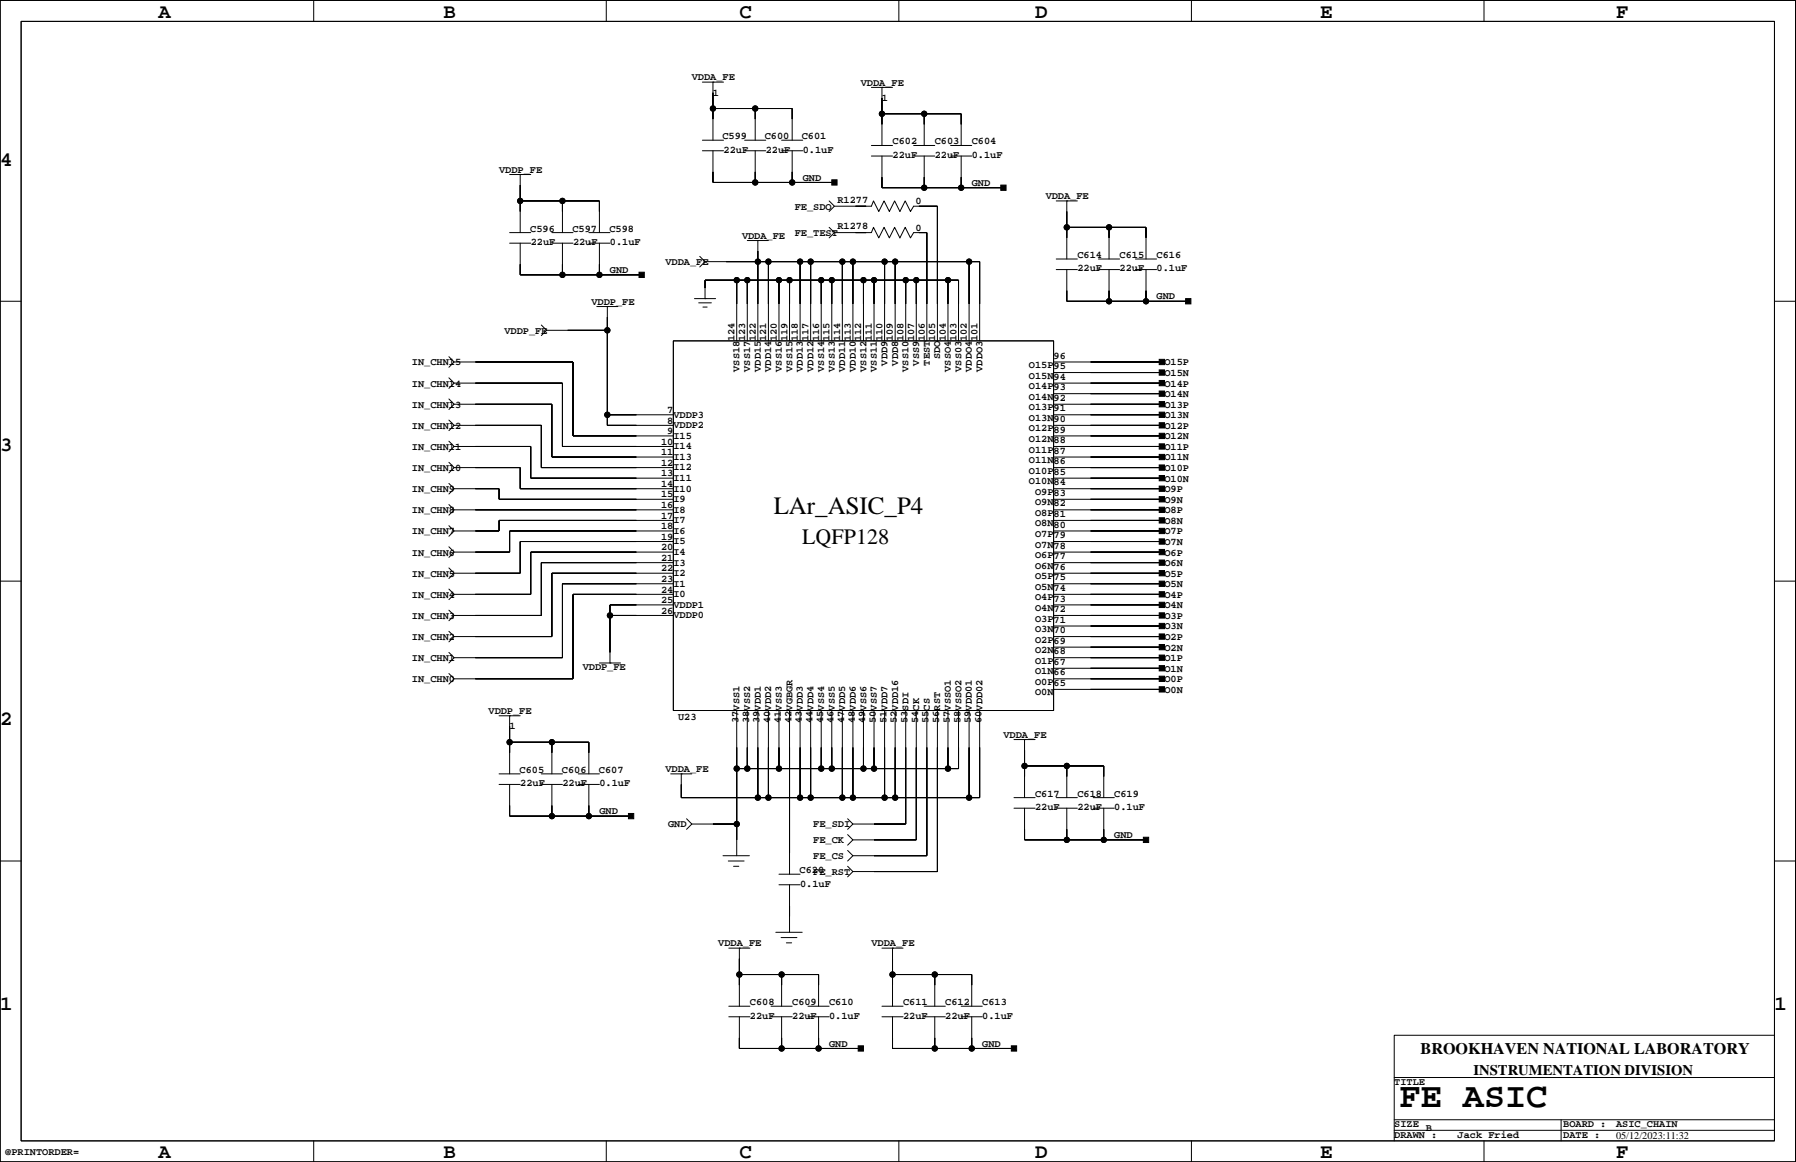
[picture p41: page 27]

4

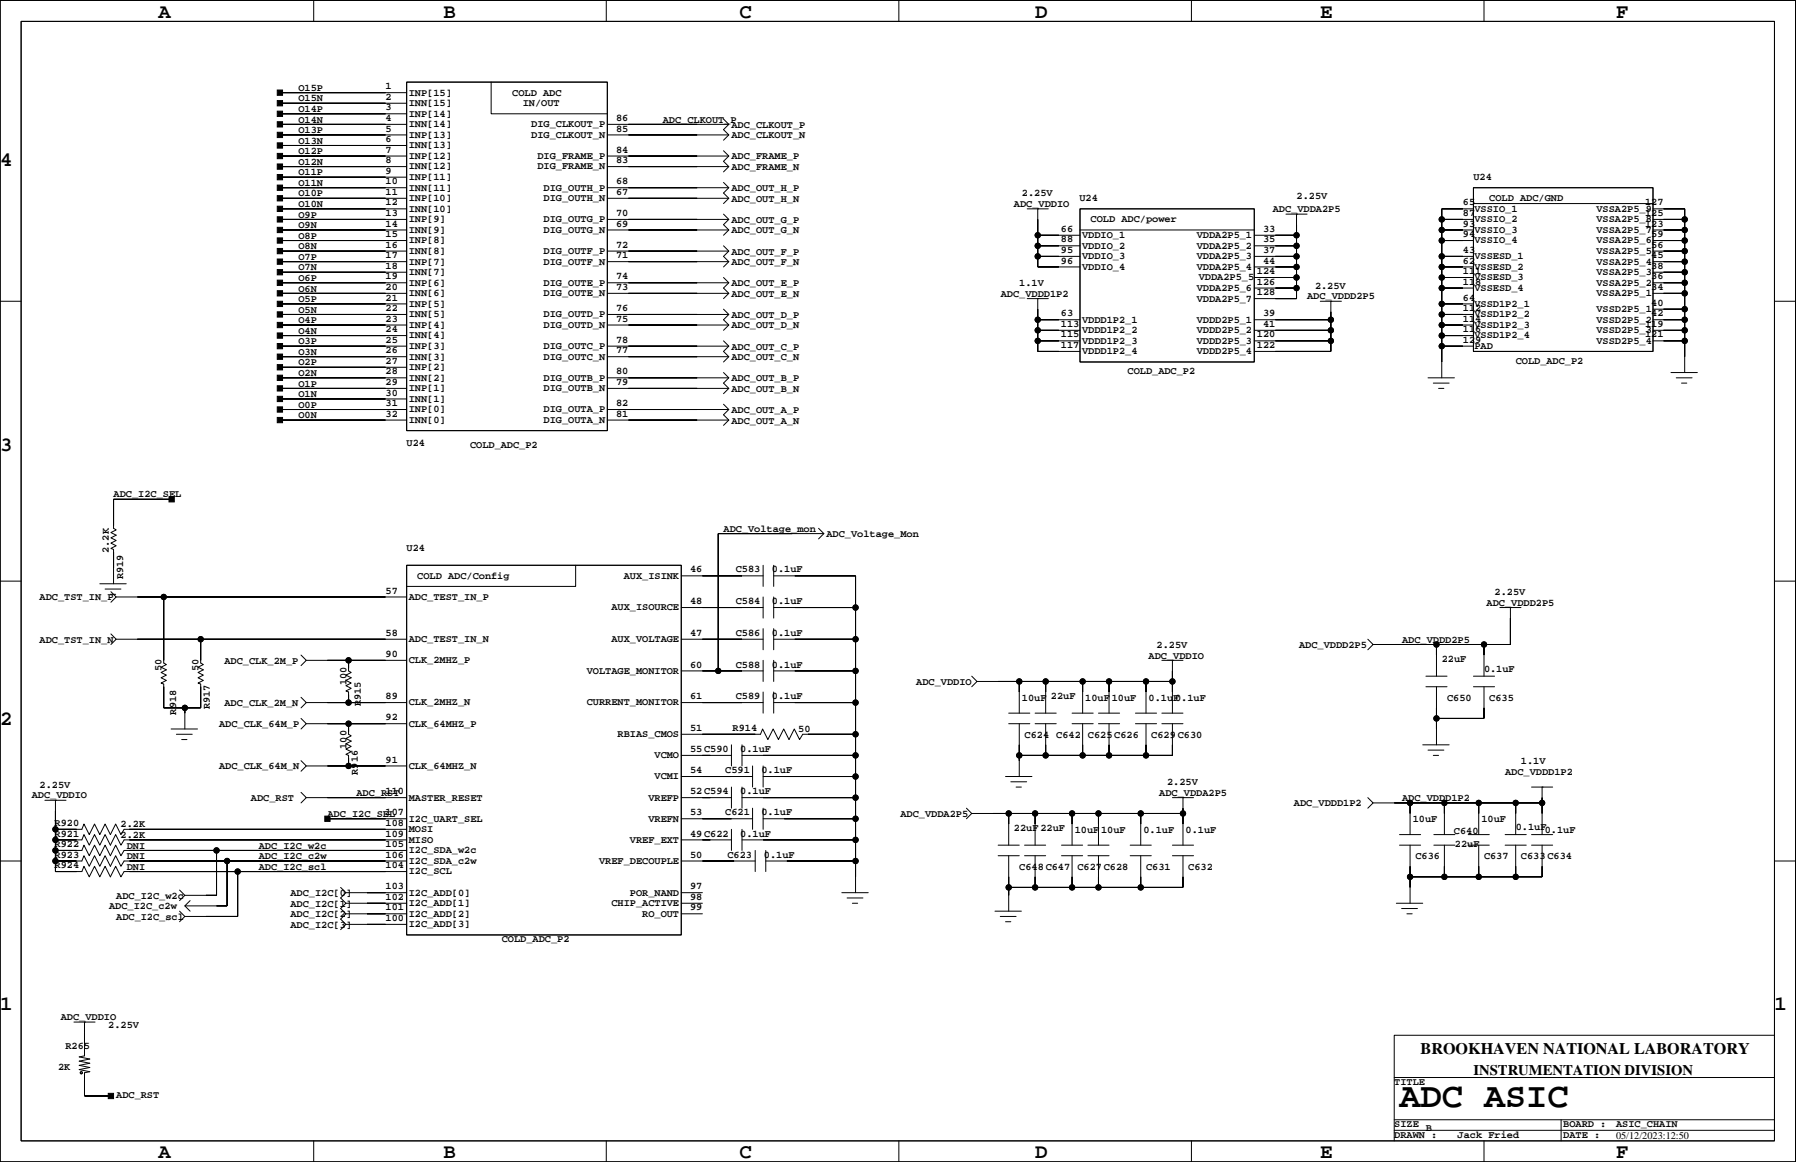
[picture p42: page 28]

C

D

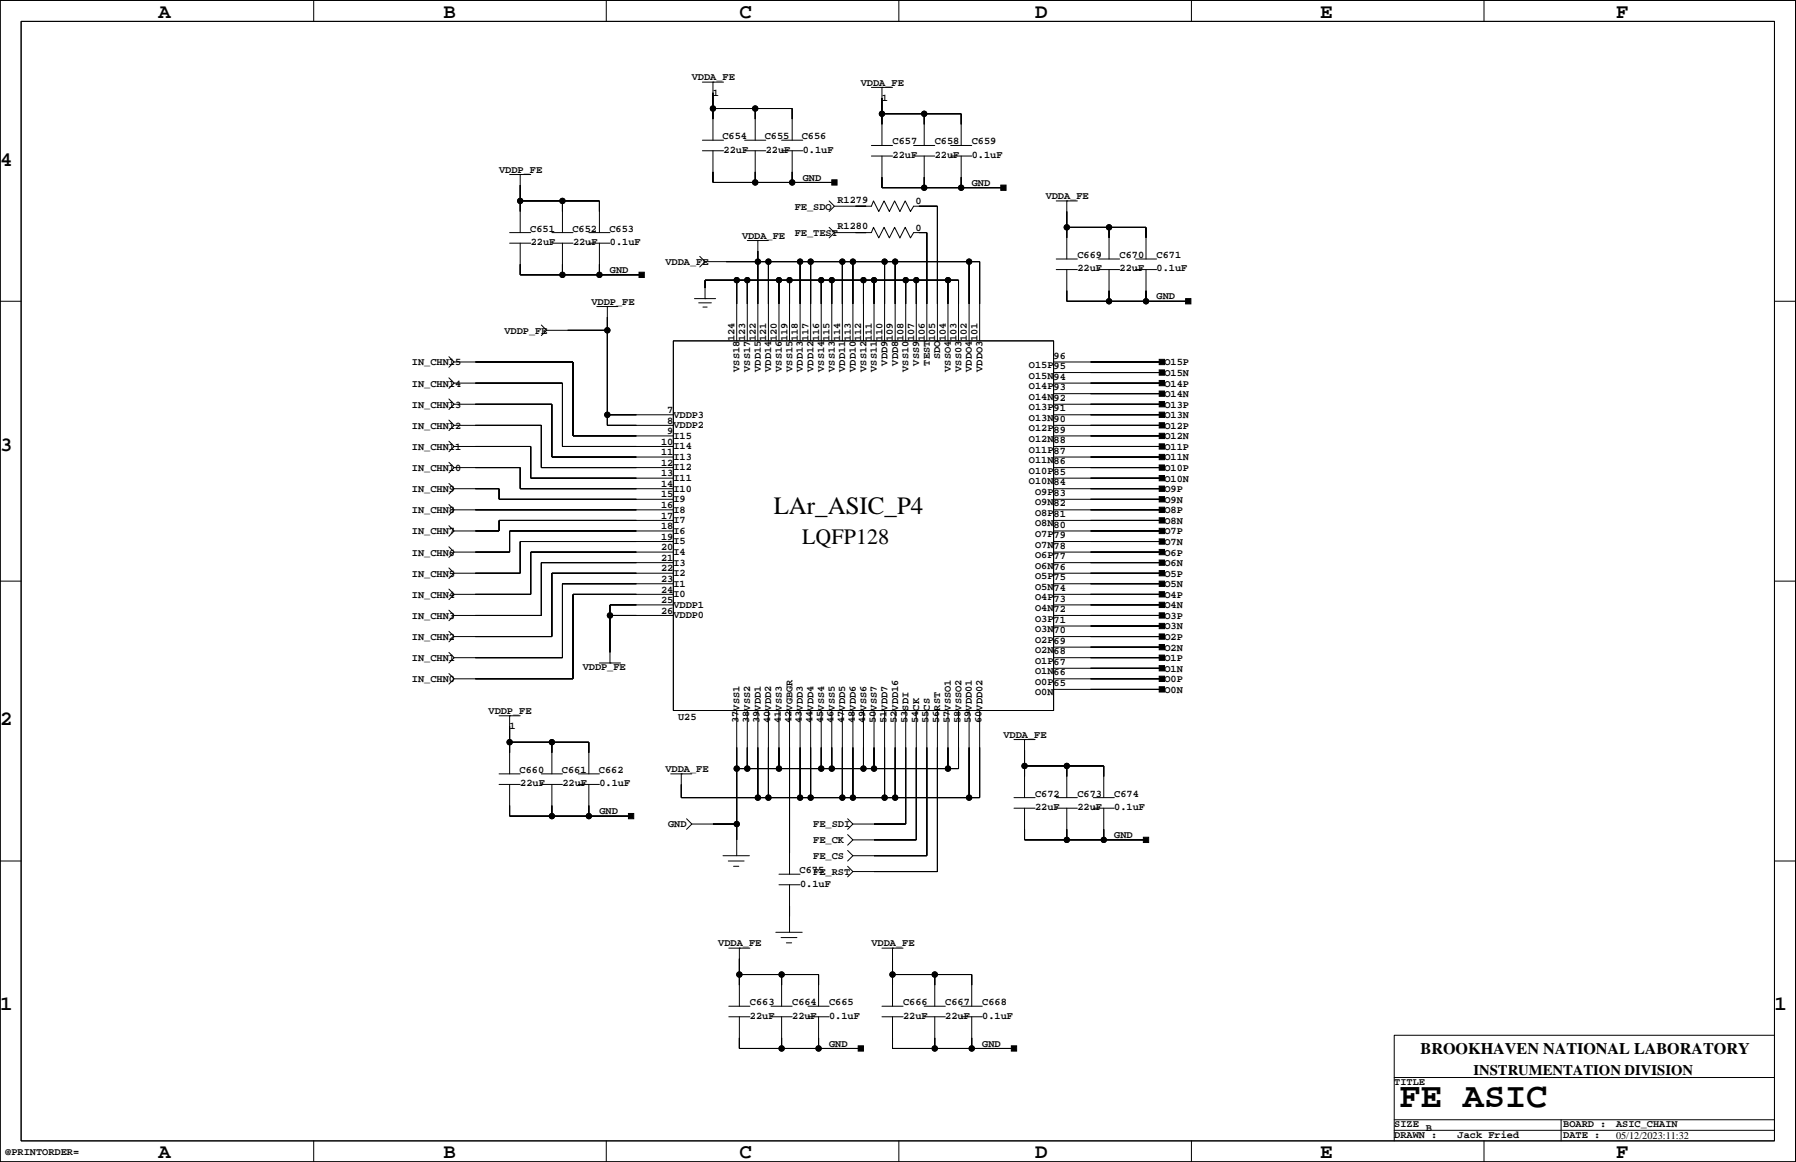
[picture p43: page 29]

4

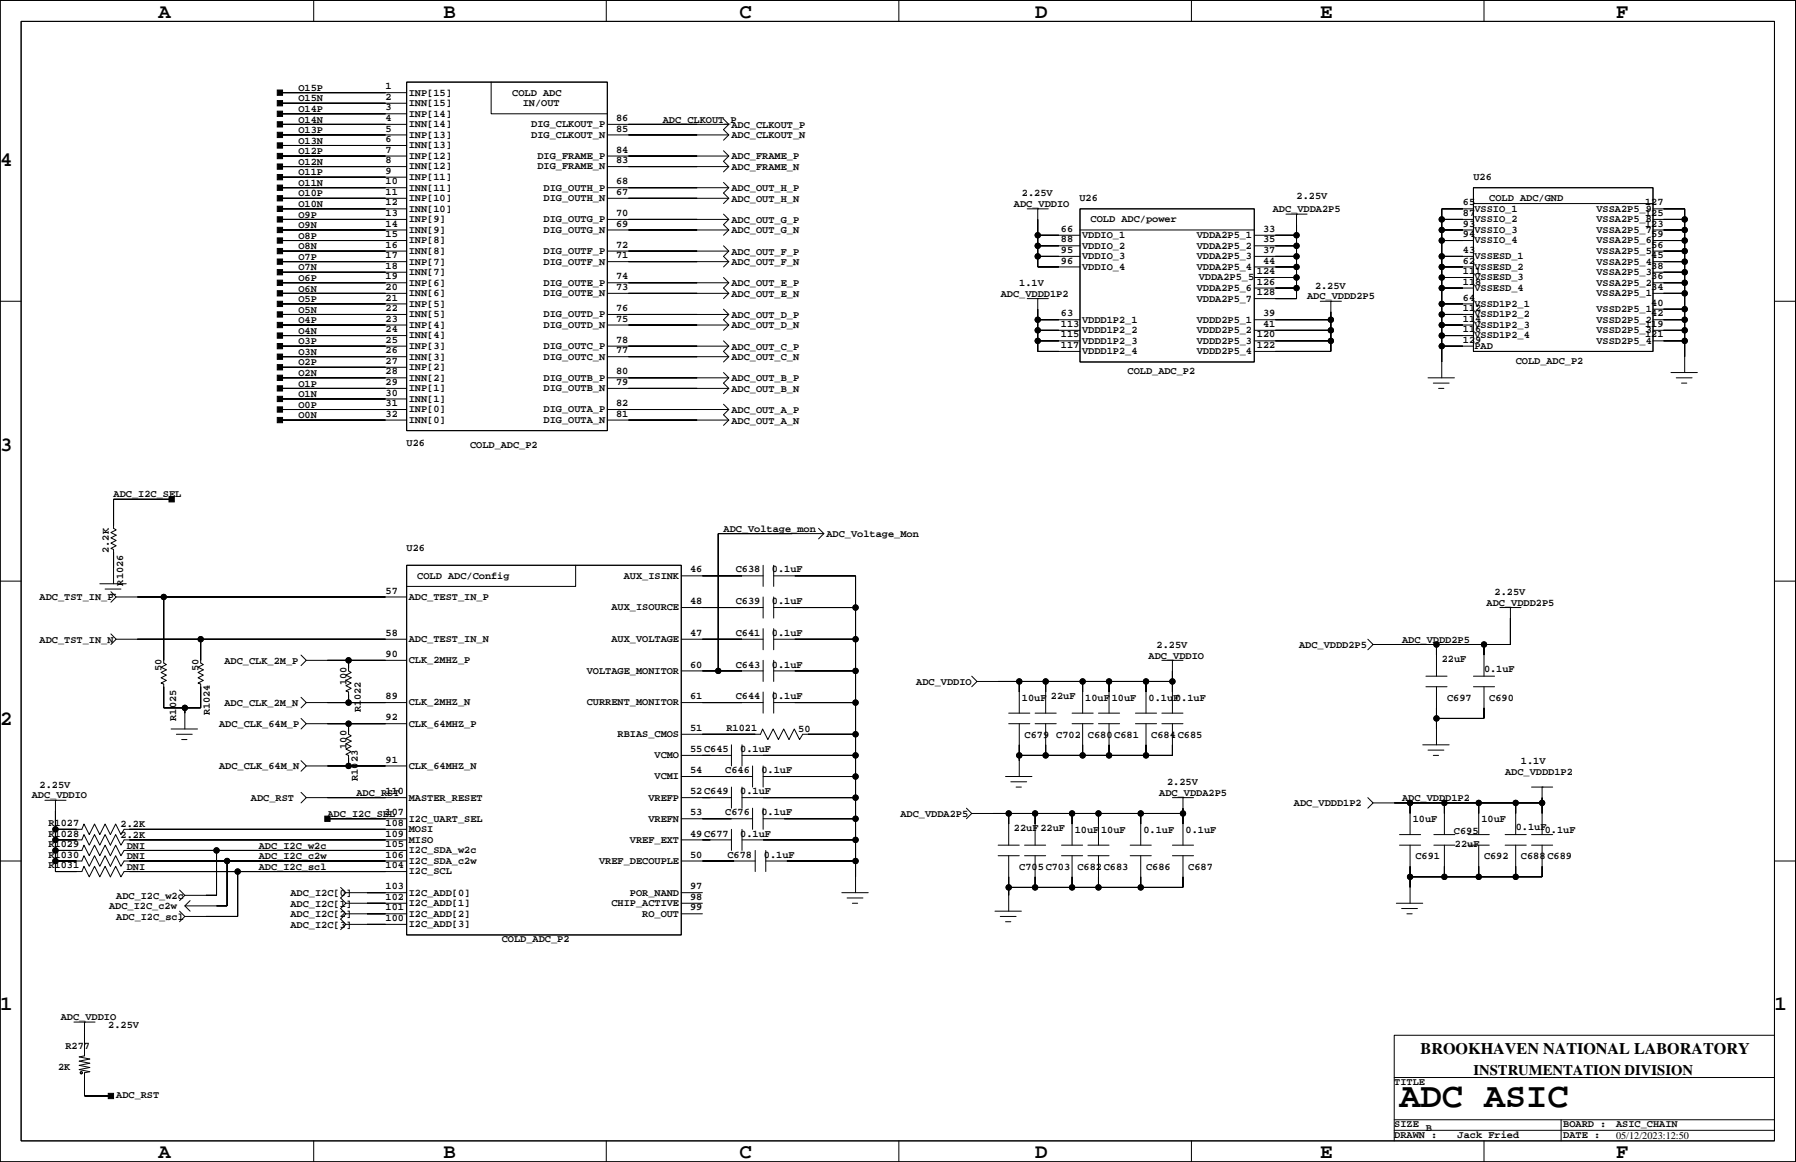
[picture p44: page 30]

4

# LVDS TERMINATION

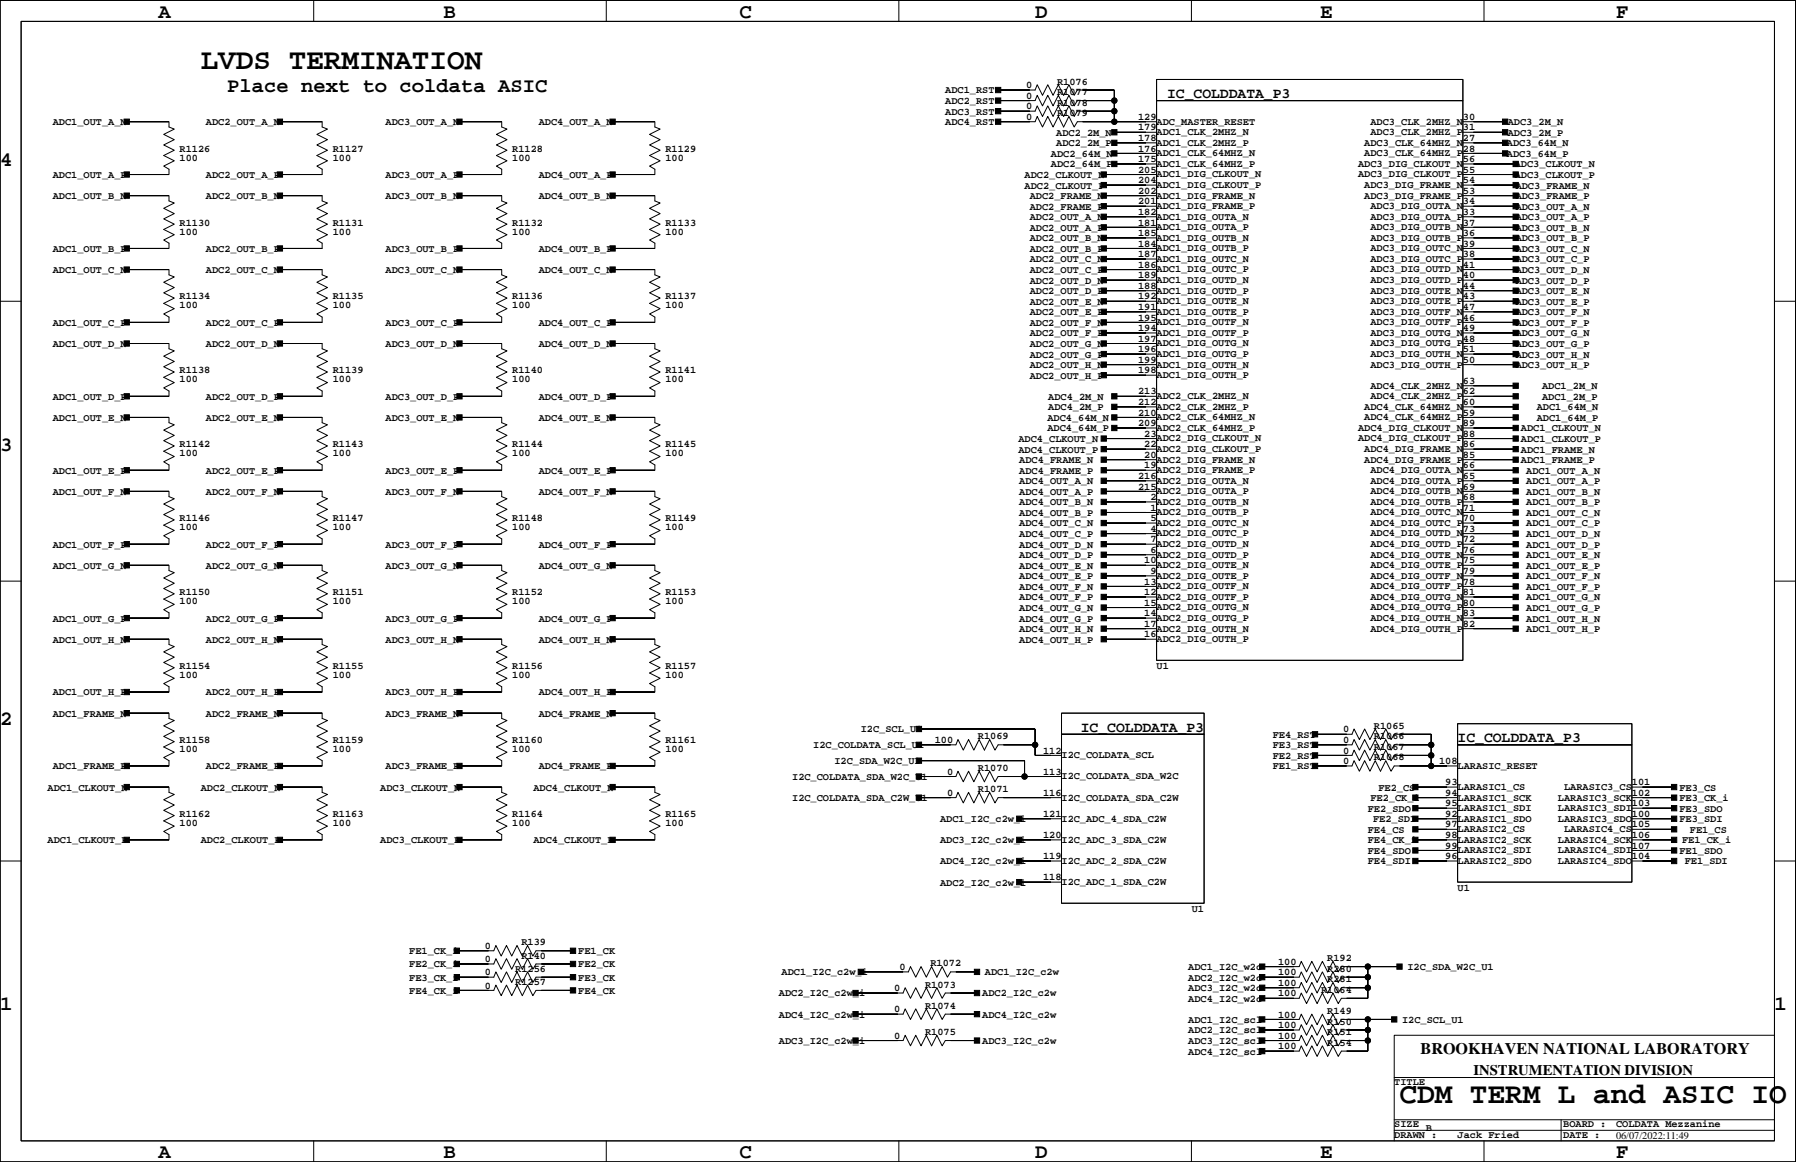
[picture p45: page 31]

I2C_SCL_U1
BROOKHAVEN NATIONAL LABORATORY
CDM TERM L and ASIC IO

4

# LVDS TERMINATION

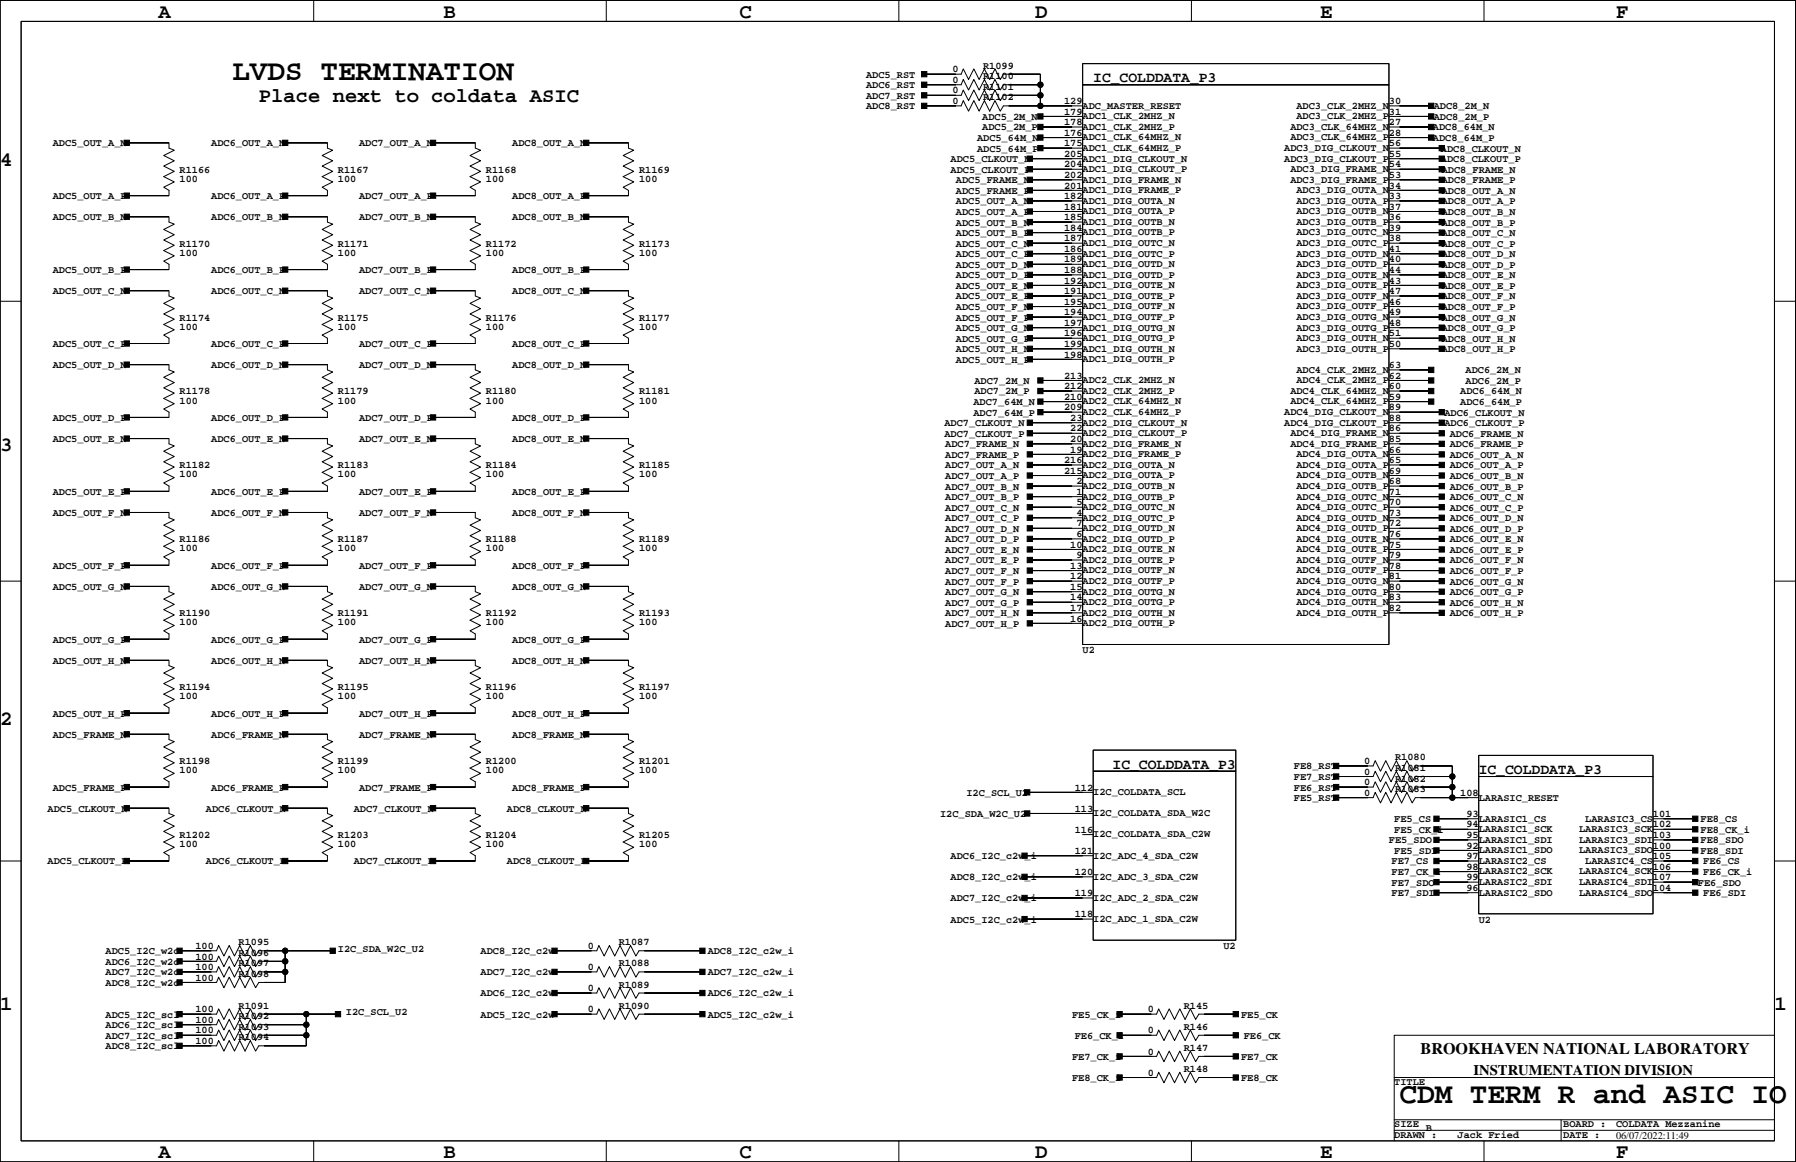
[picture p46: page 32]

Place next to coldata ASIC

BROOKHAVEN NATIONAL LABORATORY
CDM TERM R and ASIC IO

4

# Minisas to

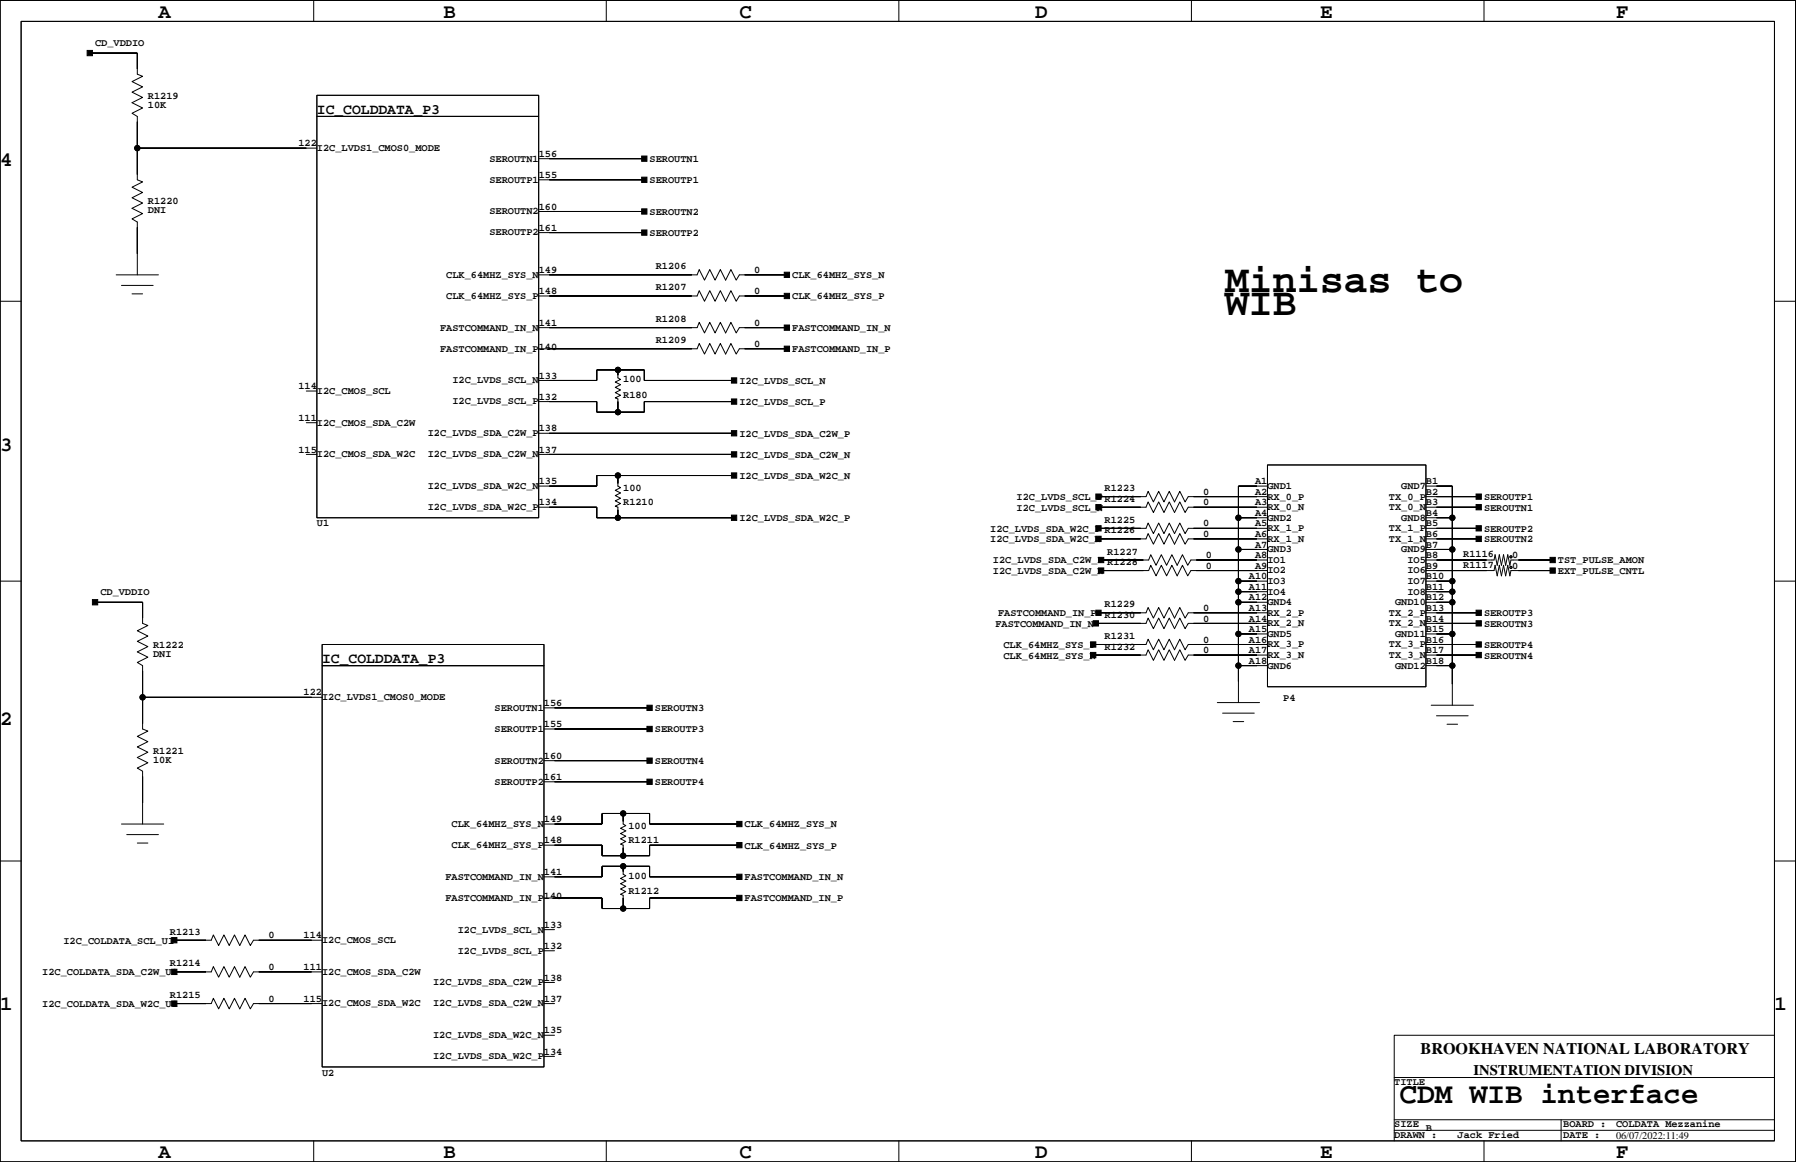
[picture p47: page 33]

4

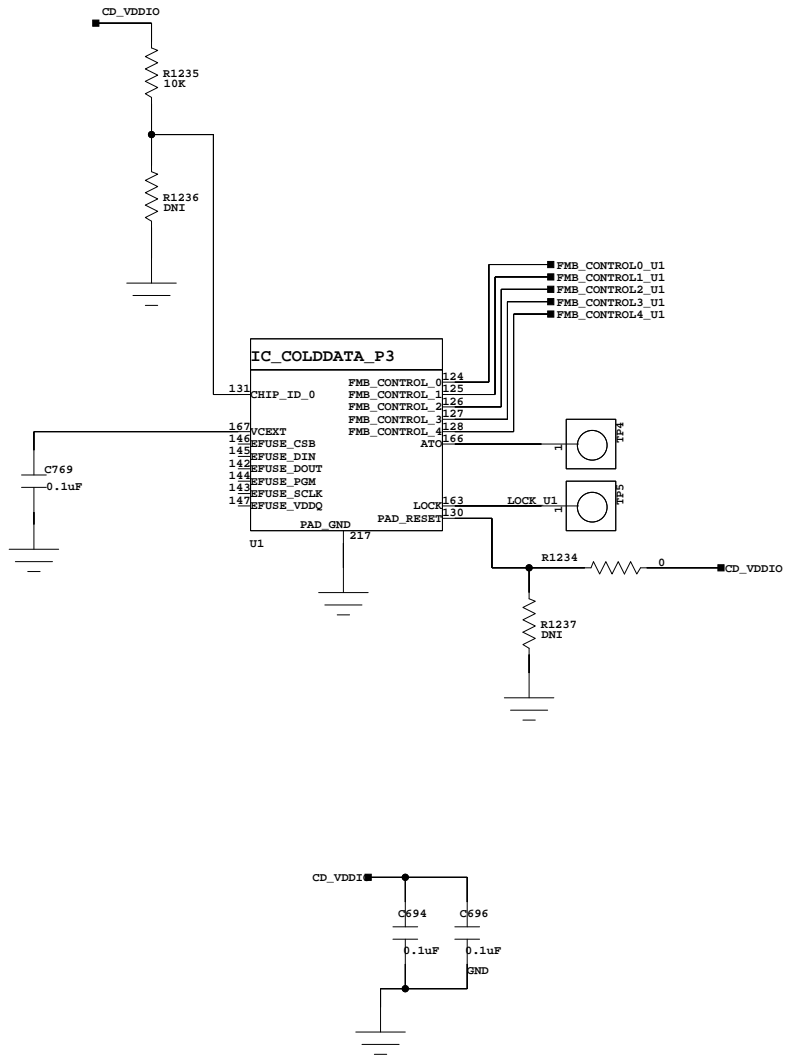
[picture p48: page 34]

BROOKHAVEN NATIONAL LABORATORY
CDM Left msic io

4

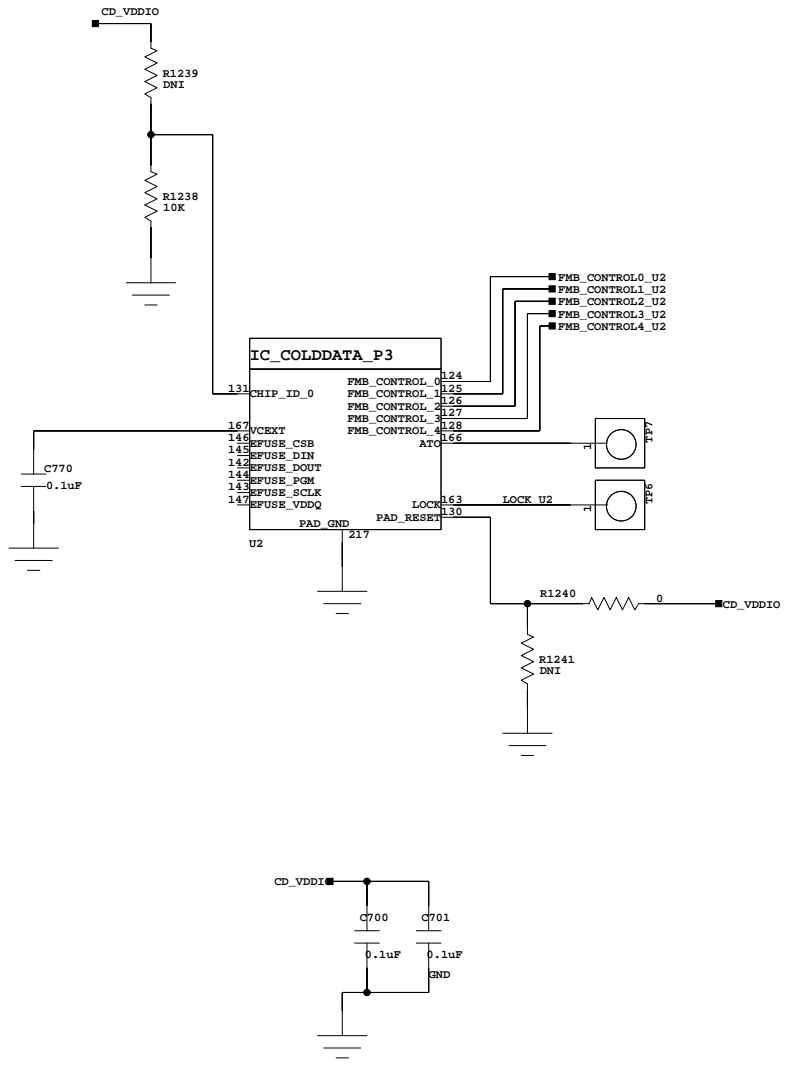
[picture p49: page 35]

BROOKHAVEN NATIONAL LABORATORY
CDM Right misc io

4

IC_COLDDATA_P3 | CD_VDDA

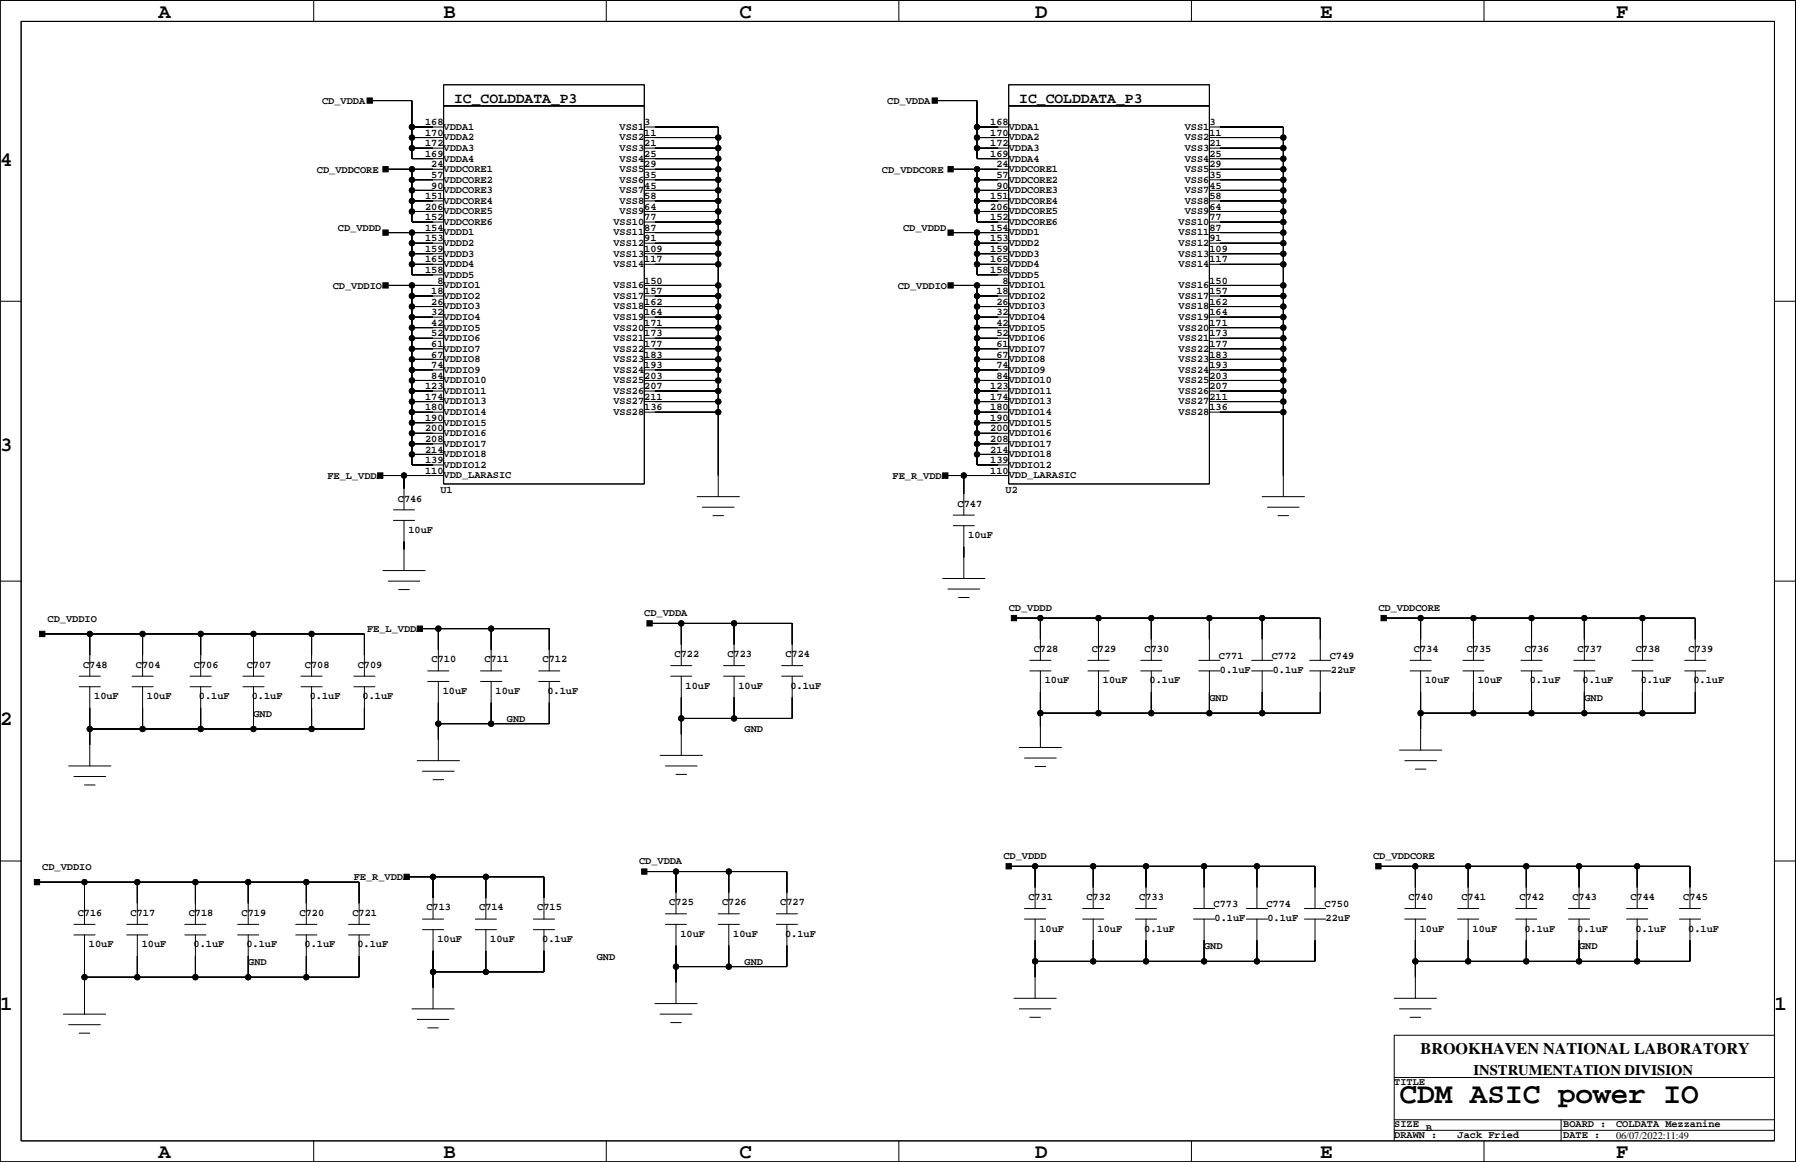
[picture p50: page 36]

BROOKHAVEN NATIONAL LABORATORY
CDM ASIC power IO

4

0.1 R1242 | 0 R1243

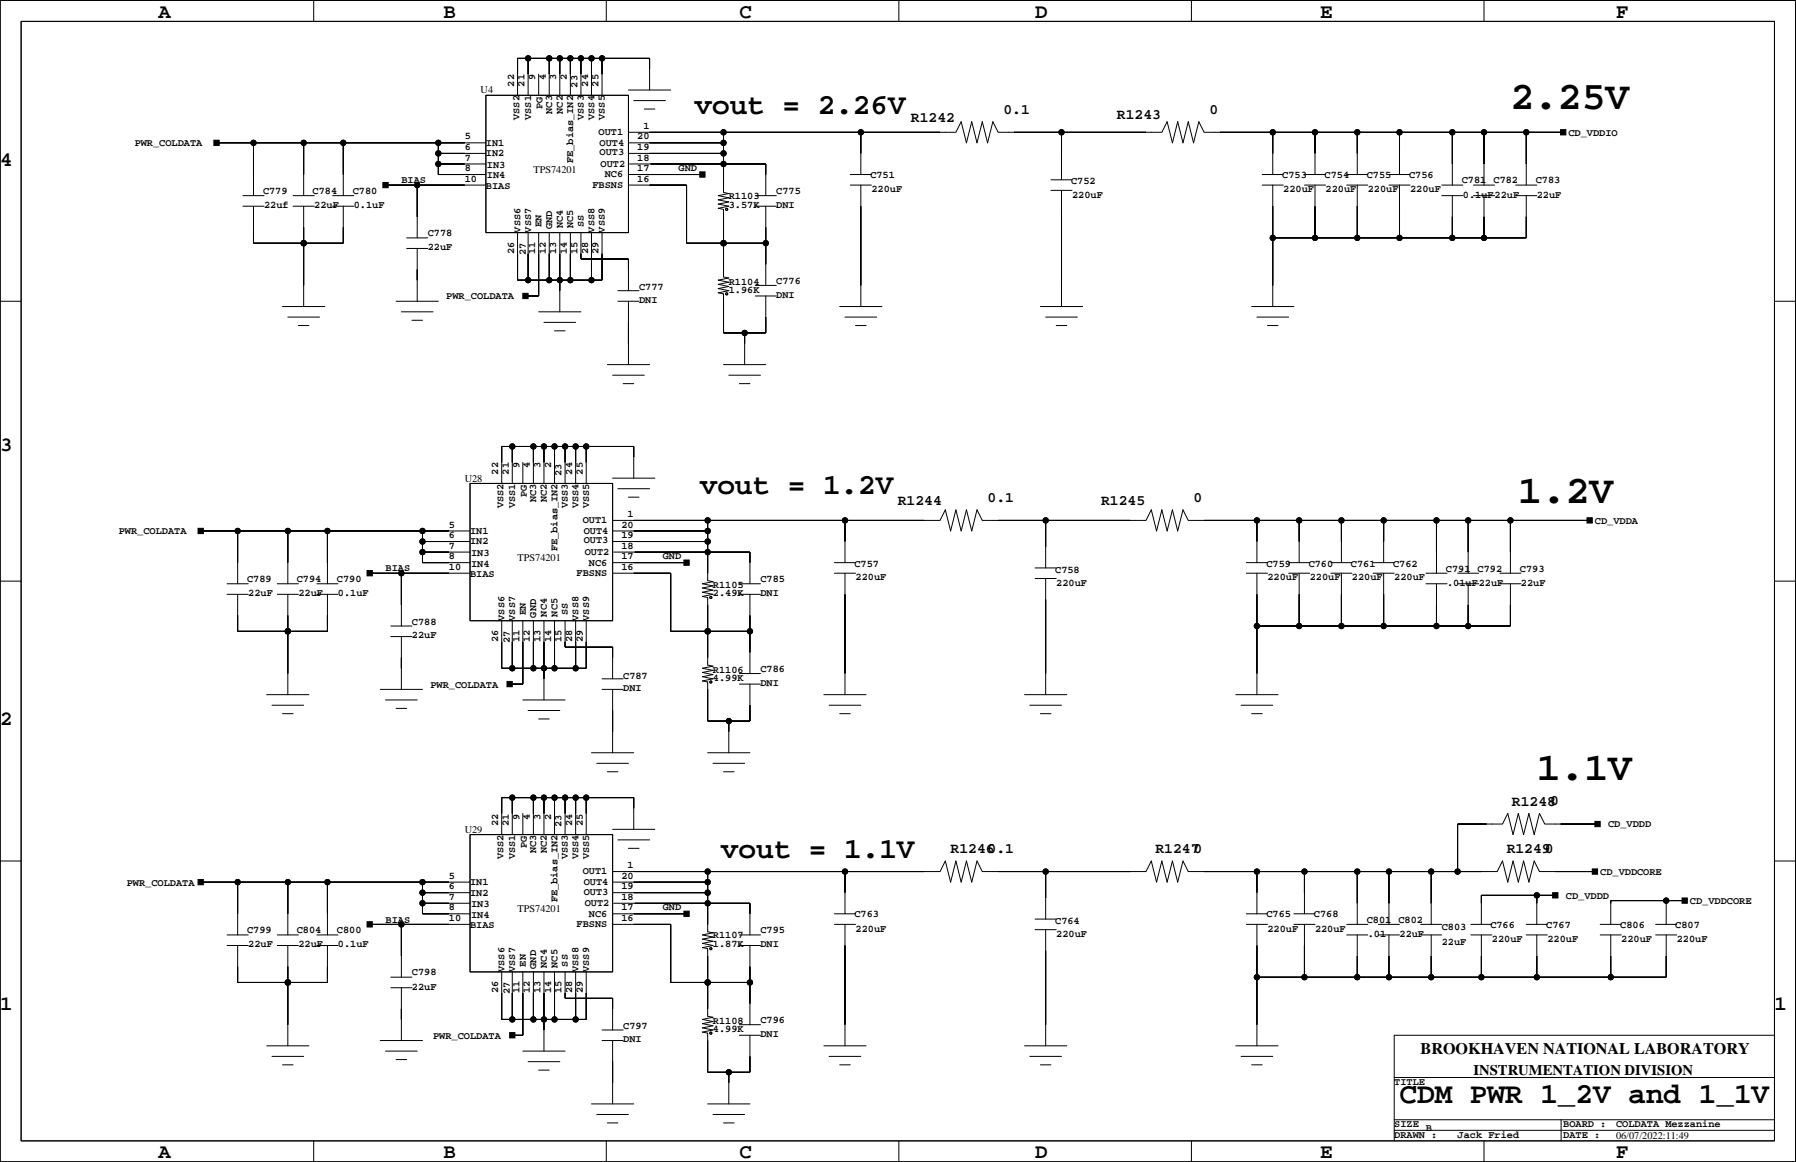
[picture p51: page 37]

4

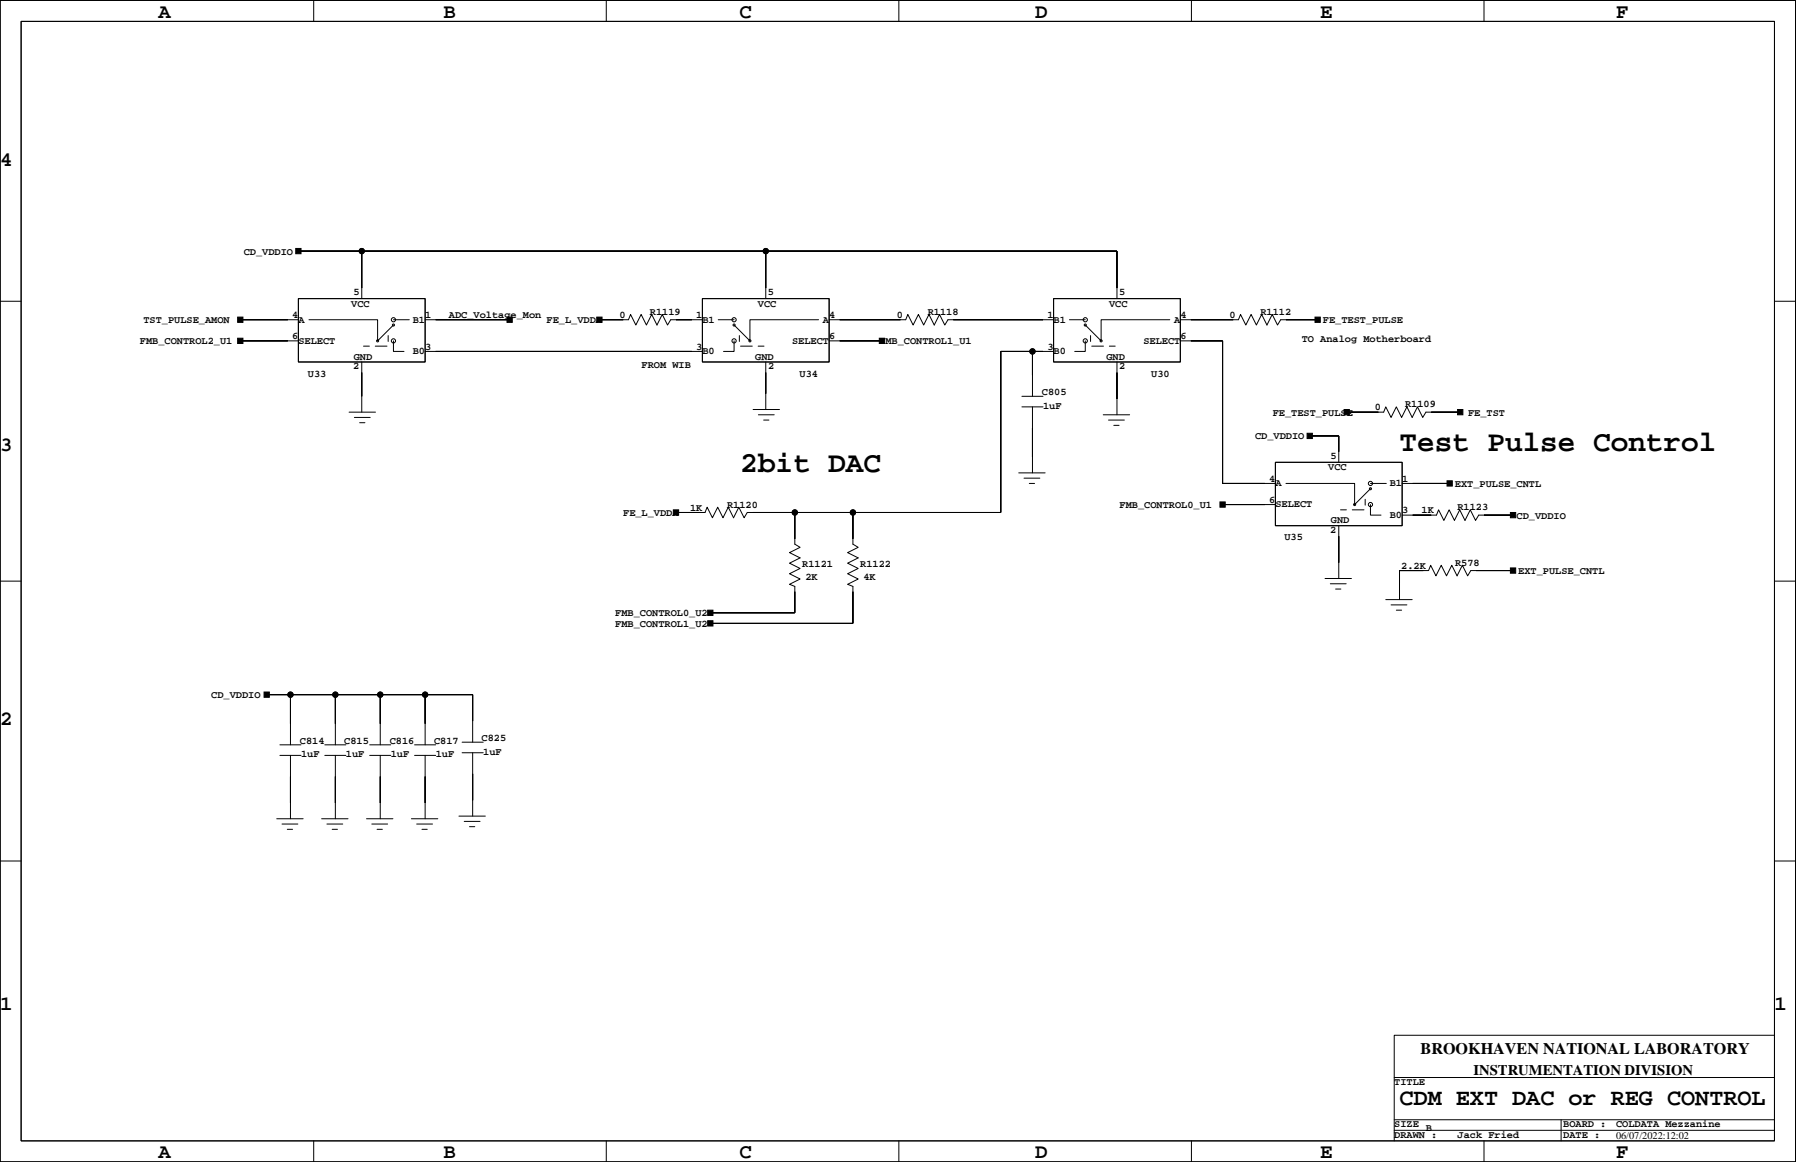
[picture p52: page 38]

BROOKHAVEN NATIONAL LABORATORY
CDM EXT DAC or REG CONTROL

4

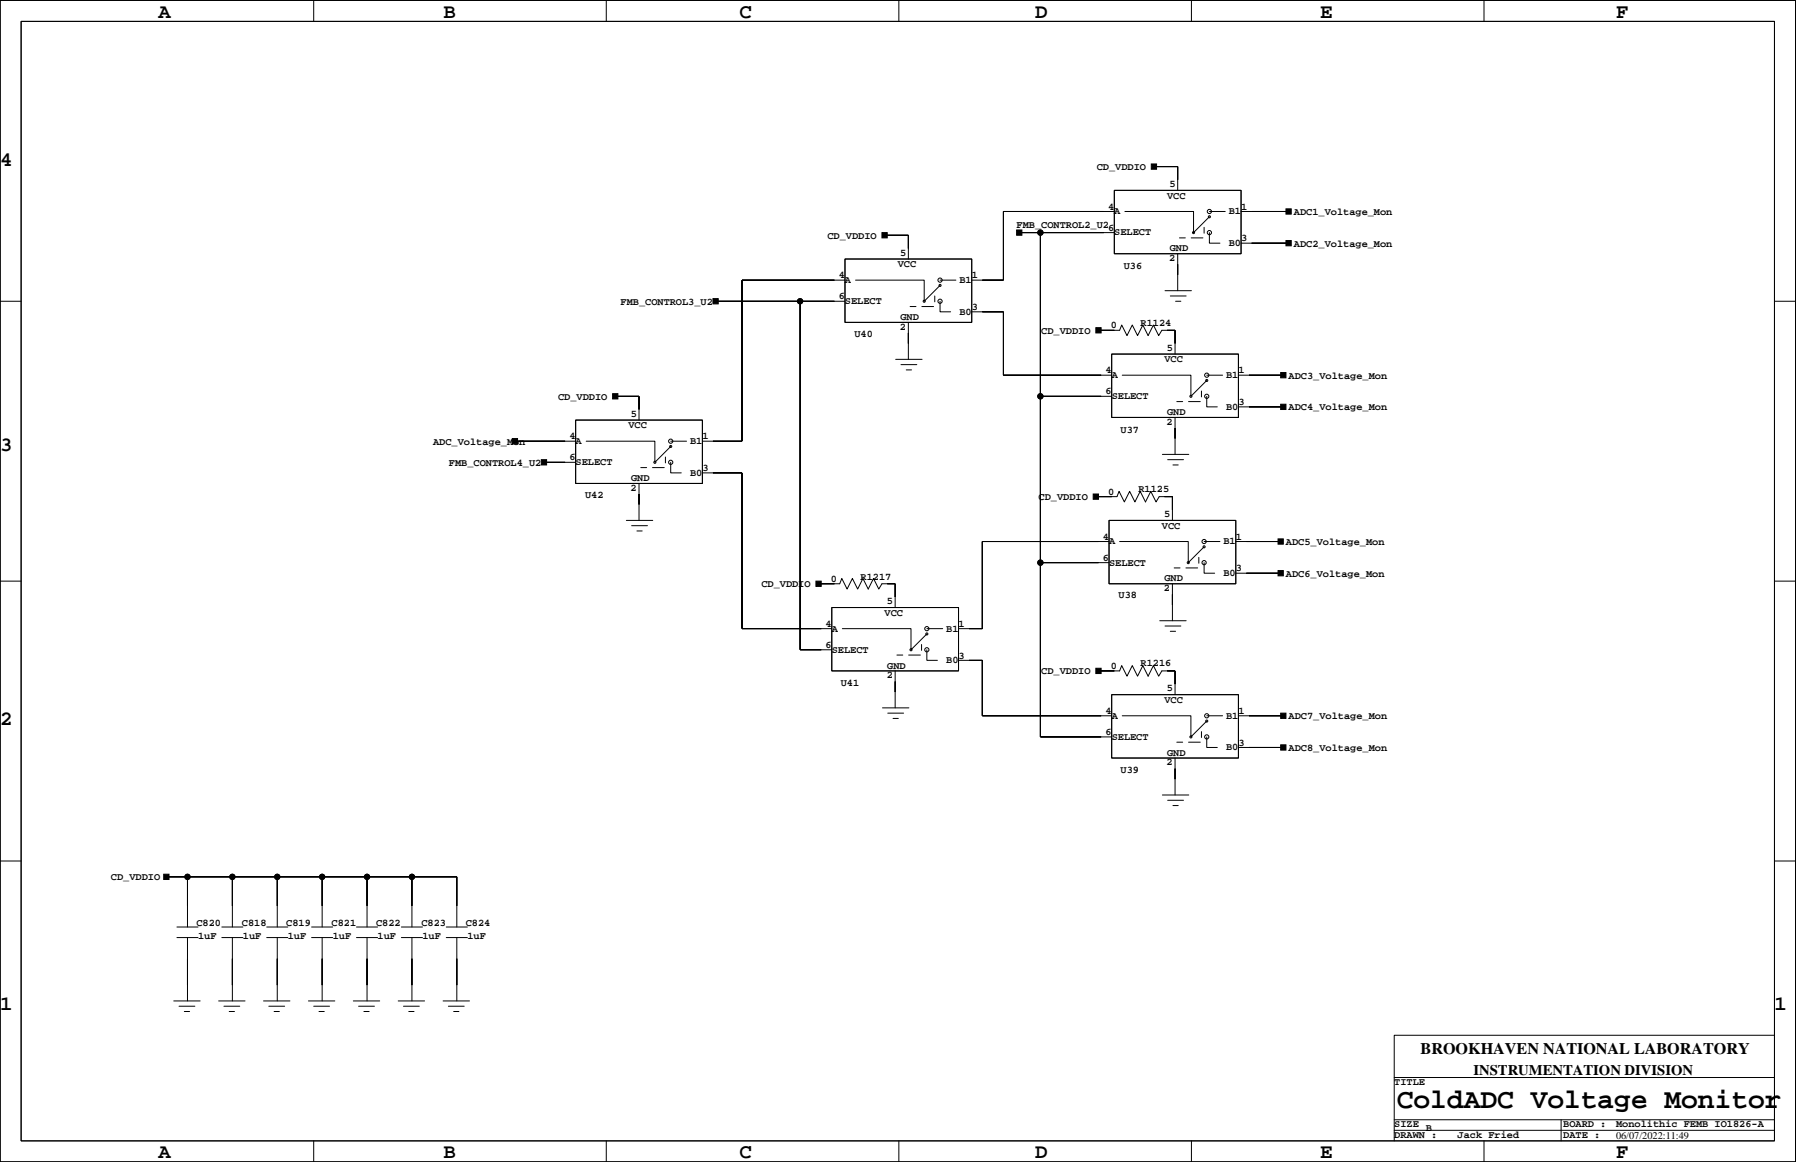
[picture p53: page 39]

BROOKHAVEN NATIONAL LABORATORY
ColdADC Voltage Monitor Select
