lkebnl/CE_HLM/(list of files, drawings)

Other design files:
FEMB_PADS_EXPORT/02_pcb/pads_layout_native/io1826-1f.pcb
FEMB_PADS_EXPORT/02_pcb/pads_layout_native/io1865-1f.pcb
